BRAVOTEAM135/Quadcopter/Original Project/Documentation/Circuit Design/Gerber/Quadcopter Schematic Rev 001_drill.txt

; NON-PLATED HOLES START AT T1
; THROUGH (PLATED) HOLES START AT T100
M48
INCH
T1C0.165354
T100C0.038000
T101C0.040000
T102C0.036000
%
T1
X027750Y027739
X027750Y001739
X001750Y027739
X001750Y001739
T100
X004750Y007739
X023750Y007739
X004750Y011739
X023750Y011739
X022750Y007739
X022750Y011739
X006750Y005739
X005750Y005739
X024750Y005739
X004750Y009739
X023750Y009739
X004750Y013739
X022750Y009739
X006750Y007739
X006750Y011739
X005750Y007739
X024750Y007739
X005750Y011739
X024750Y011739
X006750Y009739
X004750Y005739
X023750Y005739
X006750Y013739
X005750Y009739
X024750Y009739
X022750Y005739
X005750Y013739
T101
X006750Y019739
X022750Y020739
X022750Y021739
X022750Y018739
X006750Y020739
X022750Y019739
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
