BRAVOTEAM135/Quadcopter/Original Project/Documentation/Circuit Design/Gerber/Quadcopter Schematic Rev 001_pnp.txt

*Pick And Place List
*Company=
*Author=
*eMail=
*
*Project=Quadcopter Schematic Rev 001
*Date=14:08:56
*CreatedBy=Fritzing 0.9.2b.11.19.8d2d5970658f0bed09c661c9ea9a515b5f40f44c
*
*
*Coordinates in mm, always center of component
*Origin 0/0=Lower left corner of PCB
*Rotation in degree (0-360, math. pos.)
*
*No;Value;Package;X;Y;Rotation;Side;Name
1;;THT;14.6053;-24.7382;-90;Bottom;ELEV
2;;;5.46016;-24.4603;0;Bottom;TXT2
3;;;70.4853;-4.4182;0;Bottom;Hole3
4;;THT;14.6053;-34.8982;-90;Bottom;THRO
5;;;38.7486;-70.4971;0;Bottom;TXT3
6;;THT;58.2933;-51.5352;0;Bottom;IMU
7;;THT;14.6053;-14.5782;-90;Bottom;AUX
8;;;5.40315;-29.6391;0;Bottom;TXT2
9;;THT;14.6053;-19.6582;-90;Bottom;ALIE
10;;;60.1238;-58.5074;0;Bottom;TXT4
11;;;8.35918;-58.1035;0;Bottom;TXT4
12;;THT;16.6373;-52.5512;180;Bottom;Digital IO
13;;;68.8646;-29.6391;0;Bottom;TXT2
14;;;64.3621;-55.0948;0;Bottom;TXT4
15;;;64.295;-47.449;0;Bottom;TXT4
16;;;64.3039;-52.6872;0;Bottom;TXT4
17;;;6.63331;-52.5137;0;Bottom;TXT4
18;;;69.775;-14.2737;0;Bottom;TXT2
19;;;6.23352;-55.3668;0;Bottom;TXT4
20;;;4.44528;-4.4182;0;Bottom;Hole4
21;;THT;60.3253;-19.6582;90;Bottom;M3
22;;;6.69178;-14.5088;0;Bottom;TXT2
23;;;36.9816;-11.2472;0;Bottom;TXT3
24;;THT;60.3253;-14.5782;90;Bottom;M4
25;;;37.4653;-34.8897;0;Bottom;Arduino Nano
26;;;69.3093;-24.7501;0;Bottom;TXT2
27;;;6.93445;-47.3326;0;Bottom;TXT4
28;;THT;60.3253;-29.8182;90;Bottom;M1
29;;;70.4853;-70.4582;0;Bottom;Hole1
30;;;5.55471;-34.7823;0;Bottom;TXT2
31;;THT;60.3253;-24.7382;90;Bottom;M2
32;;;65.0683;-50.3021;0;Bottom;TXT4
33;;;4.44528;-70.4582;0;Bottom;Hole2
34;;;5.40315;-19.7447;0;Bottom;TXT2
35;;THT;14.6053;-29.8182;-90;Bottom;RUDD
36;;;69.5421;-19.9775;0;Bottom;TXT2
37;;;6.92541;-50.1263;0;Bottom;TXT4
