BRAVOTEAM135/Quadcopter/Original Project/Documentation/PCB Design.docx

Track width

Thin: 1A

Normal: 1.5A

Thick: 2A

Extra thick: 2.5A
