BRAVOTEAM135/Quadcopter/Documentation/Quadcopter research_.docx

Quadcopter

Motor and propellor research

What I need is a motor and propellor combination that will provide 500g or more lift per motor.

Parameters

- Length of prop

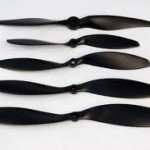
[picture p24: figure]

Propellers are available in different diameters and pitches (tilting). Check frame size and choose a motor.

Standard quadcopter propeller sizes:

EPP1045 diameter 10in and pitch 4.5

APC1047 diameter 10in and pitch 4.7

EPP0845 diameter 8in and pitch 4.5

EPP1245 diameter 12in and pitch 4.5 (larger quads/greater thrust)

EPP0938 diameter 9in and pitch 3.8 (smaller quads)

Guide Rules to follow:

larger diameter and pitch = more thrust the propeller can generate

requires more power to drive it, but it will lift more weight.

high RPM motors best with smaller or mid-sized propellers.

low RPM motors best with larger propellers otherwise will fail to lift the quad at low speed.

- Pitch of prop
- Motor kv (I believe this is the rpm per volt we have 11.1v battery)

Max current draw per motor 20amp as I want to use a 20 amp ESC (electronic speed controller) but I do have 30amp esc 8f we need to go higher we can although my wiring is rated for 30amp.

Possible options

NTM Prop Drive Series 2826 1000kv (£9.89)

Weight 54g

ESC 20-30a

9x4.7 - 11.1v - 113W - 10.2A - 0.632kg thrust

9x6 - 14.8v - 220w - 14.9A - 0.937kg thrust

Accessories pack

NTM Prop Drive 28 series accessories pack (£1.28)

ESC

Hobbywing X-Rotor ESC 40amp (OPTO) (£10)

Propellers

9x4.7 CW (£0.99)

9x4.7 CCW (£0.99)

BOM (Bill of Materials)

[x5] Hobbywing X-Rotor ESC - 40amp (OPTO)

http://www.hobbyking.com/hobbyking/store/__73080__Hobbywing_X_Rotor_ESC_40amp_OPTO_.html

[x5] NTM Prop Drive 28-26 1000KV / 235W

http://www.hobbyking.com/hobbyking/store/__21478__NTM_Prop_Drive_28_26_1000KV_235W.html

[x4] NTM Prop Drive 28 Series Accessory Pack

http://www.hobbyking.com/hobbyking/store/__16719__NTM_Prop_Drive_28_Series_Accessory_Pack.html

[x1] HobbyKing™ Slowfly Propeller 9x4.7 Black (CCW) (4pcs)

http://www.hobbyking.co.uk/hobbyking/store/__22442__HobbyKing_8482_Slowfly_Propeller_9x4_7_Black_CCW_4pcs_.html

[x1] Turnigy Slowfly Propeller 9x4.7 Black (CW) (4pcs)

http://www.hobbyking.co.uk/hobbyking/store/__34084__Turnigy_Slowfly_Propeller_9x4_7_Black_CW_4pcs_.html

Cost £3.44

54g. *Sunday 10/01/16 (Is this total weight for 4 propellers? Or is this the weight of a single propeller).

Test 08/01/16

With d2830-11 turnigy aerodrive 1000kv

Turnigy plush 30a

10x4.5 propellers

Static weight 1130g (this is the weight of the quad stationary).

Throttling up to about 95% throttle close to 10a draw total from all 4 motors. Scales read 500g

This implies that approx 630g of lift is being generated.

This suggests to me that the motors can be pushed harder I will look into the software to ensure I am allowing for max throttle value is being passed through and scaled correctly through the controller board.

Statement of next test

- Use 34084 Turnigy Slowfly Propeller 9in x pitch 4 7 Black CW
- Shall we try:
- http://www.hobbyking.co.uk/hobbyking/store__46967__HobbyKing_8482_Thin_E_Prop_Propeller_10x5_2pcs_.html
- £1.41per 2 blades. Available CCW and CW I assume!
- Throttle directly to 95%, 10a current draw on all 4 motors.
- Read scales:
- What was the rpm?
- Can you set a date for this test?

Radio RX for thrust test rig

OrangeRx R615X DSM2/DSMX Compatible 6Ch 2.4GHz Receiver w/CPPM

http://www.hobbyking.co.uk/hobbyking/store/__46632__OrangeRx_R615X_DSM2_DSMX_Compatible_6Ch_2_4GHz_Receiver_w_CPPM.html

5V 5A UBEC 2-5S Lipoly (7.2-21v)

http://www.hobbyking.co.uk/hobbyking/store/__18789__5V_5A_UBEC_2_5S_Lipoly_7_2_21v_.html

Note

Current draw is defined by

Larger proper and larger pitch will give larger current draw

Uni t ut203

Useful links

Watch dog http://www.megunolink.com/articles/how-to-detect-lockups-using-the-arduino-watchdog/
