BRAVOTEAM135/Quadcopter/Documentation/System Diagram.docx

GND

3.3

5.0

TXD

RXD

KEY

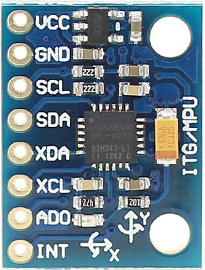
[picture p44: figure]

10K

20K
