BRAVOTEAM135/Quadcopter/Original Project/Documentation/Old/System Diagram.pdf

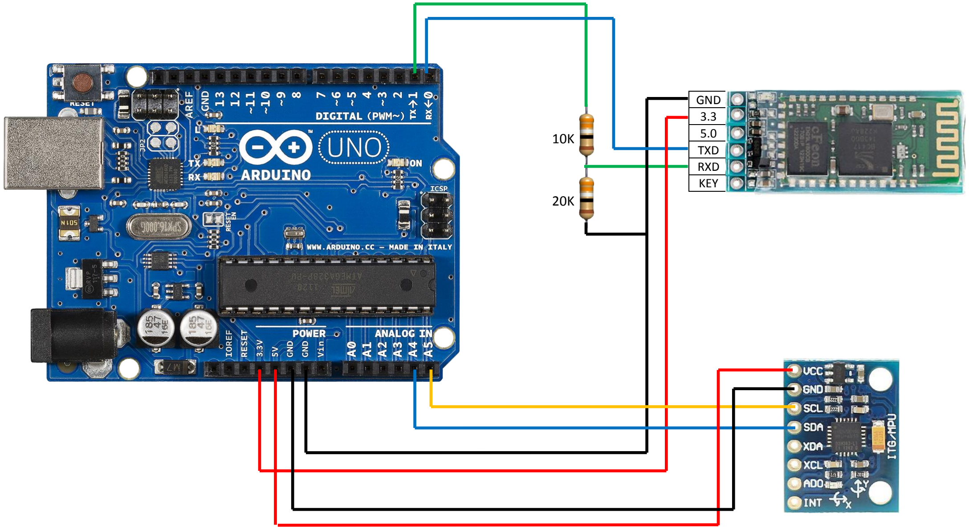
[picture p46: figure]
GND 3.3 5.0 TXD RXD KEY
