BRAVOTEAM135/Quadcopter/Documentation/image-1.png

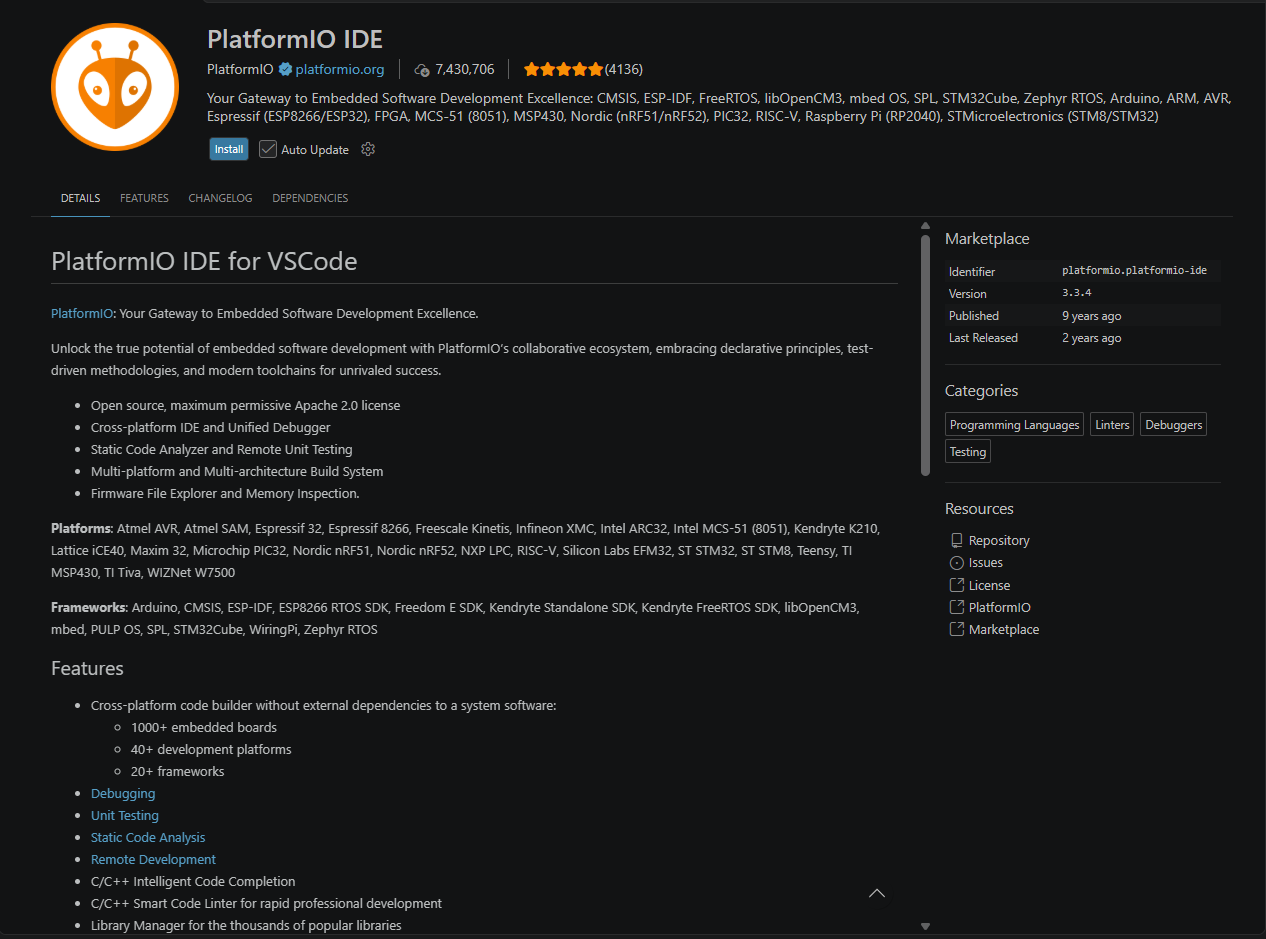
Documentation/image-1.png
