BRAVOTEAM135/Quadcopter/Documentation/Turnigy Plush Music.jpg

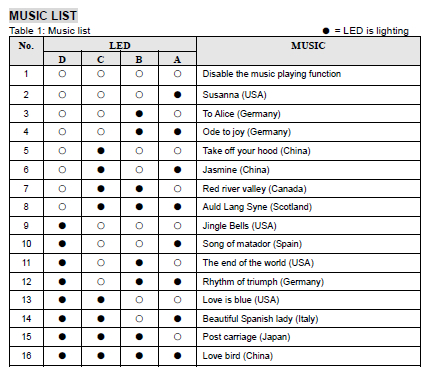
Documentation/Turnigy Plush Music.jpg
