BRAVOTEAM135/Quadcopter/Original Project/Photos/20130726_211317.jpg

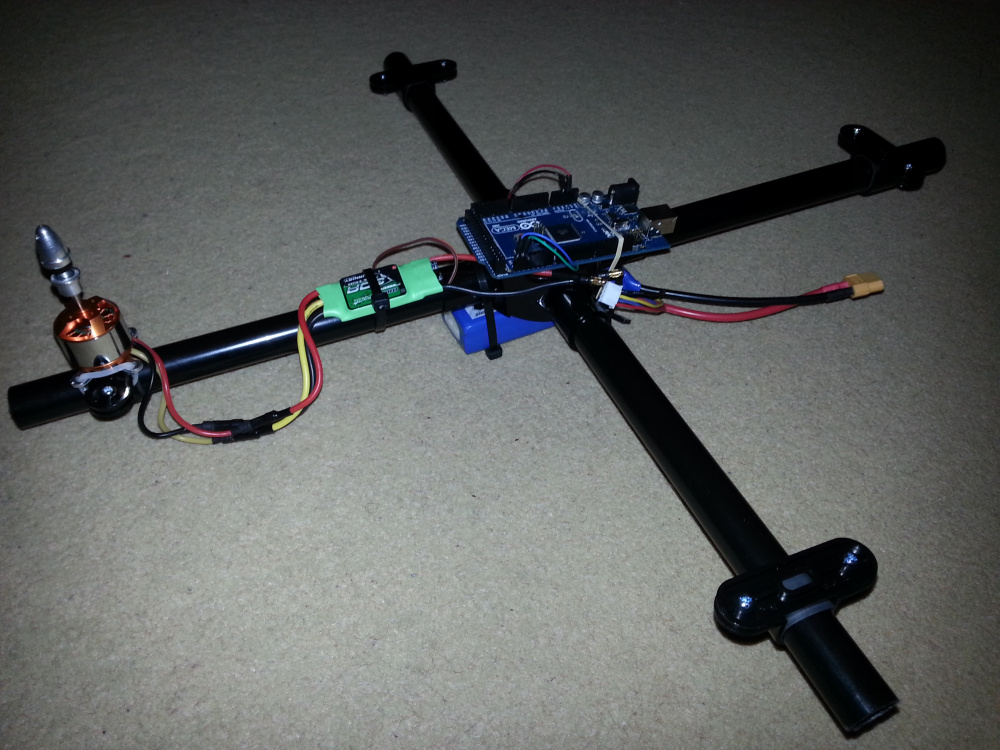
Original Project/Photos/20130726_211317.jpg
