BRAVOTEAM135/Quadcopter/Original Project/Photos/20130726_214608.jpg

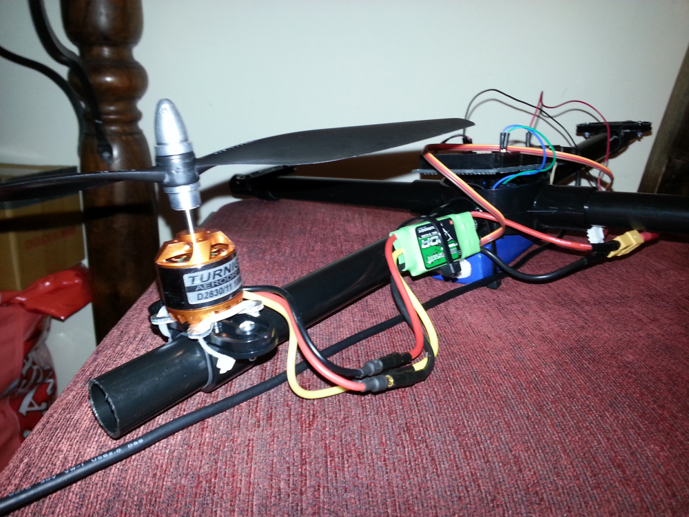
Original Project/Photos/20130726_214608.jpg
