BRAVOTEAM135/Quadcopter/Original Project/Photos/20130829_122756.jpg

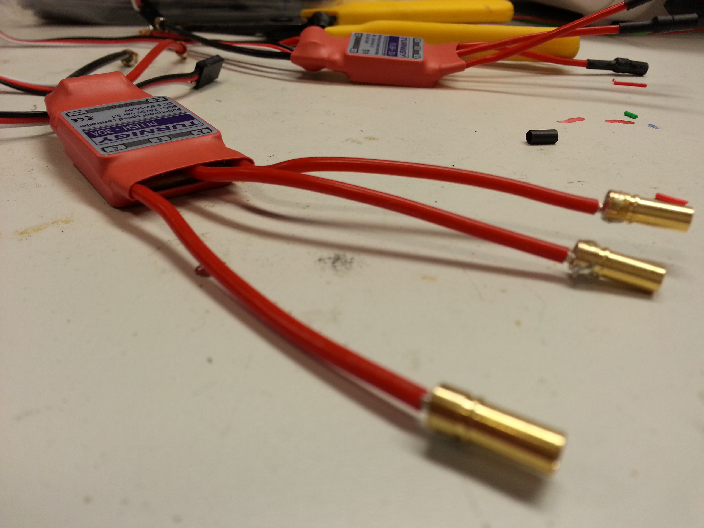
Original Project/Photos/20130829_122756.jpg
