BRAVOTEAM135/Quadcopter/Original Project/Photos/20130829_214918.jpg

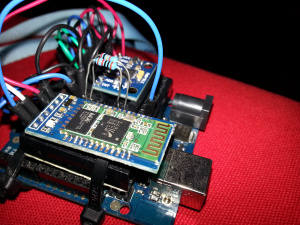
Original Project/Photos/20130829_214918.jpg
