BRAVOTEAM135/Quadcopter/Original Project/Photos/20130904_192124.jpg

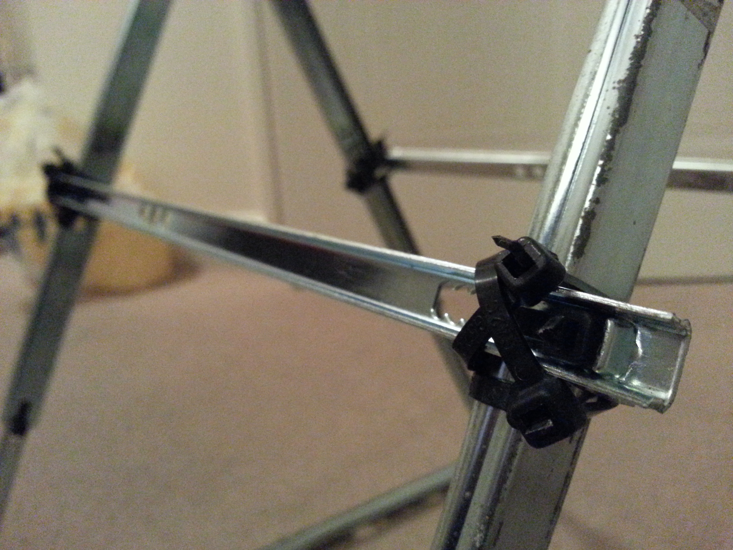
Original Project/Photos/20130904_192124.jpg
