BRAVOTEAM135/Quadcopter/Original Project/Photos/20130904_192246.jpg

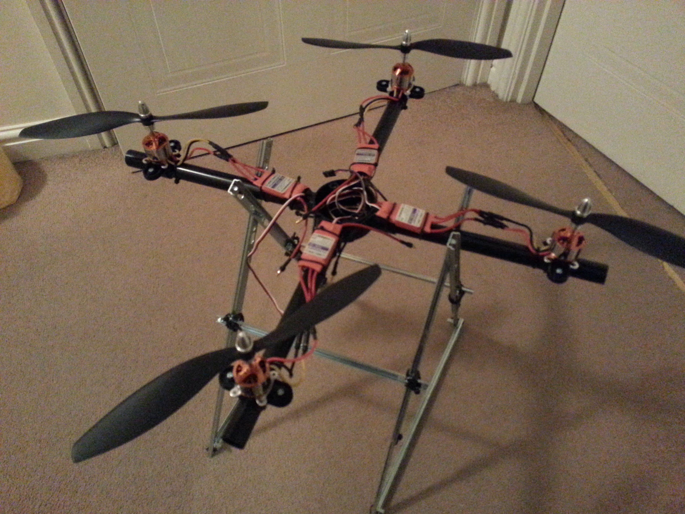
Original Project/Photos/20130904_192246.jpg
