BRAVOTEAM135/Quadcopter/Original Project/Photos/capture.png

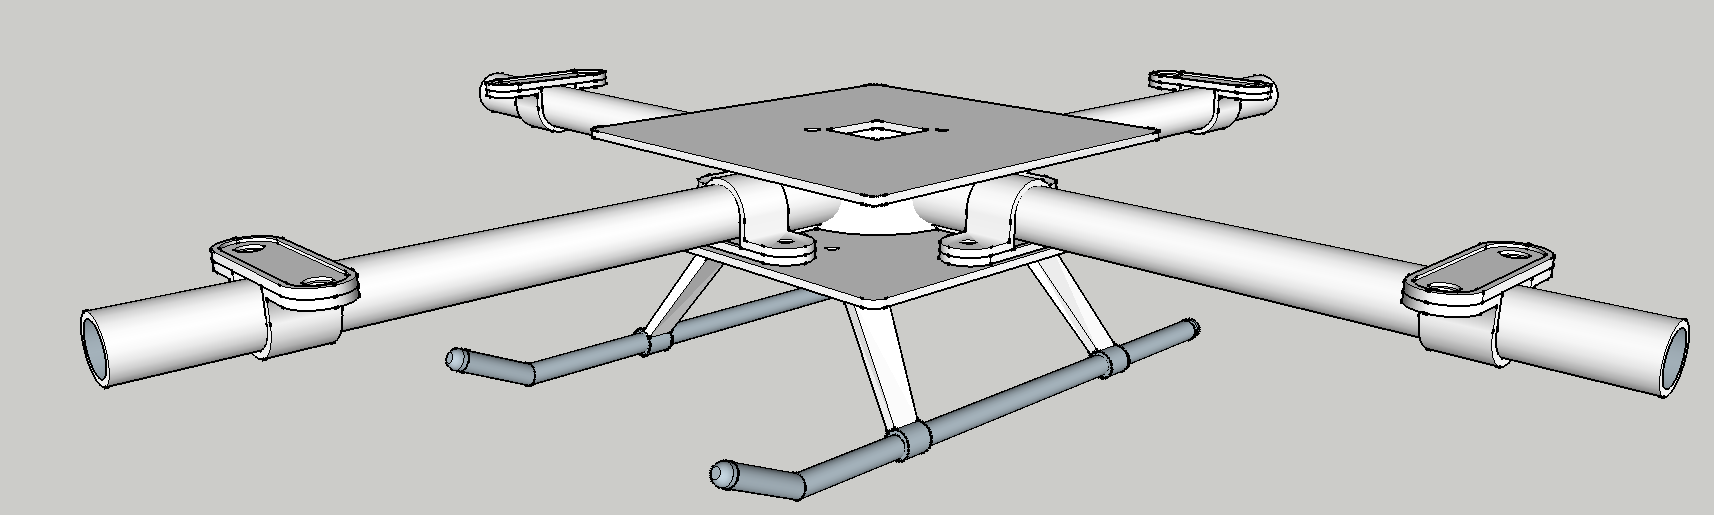
Original Project/Photos/capture.png
