BRAVOTEAM135/Quadcopter/Original Project/Photos/Diamond Quadcopter Model 0002.png

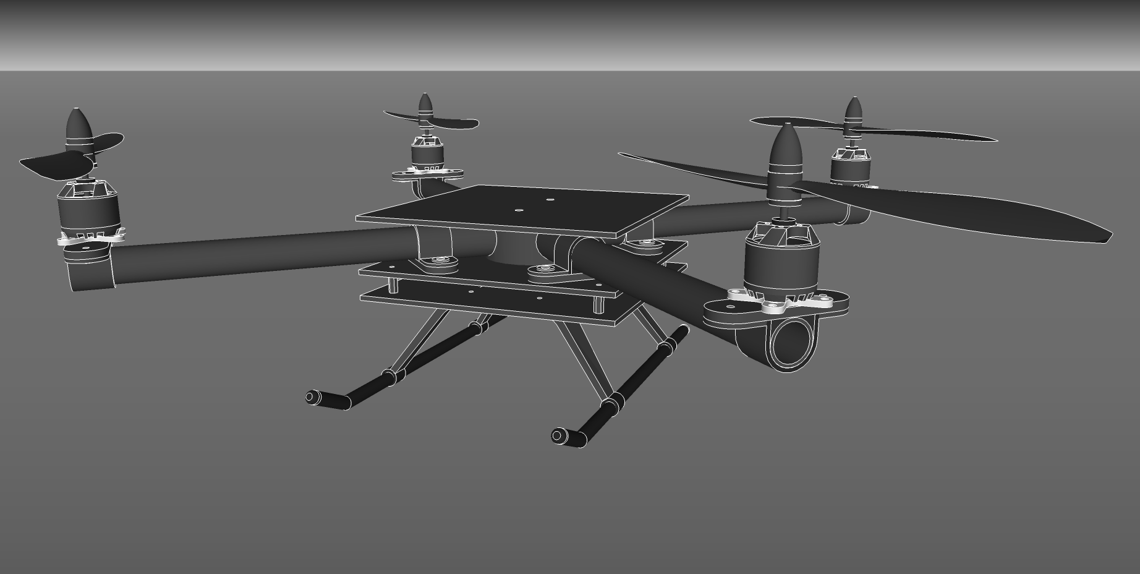
Original Project/Photos/Diamond Quadcopter Model 0002.png
