BRAVOTEAM135/Quadcopter/Original Project/Photos/Diamond Quadcopter Model hand.png

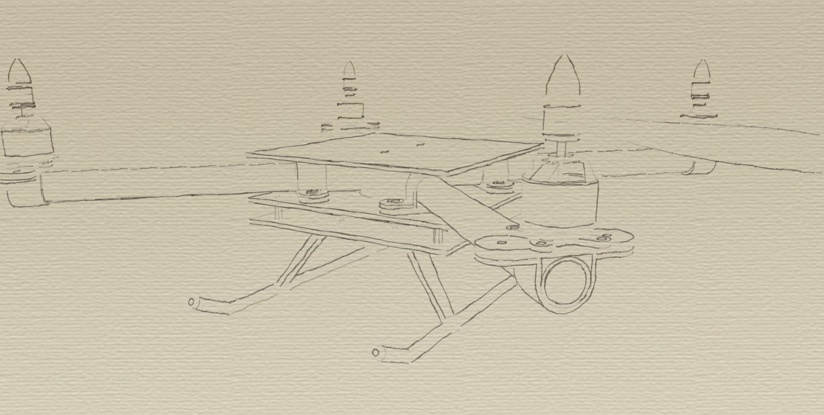
Original Project/Photos/Diamond Quadcopter Model hand.png
