BRAVOTEAM135/Quadcopter/Original Project/Photos/Diamond Quadcopter Model tech pen 2.png

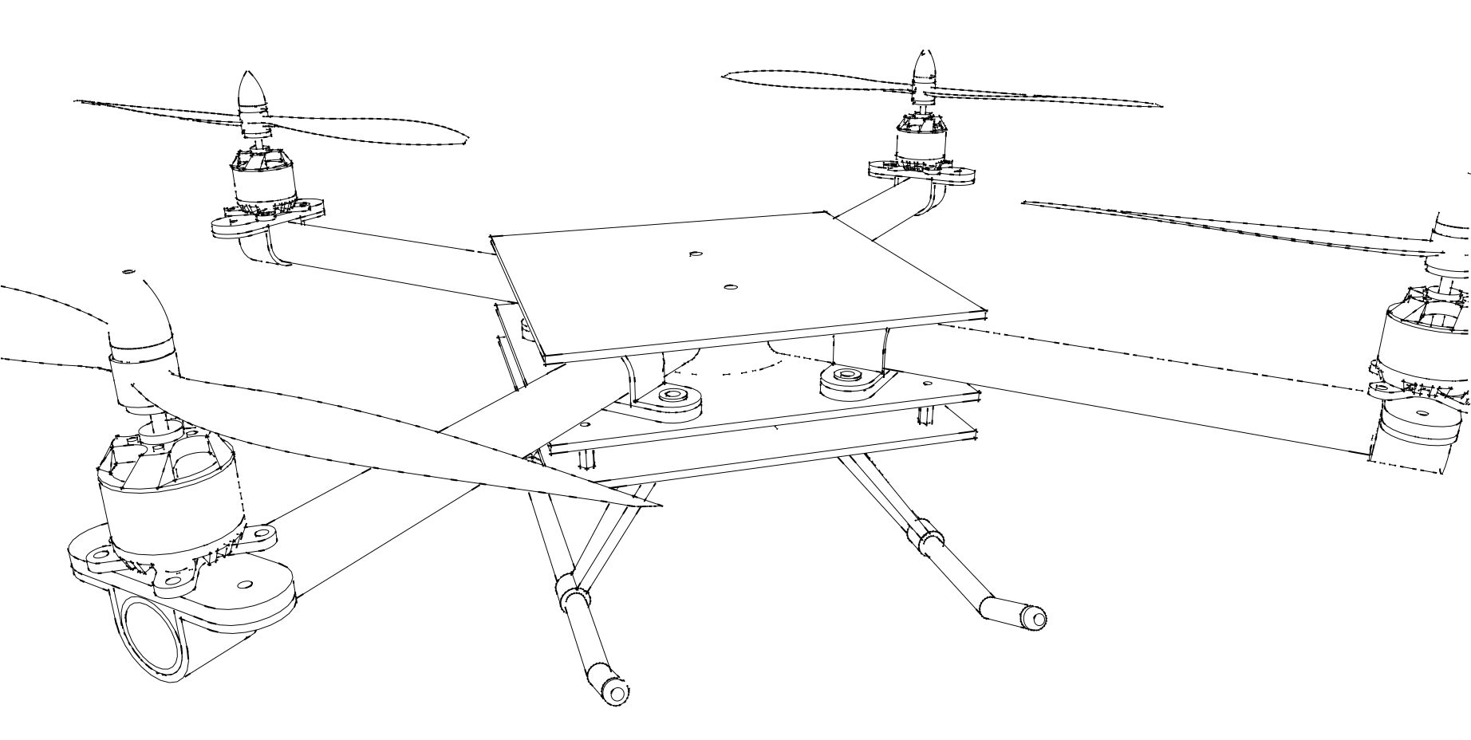
Original Project/Photos/Diamond Quadcopter Model tech pen 2.png
