BRAVOTEAM135/Quadcopter/Original Project/Photos/Diamond Quadcopter Model tech pen 3.png

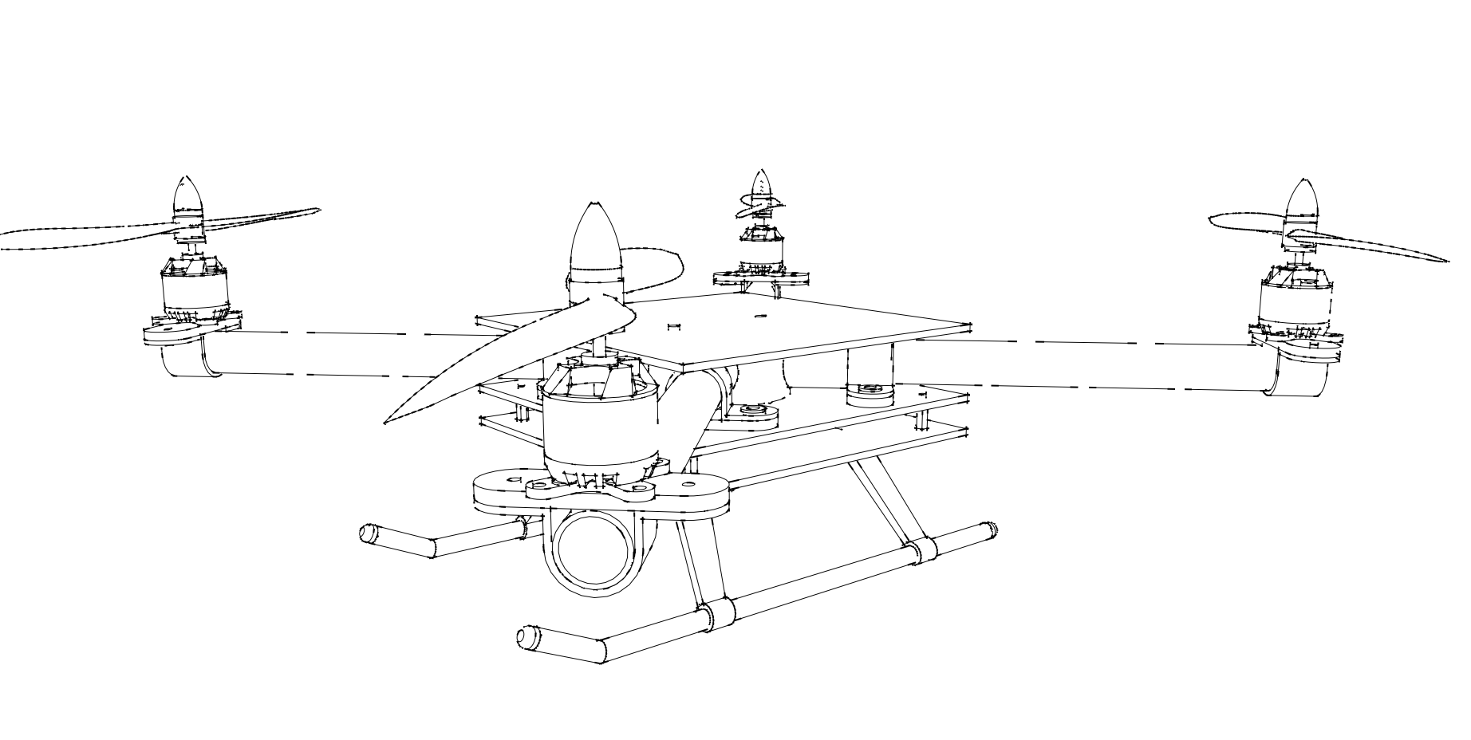
Original Project/Photos/Diamond Quadcopter Model tech pen 3.png
