BRAVOTEAM135/Quadcopter/Original Project/Photos/Diamond Quadcopter Model TOP.png

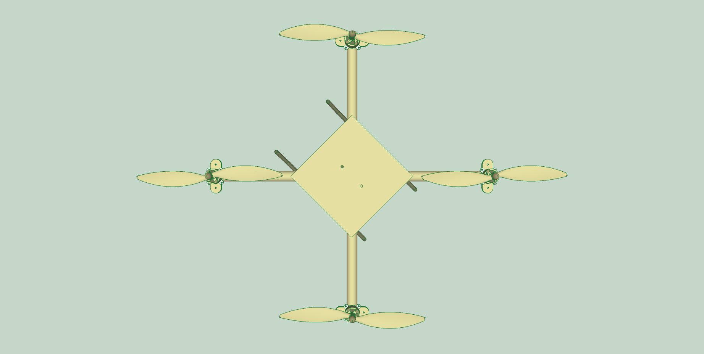
Original Project/Photos/Diamond Quadcopter Model TOP.png
