BRAVOTEAM135/Quadcopter/Original Project/Photos/Diamond Quadcopter Model v2 1.png

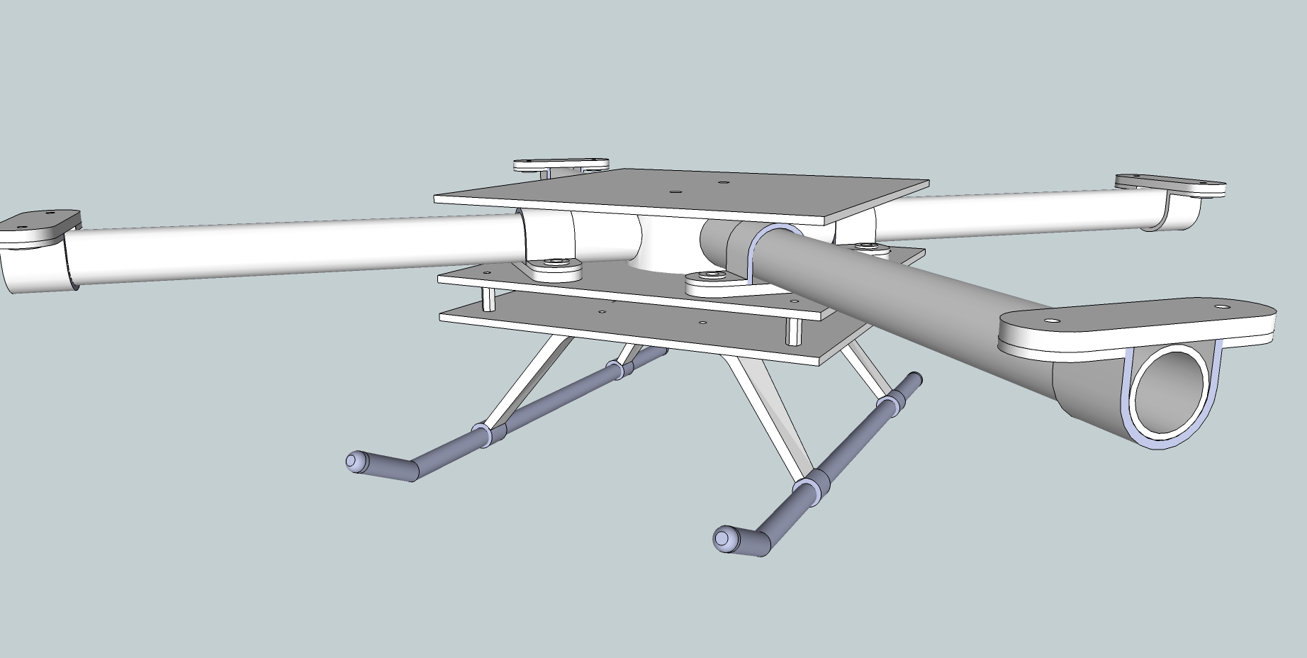
Original Project/Photos/Diamond Quadcopter Model v2 1.png
