BRAVOTEAM135/Quadcopter/Original Project/Photos/Diamond Quadcopter Model v2 front.png

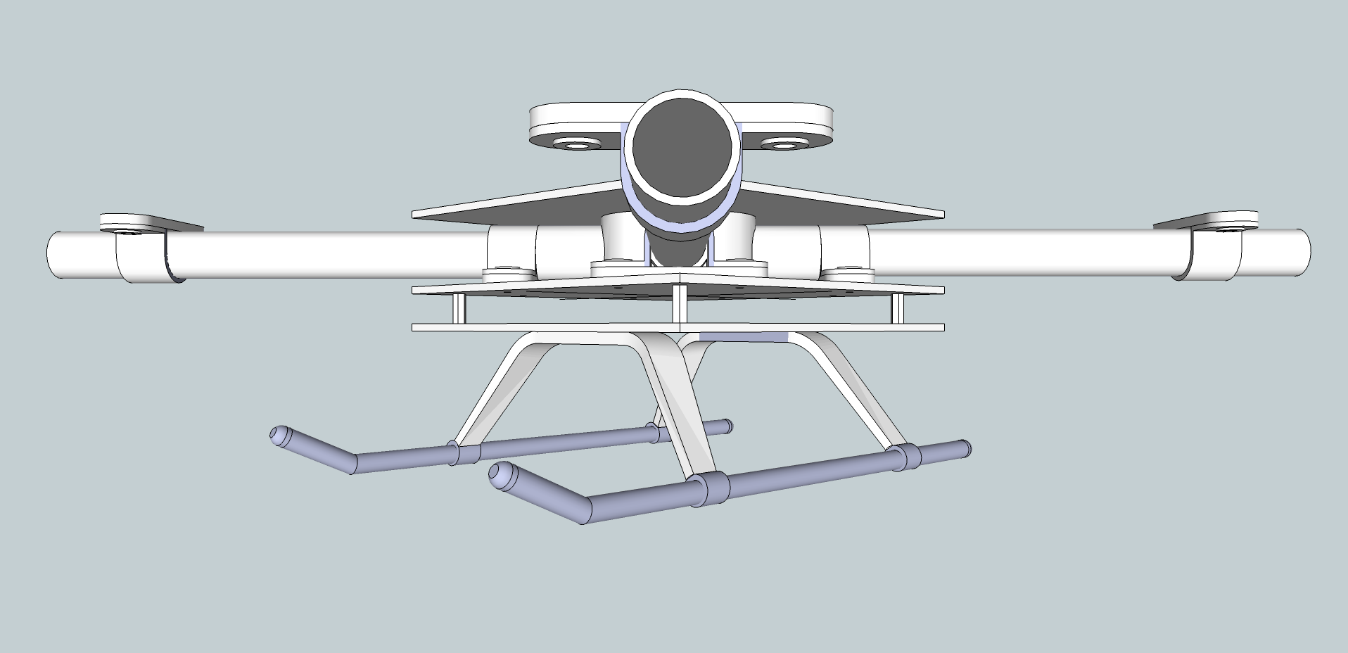
Original Project/Photos/Diamond Quadcopter Model v2 front.png
