BRAVOTEAM135/Quadcopter/Original Project/Photos/Diamond Quadcopter Model v2.png

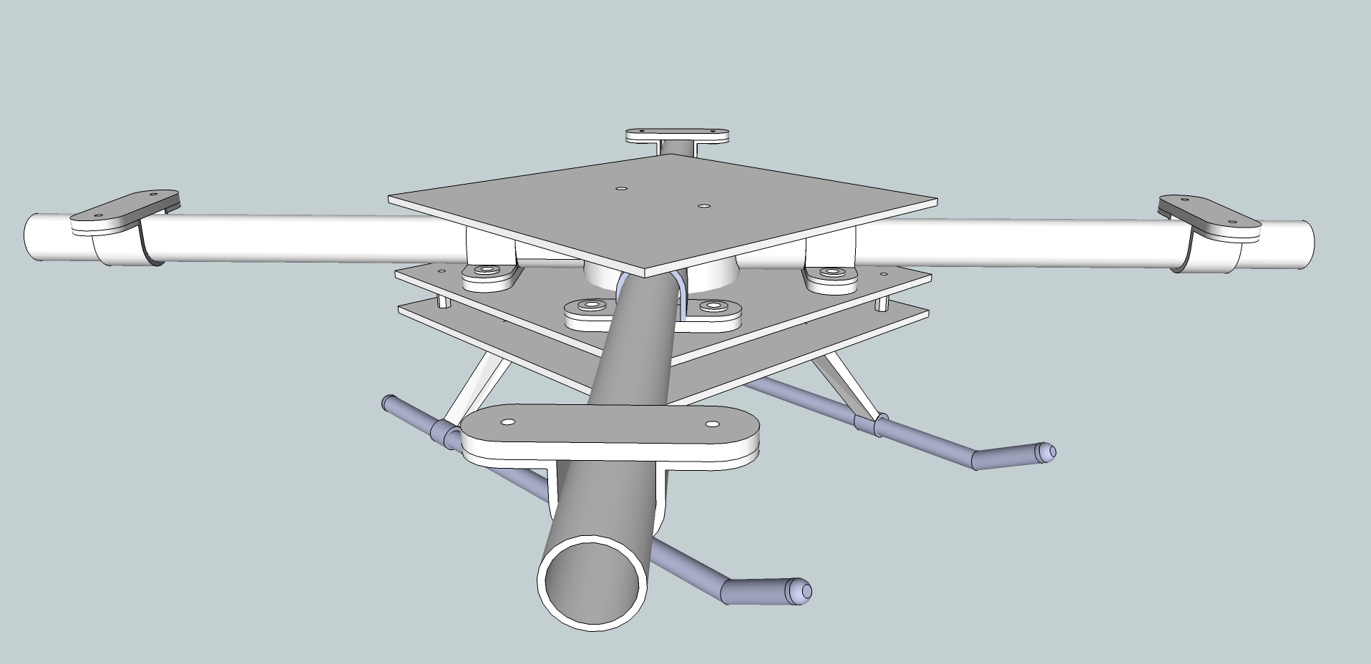
Original Project/Photos/Diamond Quadcopter Model v2.png
