BRAVOTEAM135/Quadcopter/Original Project/Photos/Diamond Quadcopter Model v3 002.png

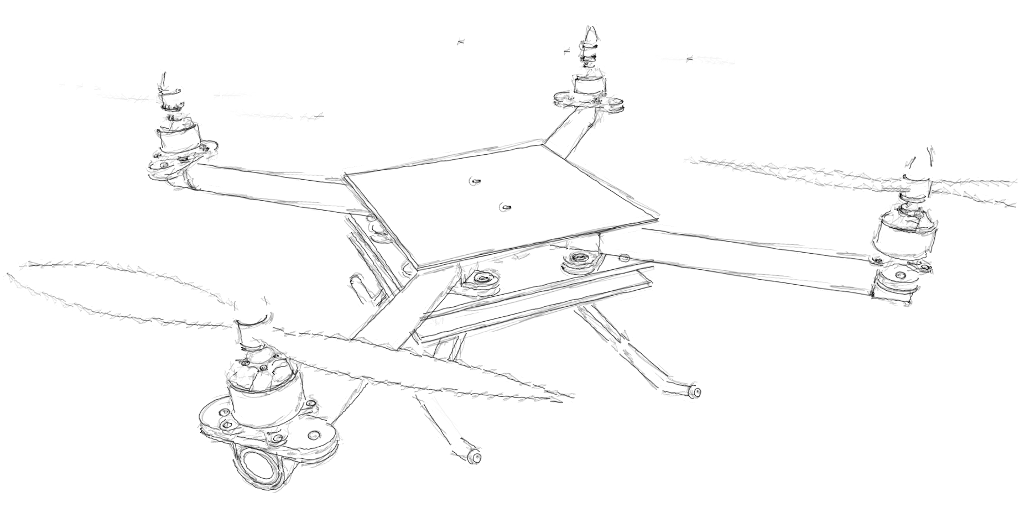
Original Project/Photos/Diamond Quadcopter Model v3 002.png
