BRAVOTEAM135/Quadcopter/Original Project/Photos/Diamond Quadcopter Model v3 003.png

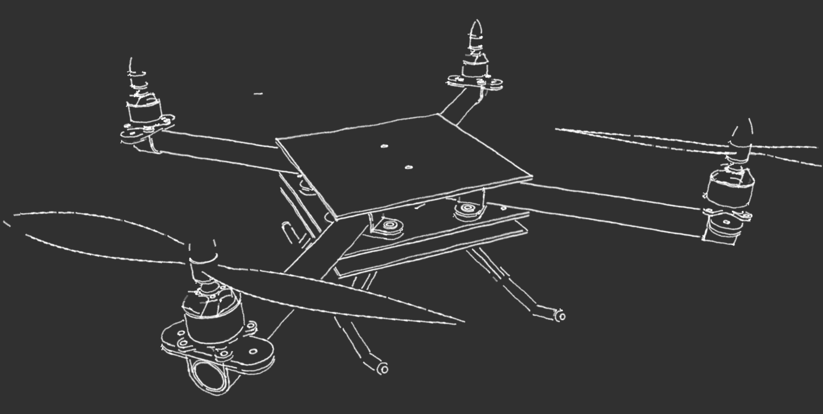
Original Project/Photos/Diamond Quadcopter Model v3 003.png
