BRAVOTEAM135/Quadcopter/Original Project/Photos/Diamond Quadcopter Model v3 007.png

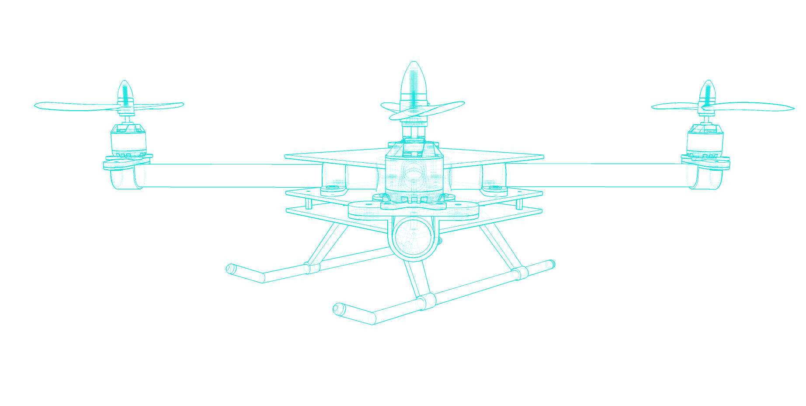
Original Project/Photos/Diamond Quadcopter Model v3 007.png
