BRAVOTEAM135/Quadcopter/Original Project/Photos/Diamond Quadcopter Model v3 014.png

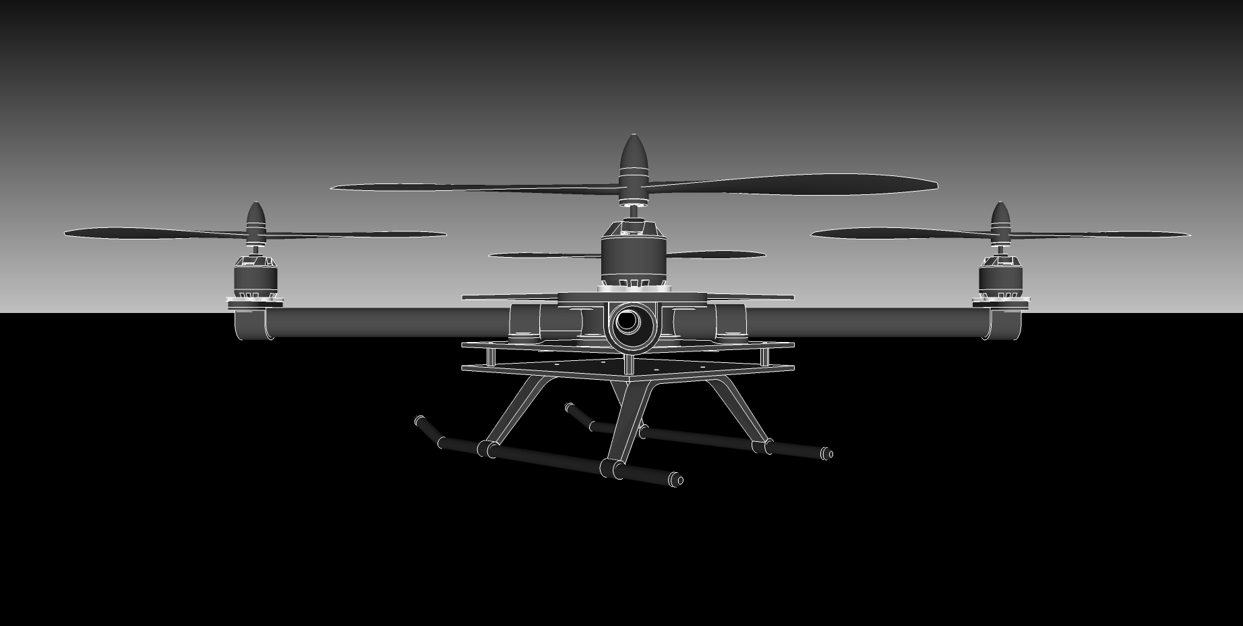
Original Project/Photos/Diamond Quadcopter Model v3 014.png
