BRAVOTEAM135/Quadcopter/Original Project/Photos/Diamond Quadcopter Model v3.jpg

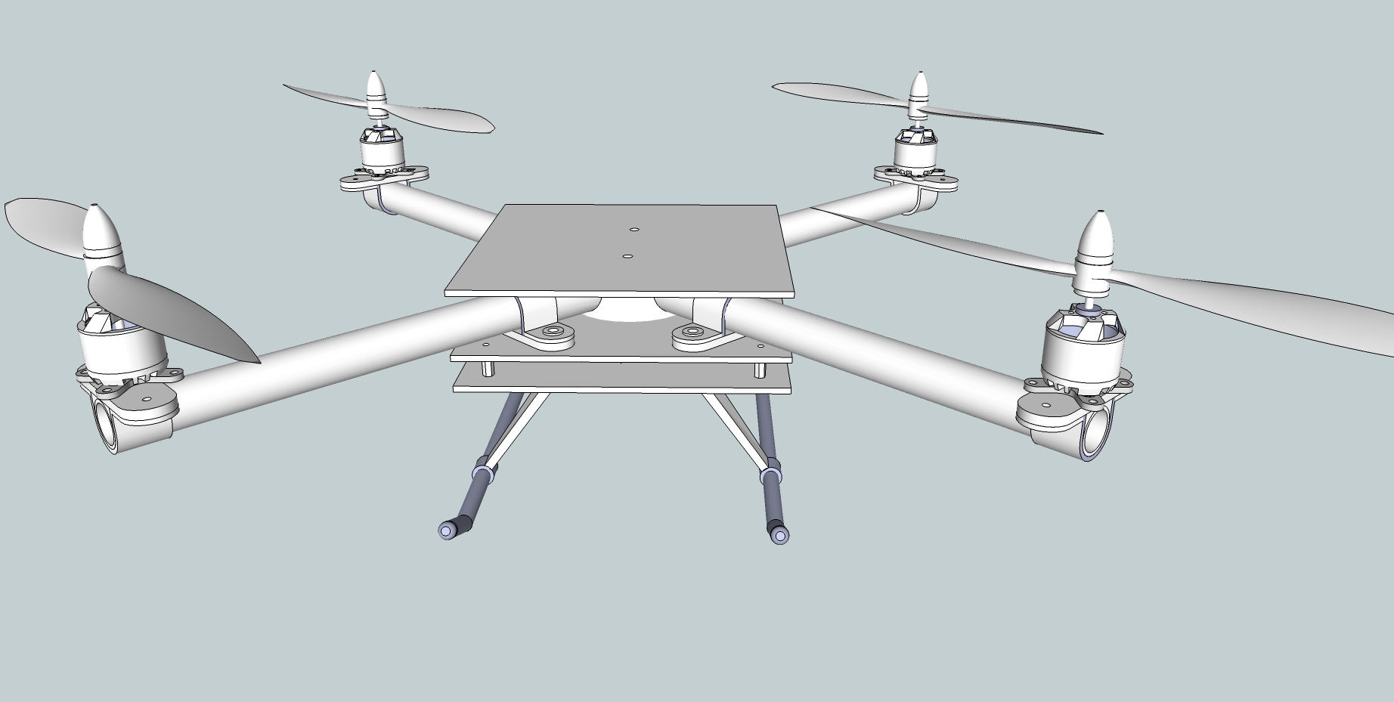
Original Project/Photos/Diamond Quadcopter Model v3.jpg
