BRAVOTEAM135/Quadcopter/Original Project/Photos/Diamond Quadcopter Model view 2.png

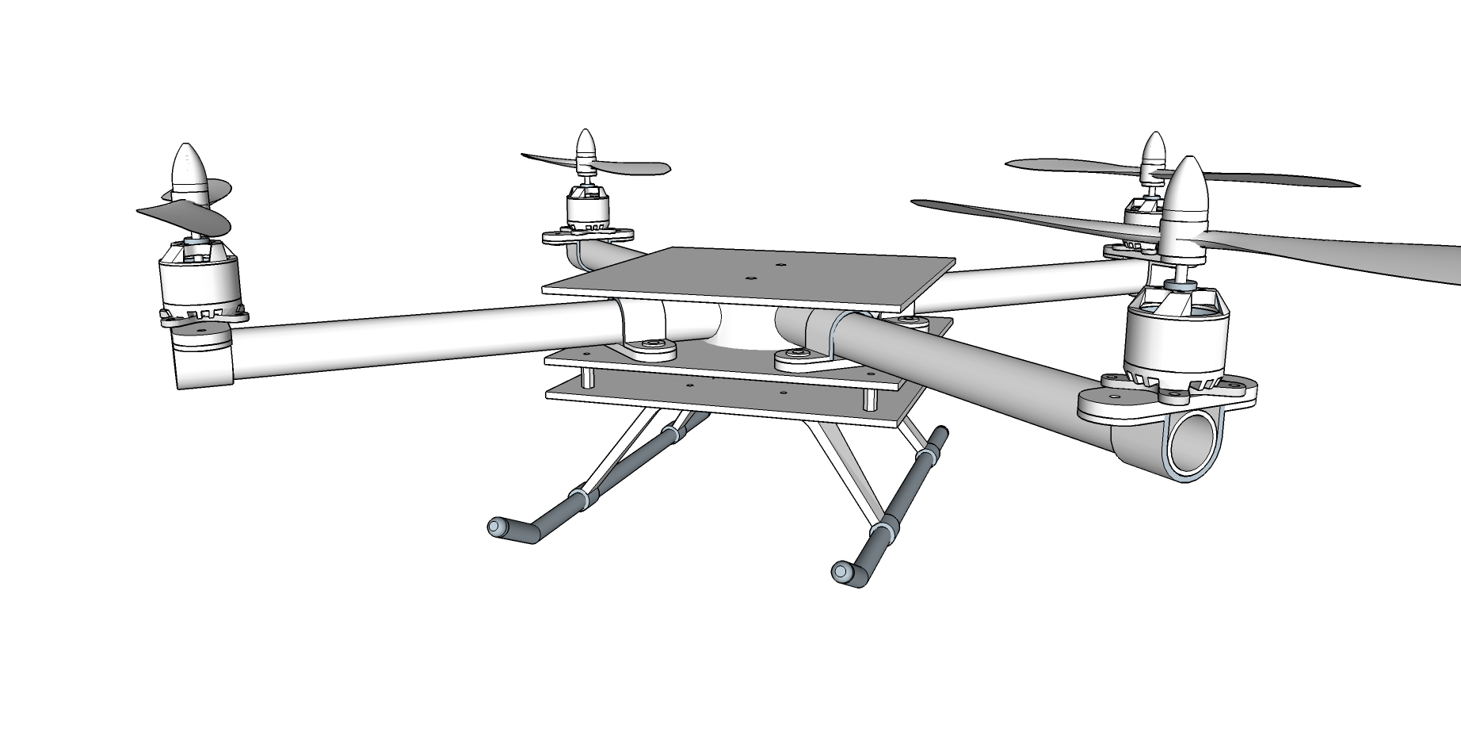
Original Project/Photos/Diamond Quadcopter Model view 2.png
