BRAVOTEAM135/Quadcopter/Original Project/Photos/Gyro Rate Graphs/Gryro Graph 2.PNG

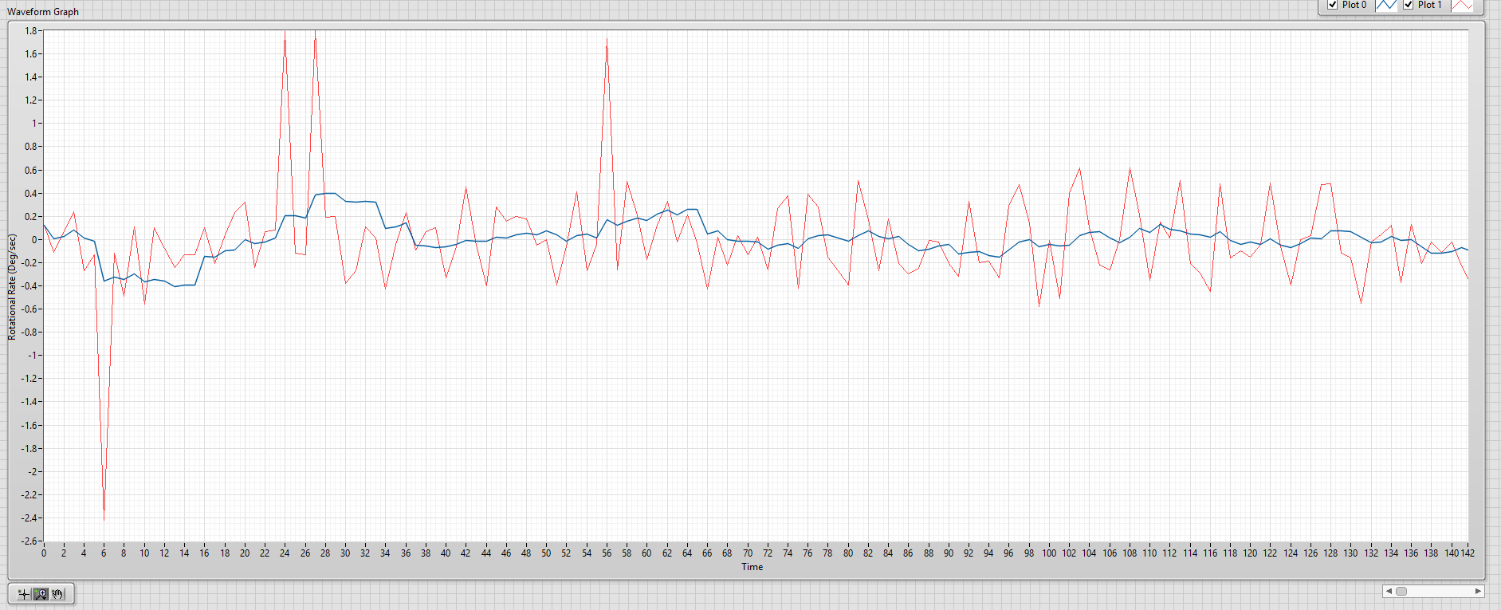
Original Project/Photos/Gyro Rate Graphs/Gryro Graph 2.PNG
