BRAVOTEAM135/Quadcopter/Original Project/Photos/Prop 10x4 in work.jpg

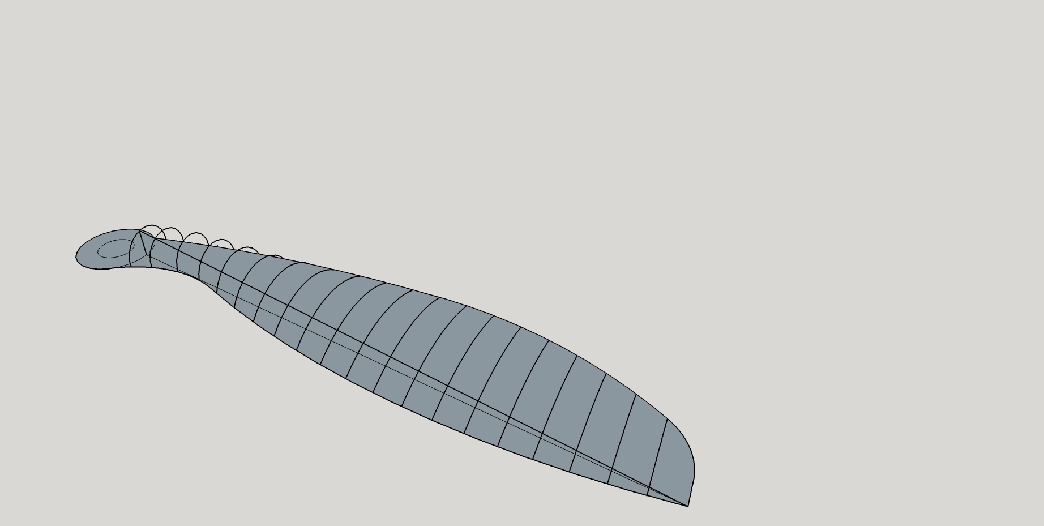
Original Project/Photos/Prop 10x4 in work.jpg
