BRAVOTEAM135/Quadcopter/Original Project/Photos/Rig Design2.png

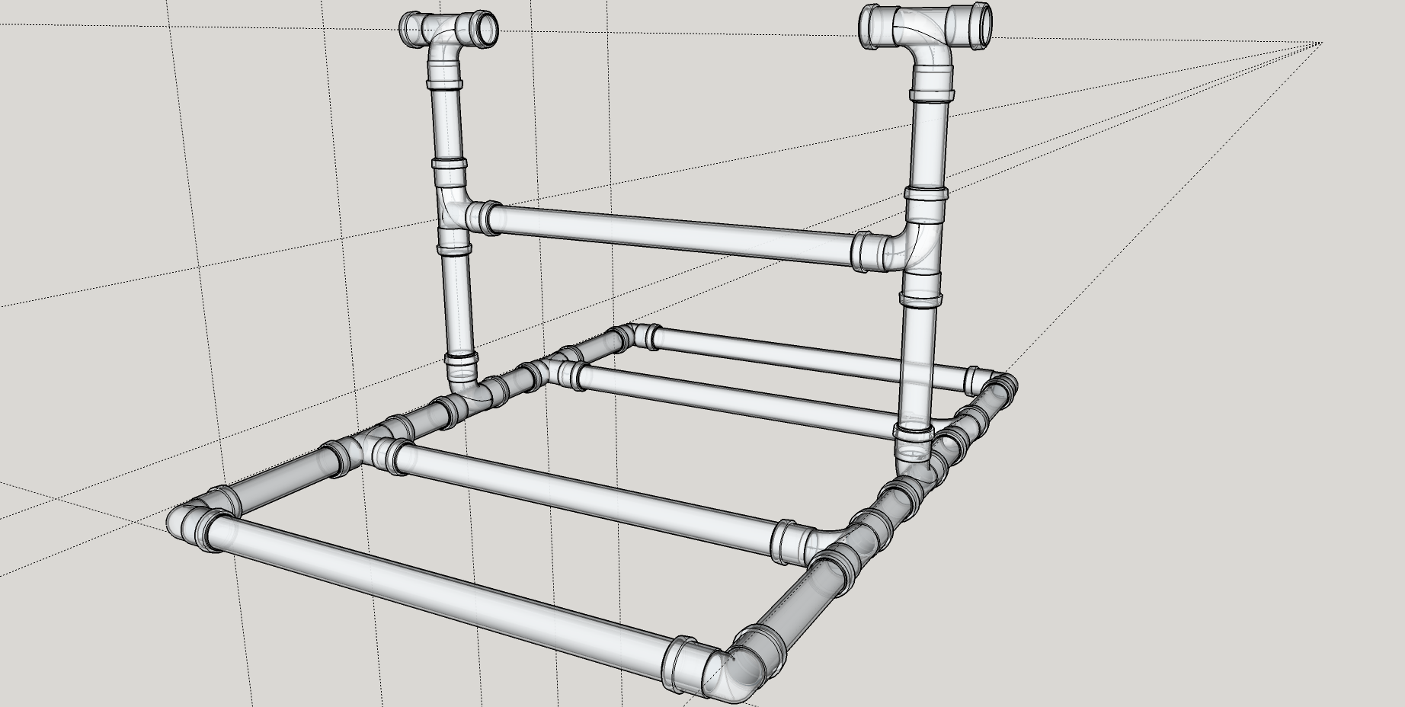
Original Project/Photos/Rig Design2.png
