BRAVOTEAM135/Quadcopter/Original Project/Photos/Rig Design4.png

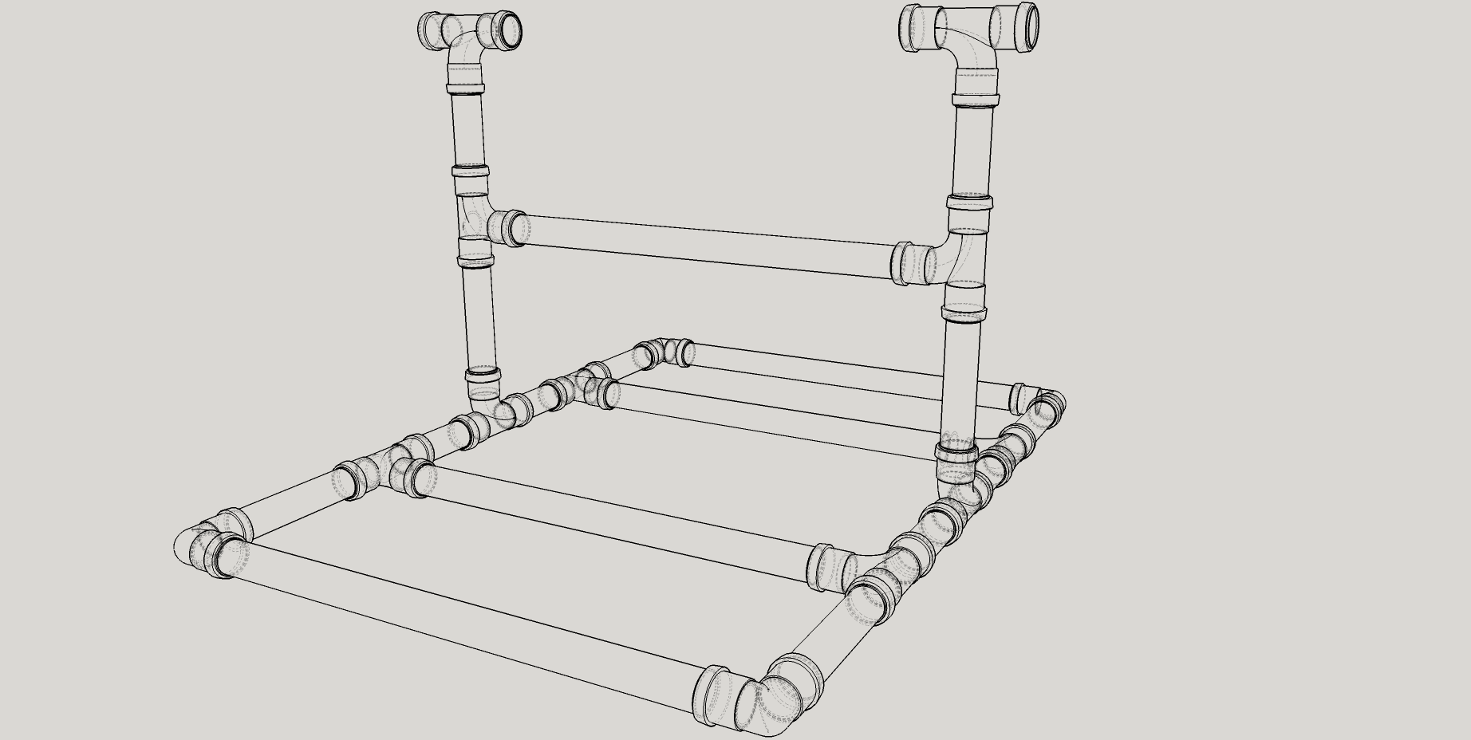
Original Project/Photos/Rig Design4.png
