BRAVOTEAM135/Quadcopter/Original Project/Photos/Rig Design5.png

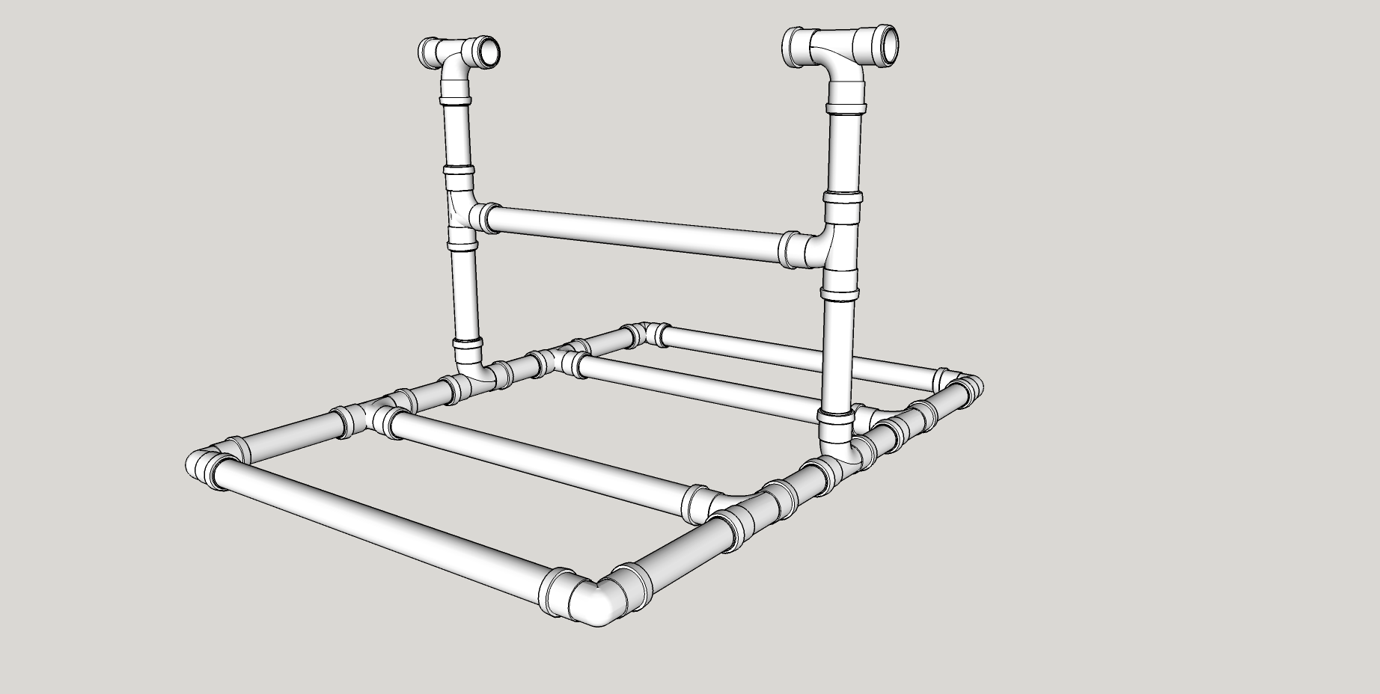
Original Project/Photos/Rig Design5.png
