BRAVOTEAM135/Quadcopter/Original Project/Photos/Rig With Quad 30 deg.png

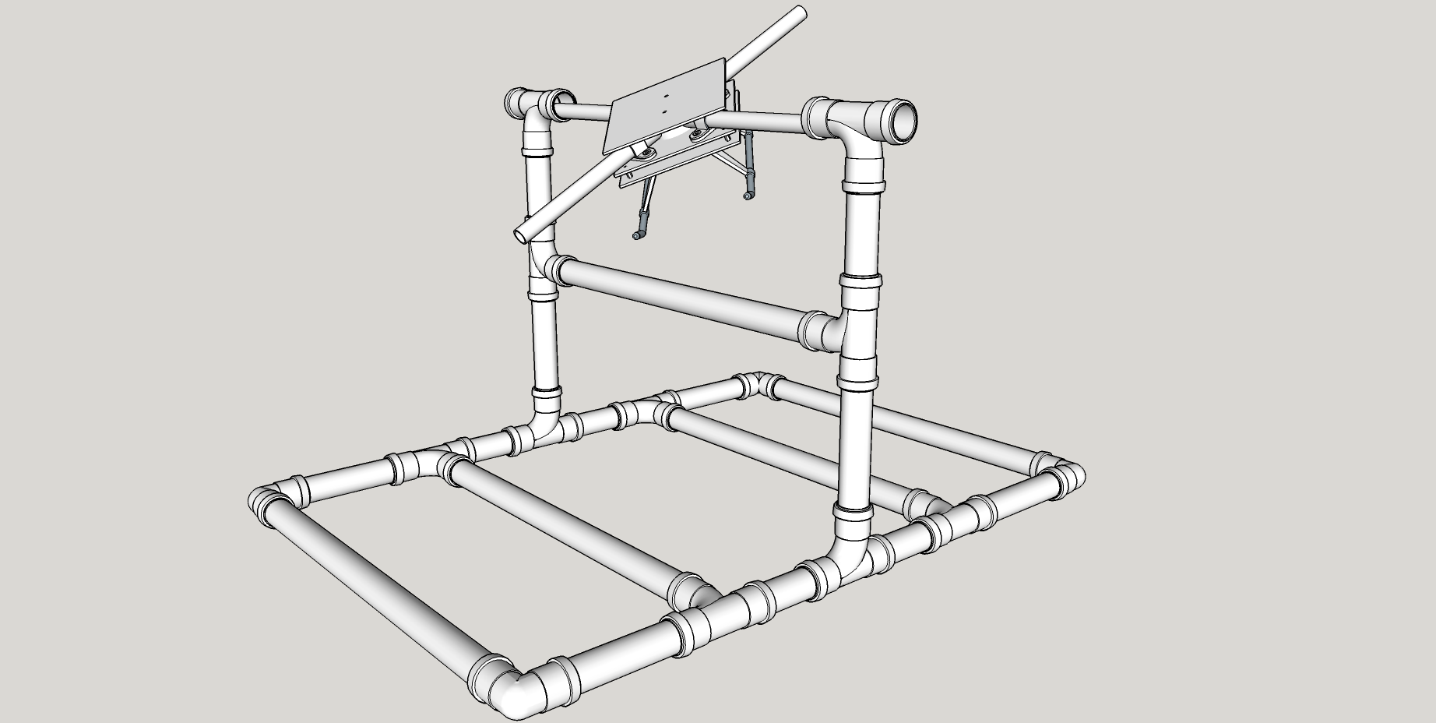
Original Project/Photos/Rig With Quad 30 deg.png
