BRAVOTEAM135/Quadcopter/Photos/20130726_194225.jpg

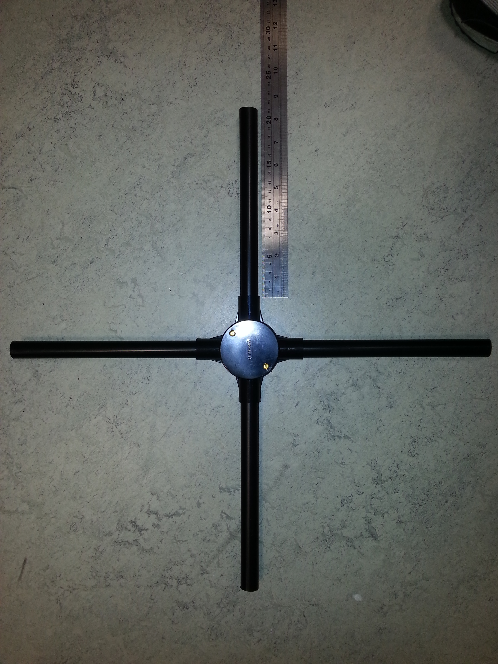
Photos/20130726_194225.jpg
