BRAVOTEAM135/Quadcopter/Photos/20130827_125758.jpg

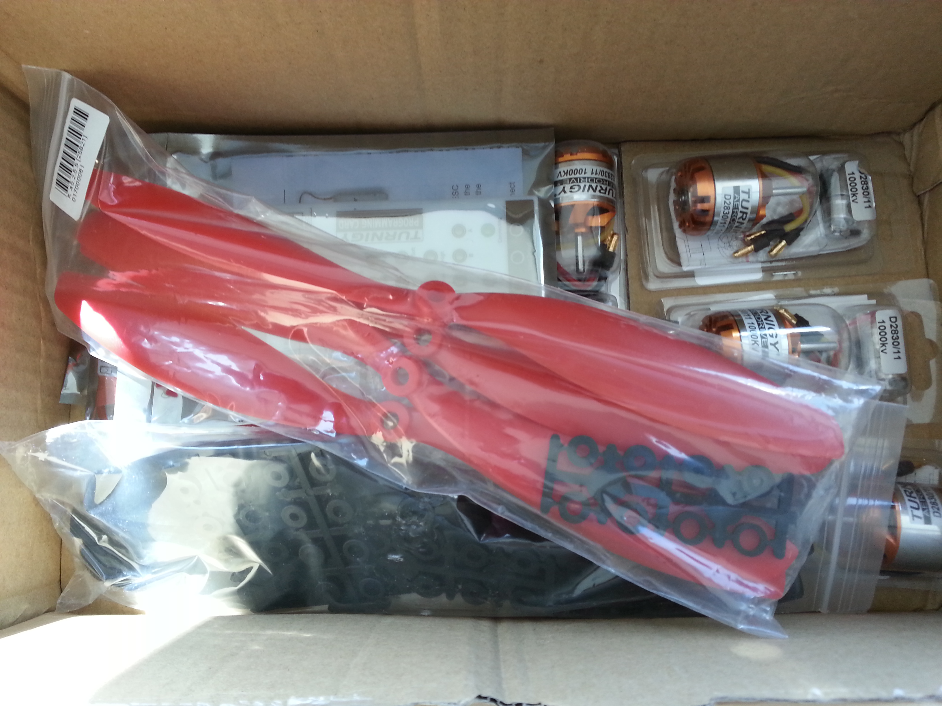
Photos/20130827_125758.jpg
