BRAVOTEAM135/Quadcopter/Photos/20130904_192106.jpg

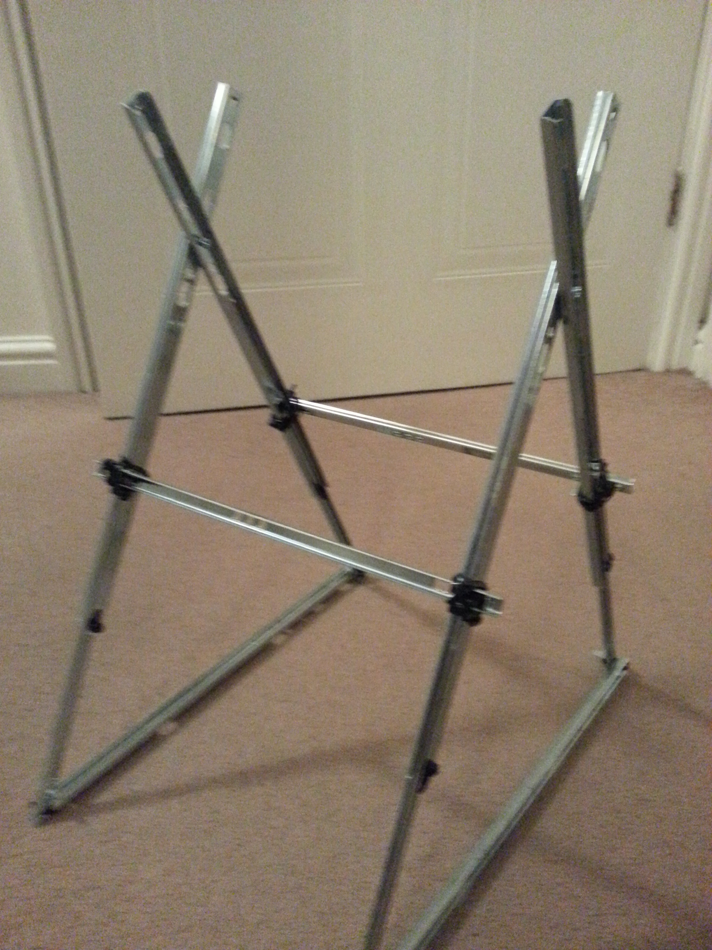
Photos/20130904_192106.jpg
