BRAVOTEAM135/Quadcopter/Photos/20131029_181602.jpg

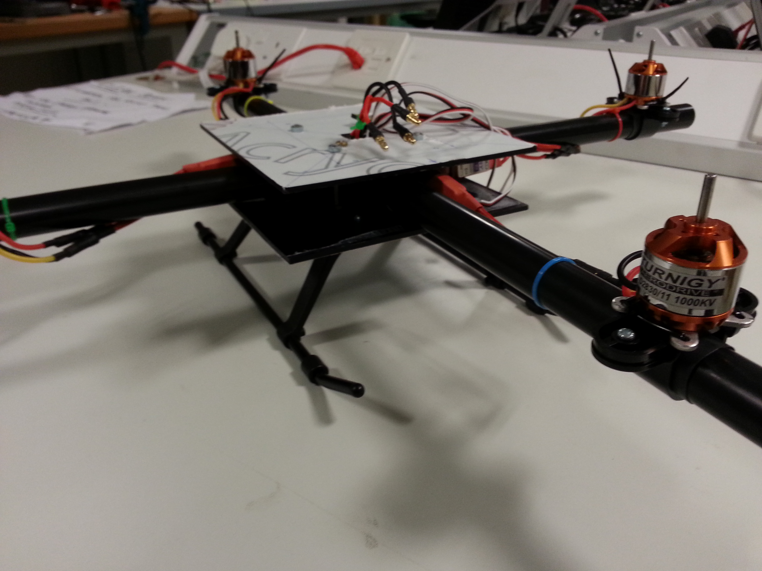
Photos/20131029_181602.jpg
