BRAVOTEAM135/Quadcopter/Photos/Diamond Quadcopter Model 0001.png

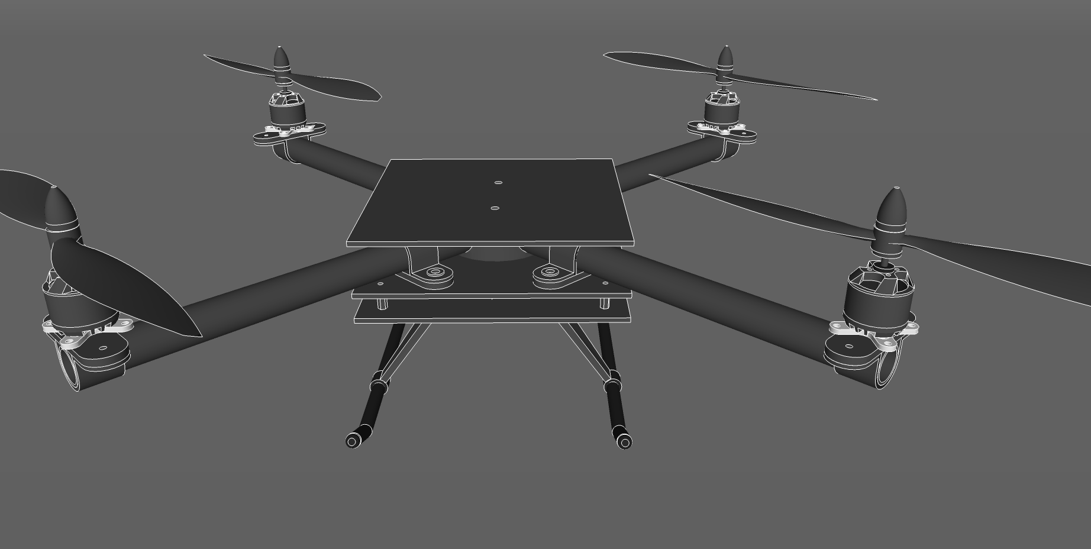
Photos/Diamond Quadcopter Model 0001.png
