BRAVOTEAM135/Quadcopter/Photos/Diamond Quadcopter Model 0003.png

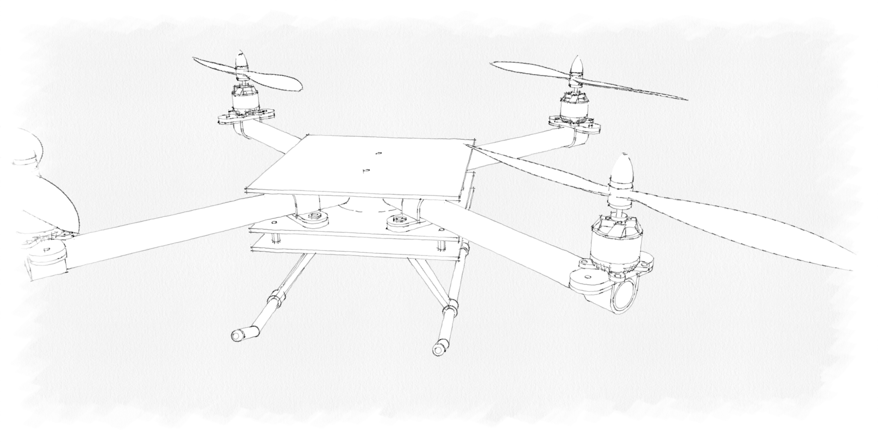
Photos/Diamond Quadcopter Model 0003.png
