BRAVOTEAM135/Quadcopter/Photos/Diamond Quadcopter Model FRONT.png

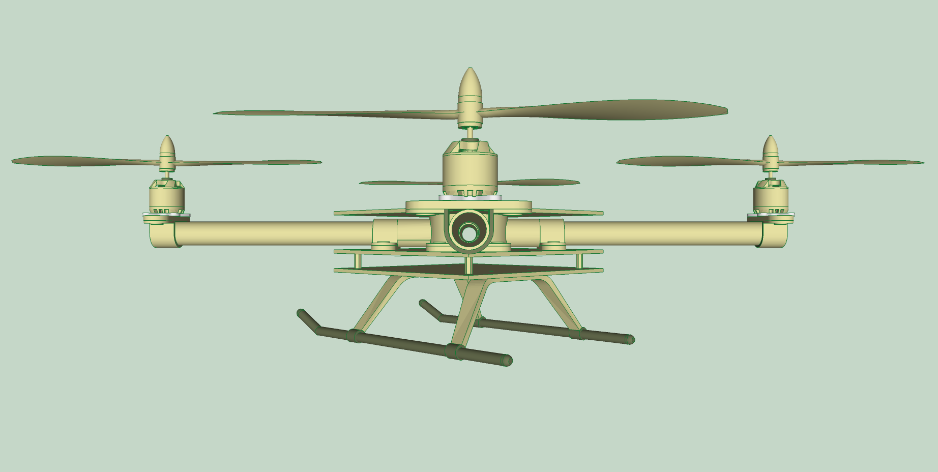
Photos/Diamond Quadcopter Model FRONT.png
