BRAVOTEAM135/Quadcopter/Photos/Diamond Quadcopter Model ISO.png

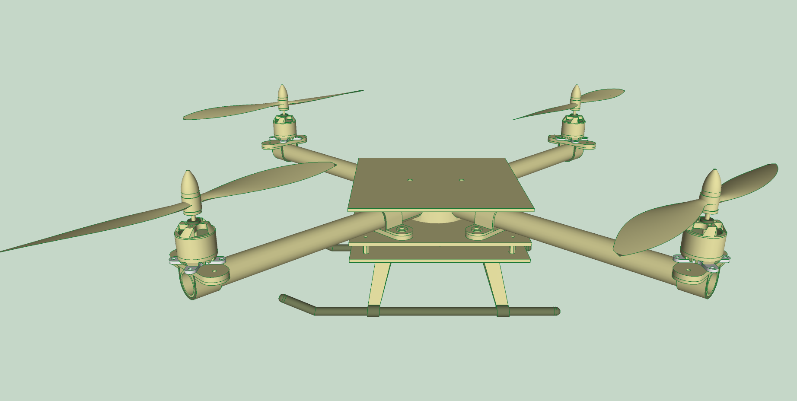
Photos/Diamond Quadcopter Model ISO.png
