BRAVOTEAM135/Quadcopter/Photos/Diamond Quadcopter Model Photo.png

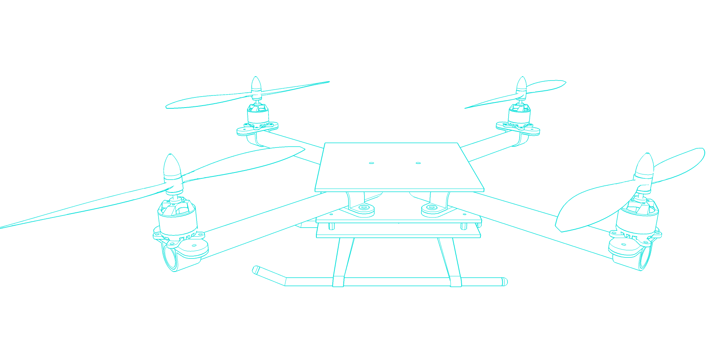
Photos/Diamond Quadcopter Model Photo.png
