BRAVOTEAM135/Quadcopter/Photos/Diamond Quadcopter Model Red.png

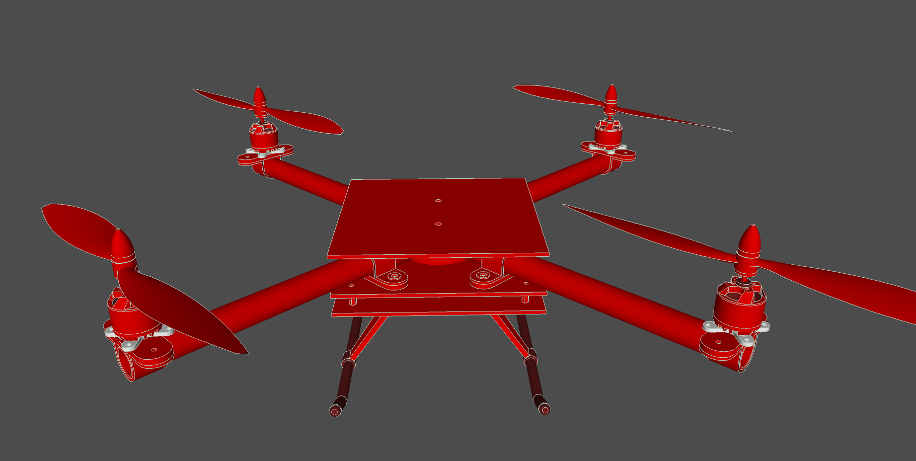
Photos/Diamond Quadcopter Model Red.png
