BRAVOTEAM135/Quadcopter/Photos/Diamond Quadcopter Model tech pen.png

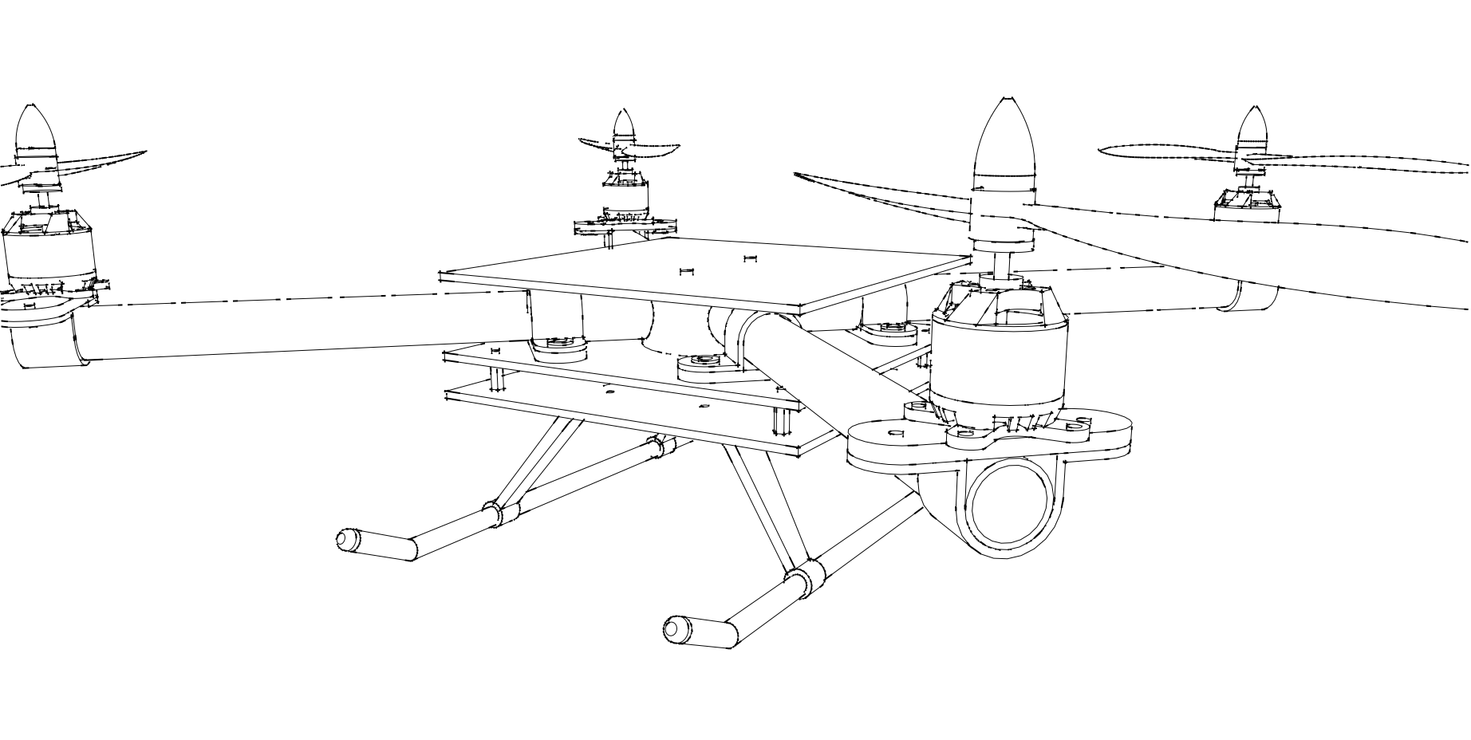
Photos/Diamond Quadcopter Model tech pen.png
