BRAVOTEAM135/Quadcopter/Photos/Diamond Quadcopter Model v2 2.png

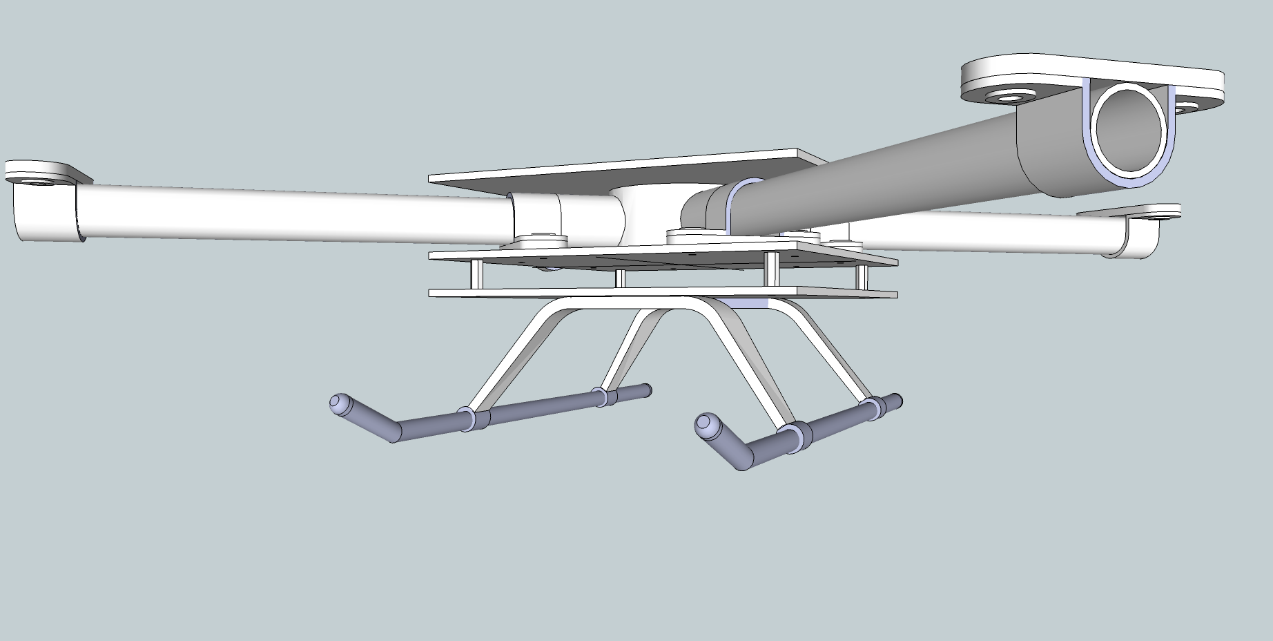
Photos/Diamond Quadcopter Model v2 2.png
