BRAVOTEAM135/Quadcopter/Photos/Diamond Quadcopter Model v2 3.png

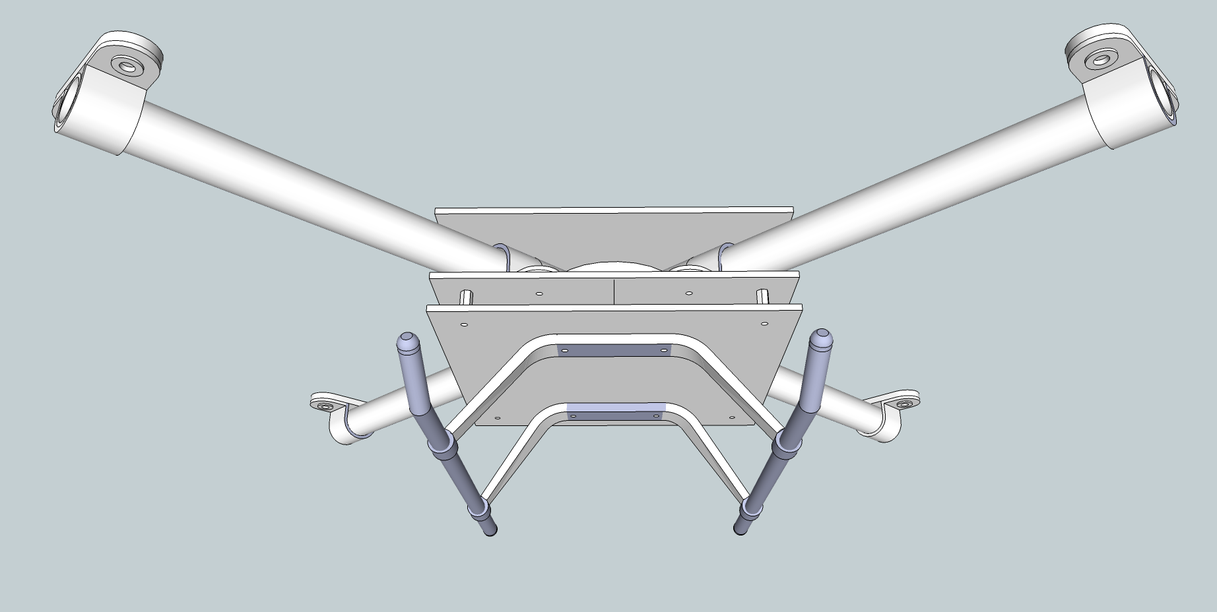
Photos/Diamond Quadcopter Model v2 3.png
