BRAVOTEAM135/Quadcopter/Photos/Diamond Quadcopter Model v2 4.png

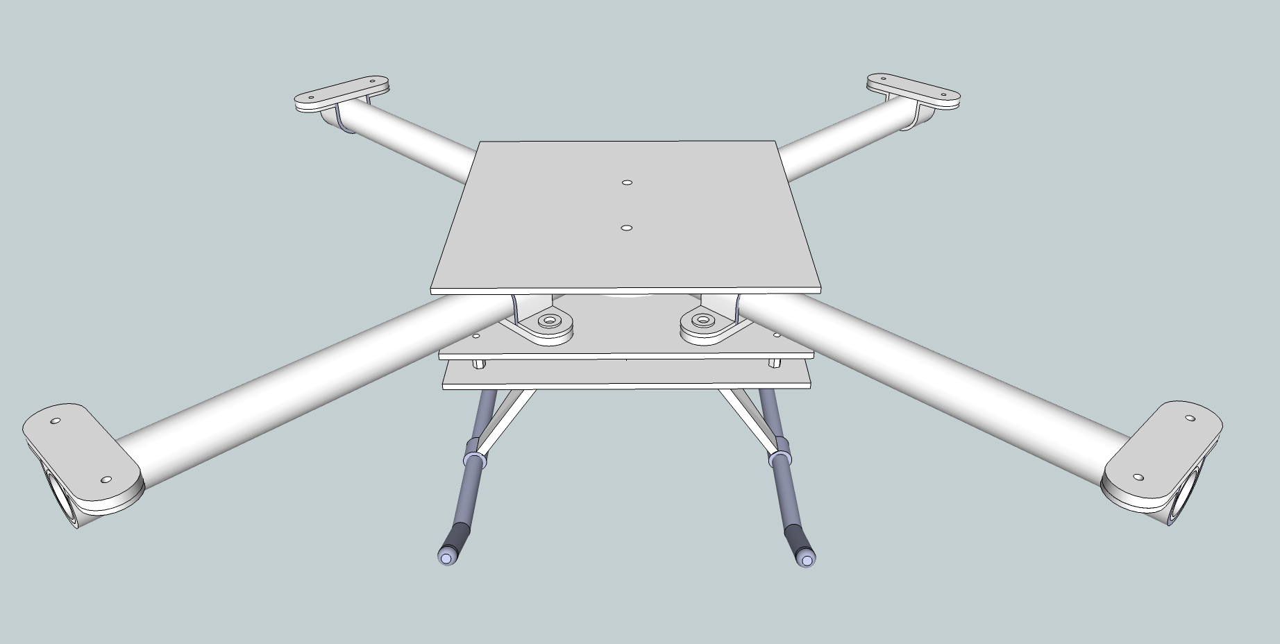
Photos/Diamond Quadcopter Model v2 4.png
