BRAVOTEAM135/Quadcopter/Photos/Diamond Quadcopter Model v2 iso.png

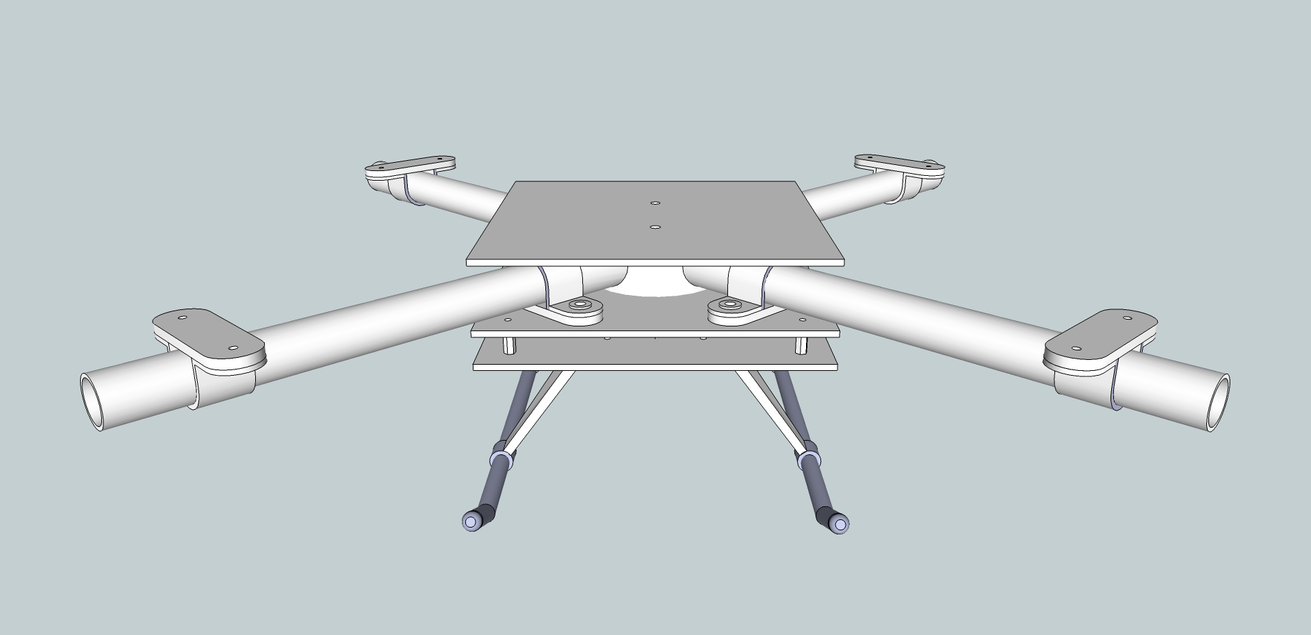
Photos/Diamond Quadcopter Model v2 iso.png
