BRAVOTEAM135/Quadcopter/Photos/Diamond Quadcopter Model v2 pen.jpg

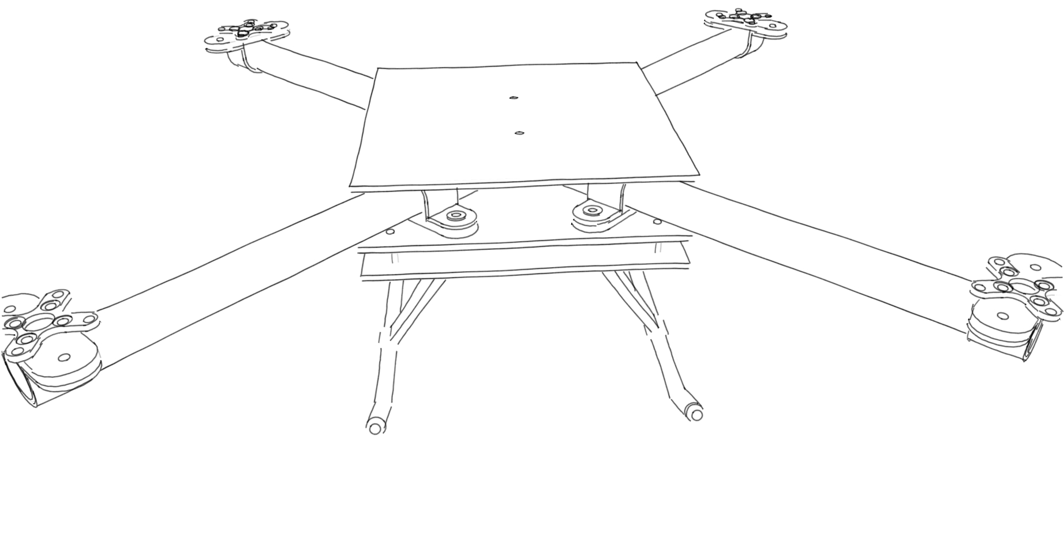
Photos/Diamond Quadcopter Model v2 pen.jpg
