BRAVOTEAM135/Quadcopter/Photos/Diamond Quadcopter Model v3 001.png

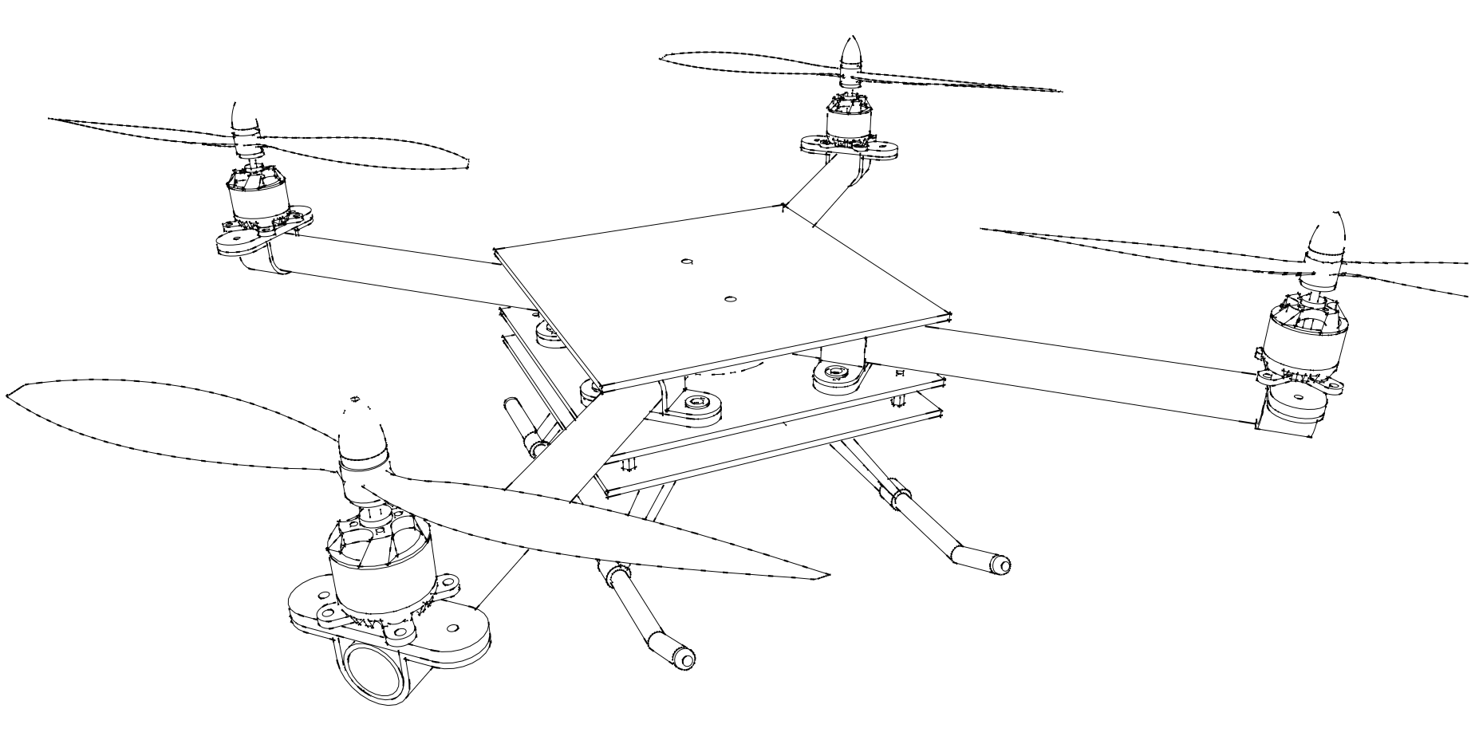
Photos/Diamond Quadcopter Model v3 001.png
