BRAVOTEAM135/Quadcopter/Photos/Diamond Quadcopter Model v3 011.png

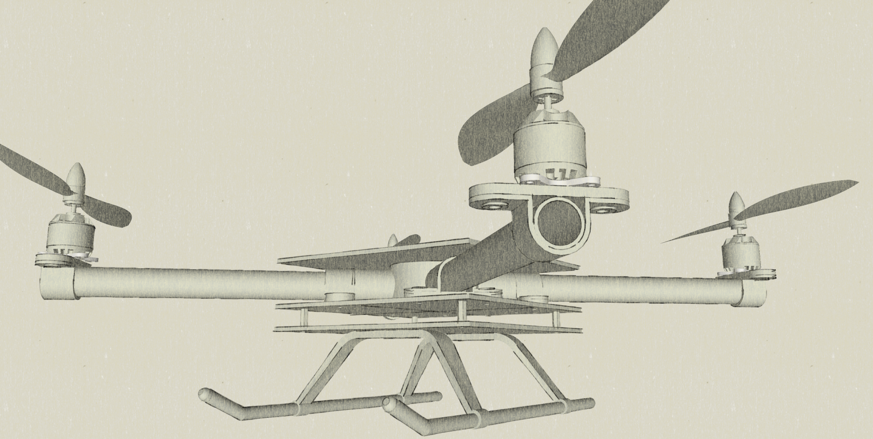
Photos/Diamond Quadcopter Model v3 011.png
