BRAVOTEAM135/Quadcopter/Photos/Diamond Quadcopter Model v3 012.png

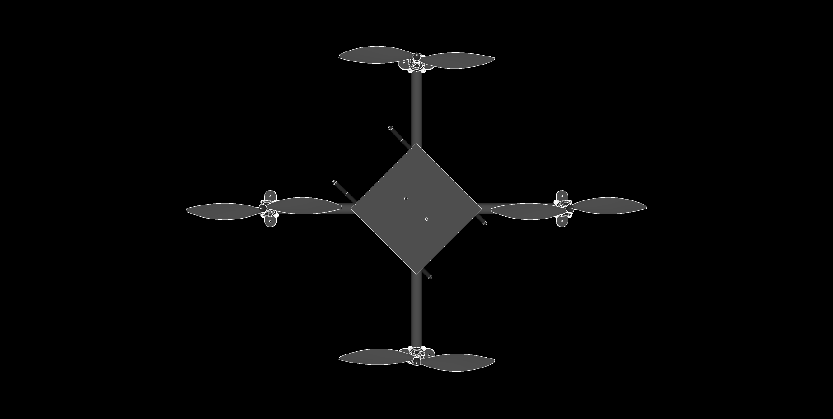
Photos/Diamond Quadcopter Model v3 012.png
