BRAVOTEAM135/Quadcopter/Photos/Diamond Quadcopter Model v3 015.png

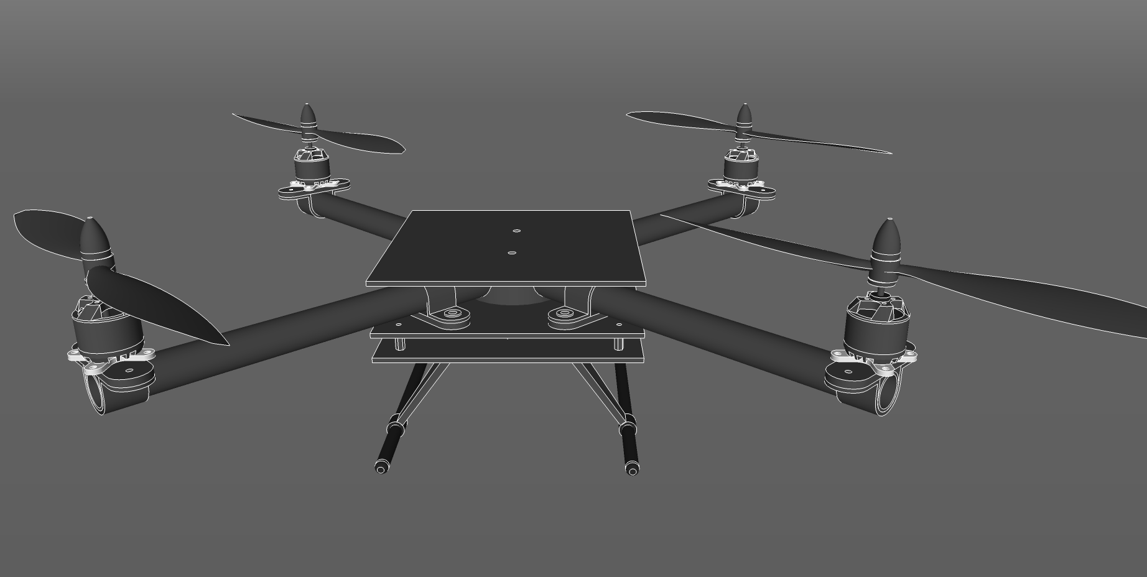
Photos/Diamond Quadcopter Model v3 015.png
