BRAVOTEAM135/Quadcopter/Photos/Diamond Quadcopter Model v3 016.png

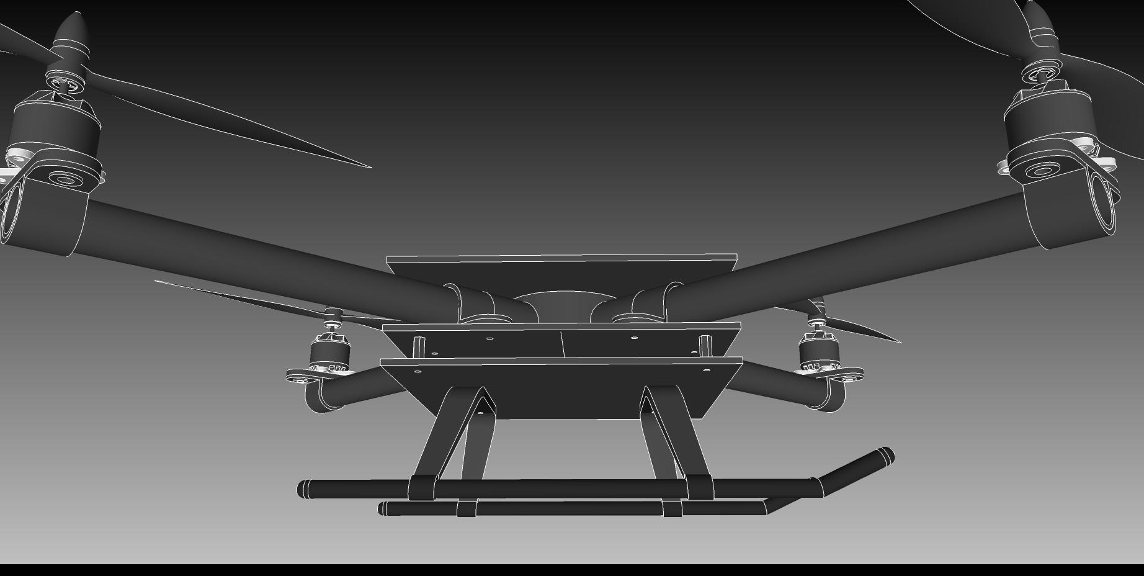
Photos/Diamond Quadcopter Model v3 016.png
