BRAVOTEAM135/Quadcopter/Photos/Diamond Quadcopter Model v3 017.png

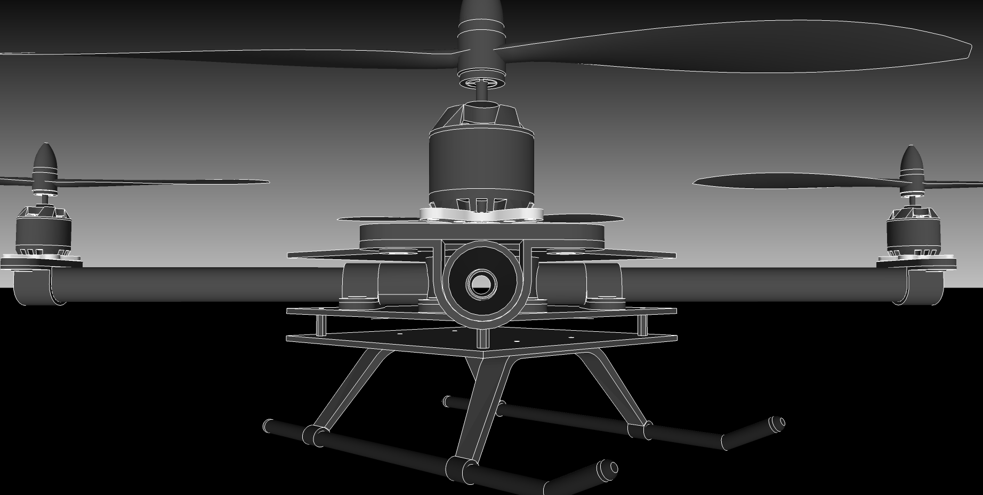
Photos/Diamond Quadcopter Model v3 017.png
