BRAVOTEAM135/Quadcopter/Photos/Diamond Quadcopter Model v3 018.png

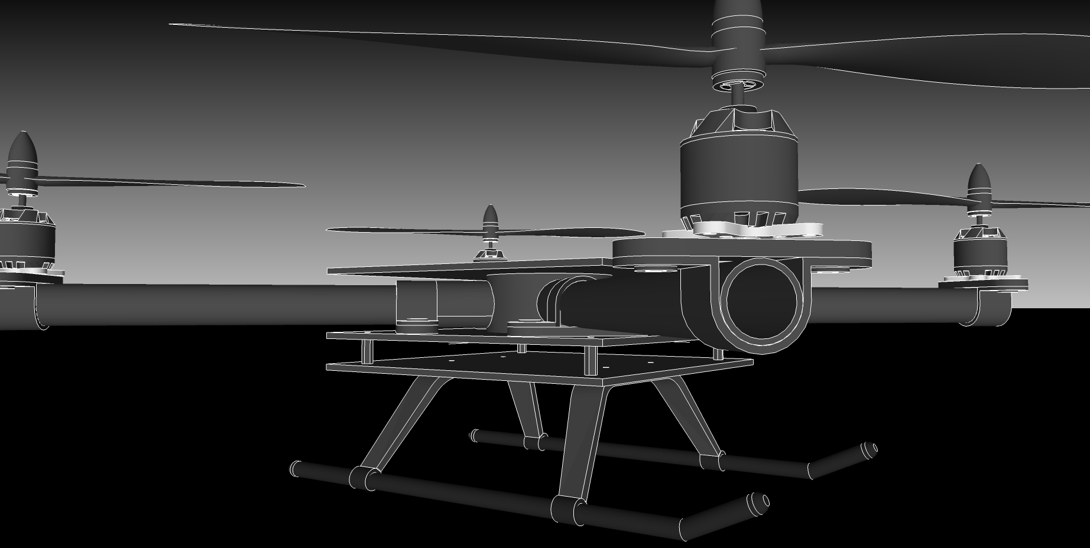
Photos/Diamond Quadcopter Model v3 018.png
