BRAVOTEAM135/Quadcopter/Photos/Diamond Quadcopter Model v3 019.png

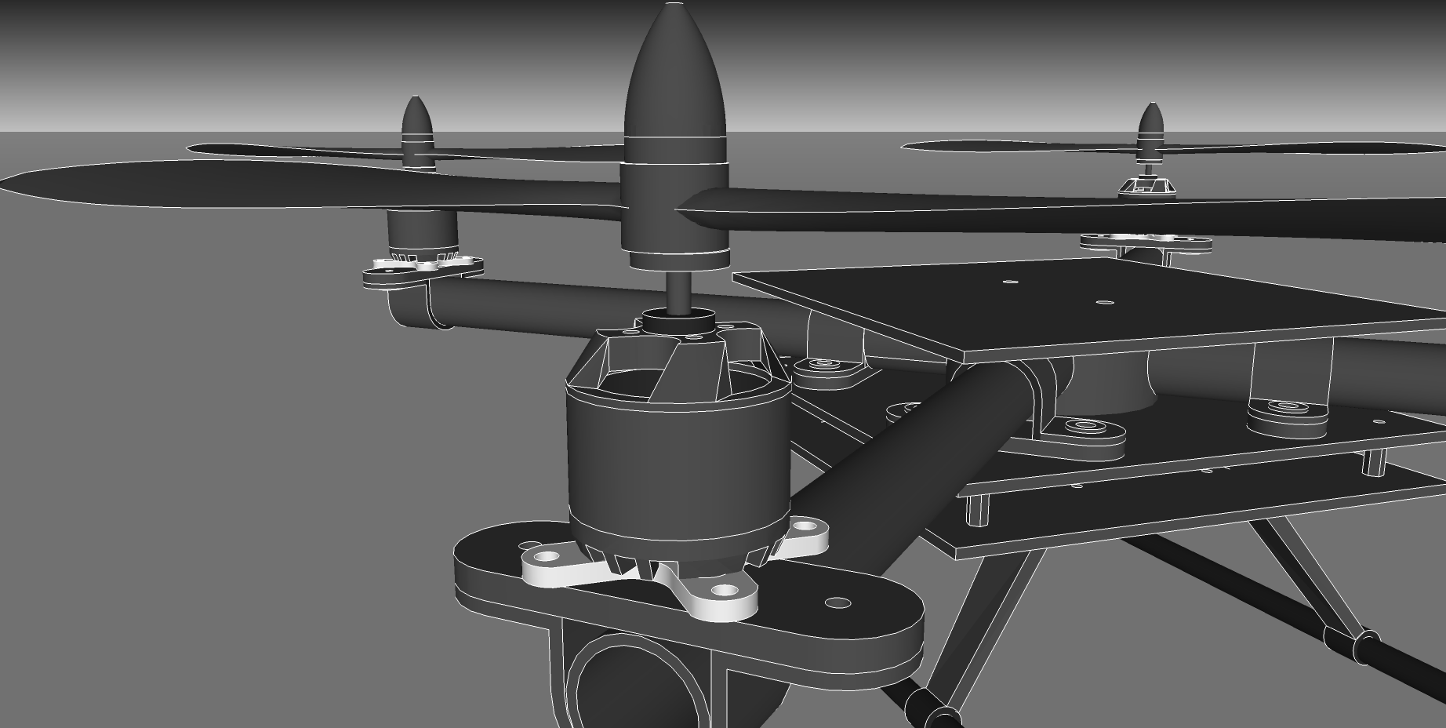
Photos/Diamond Quadcopter Model v3 019.png
