BRAVOTEAM135/Quadcopter/Photos/Diamond Quadcopter Model v3  013.png

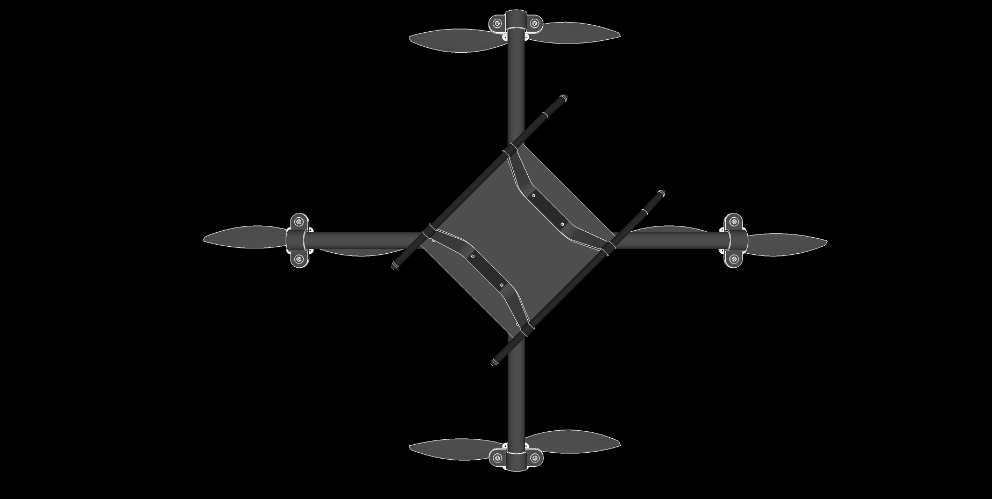
Photos/Diamond Quadcopter Model v3 013.png
