BRAVOTEAM135/Quadcopter/Photos/Diamond Quadcopter Model v3 hand draw.png

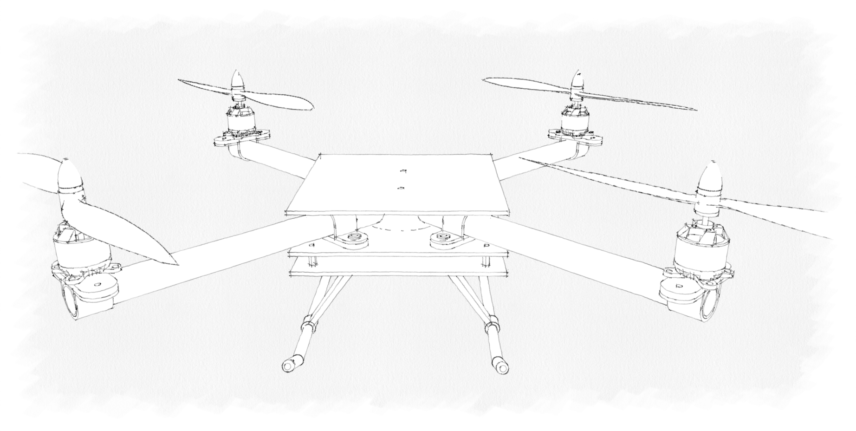
Photos/Diamond Quadcopter Model v3 hand draw.png
