BRAVOTEAM135/Quadcopter/Photos/Diamond Quadcopter Model view 3.png

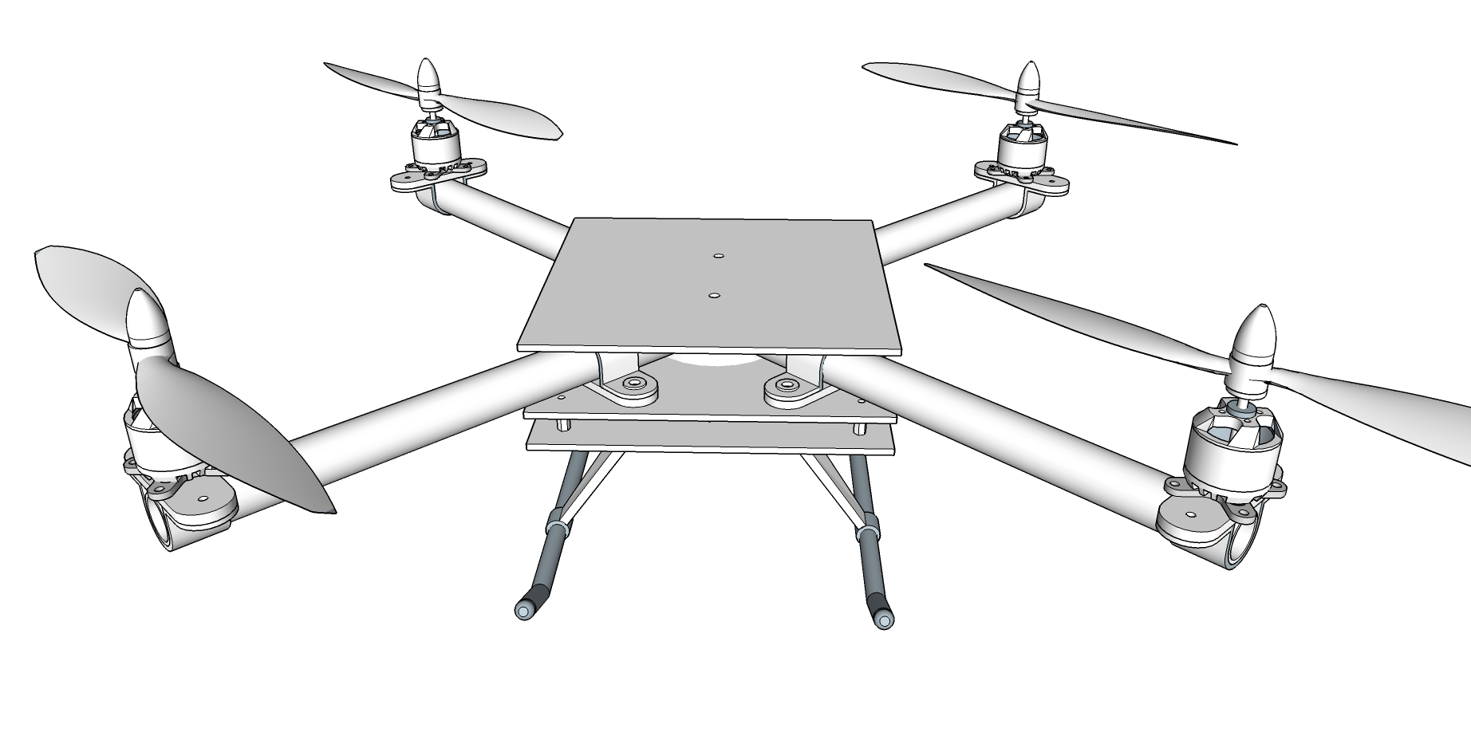
Photos/Diamond Quadcopter Model view 3.png
