BRAVOTEAM135/Quadcopter/Photos/Diamond Quadcopter Model view 4.png

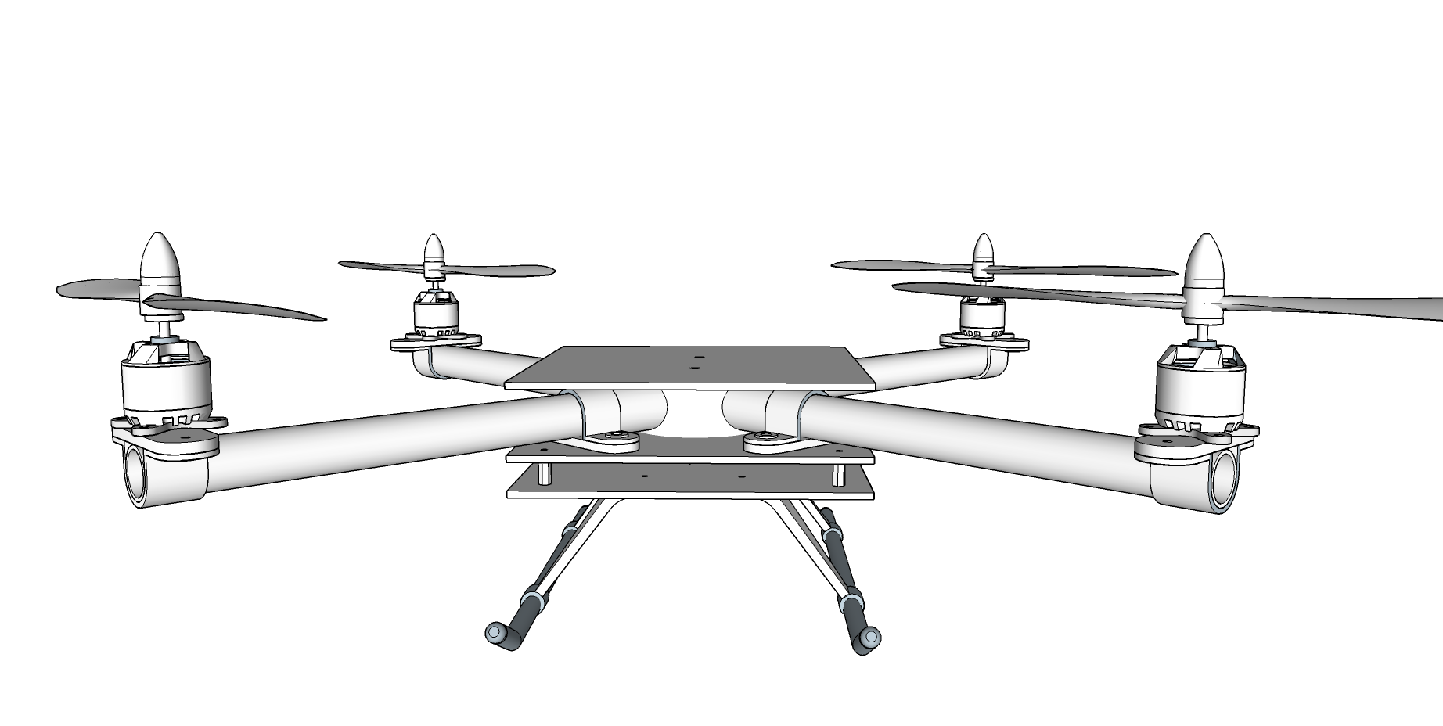
Photos/Diamond Quadcopter Model view 4.png
