BRAVOTEAM135/Quadcopter/Photos/Diamond Quadcopter Model view 5.png

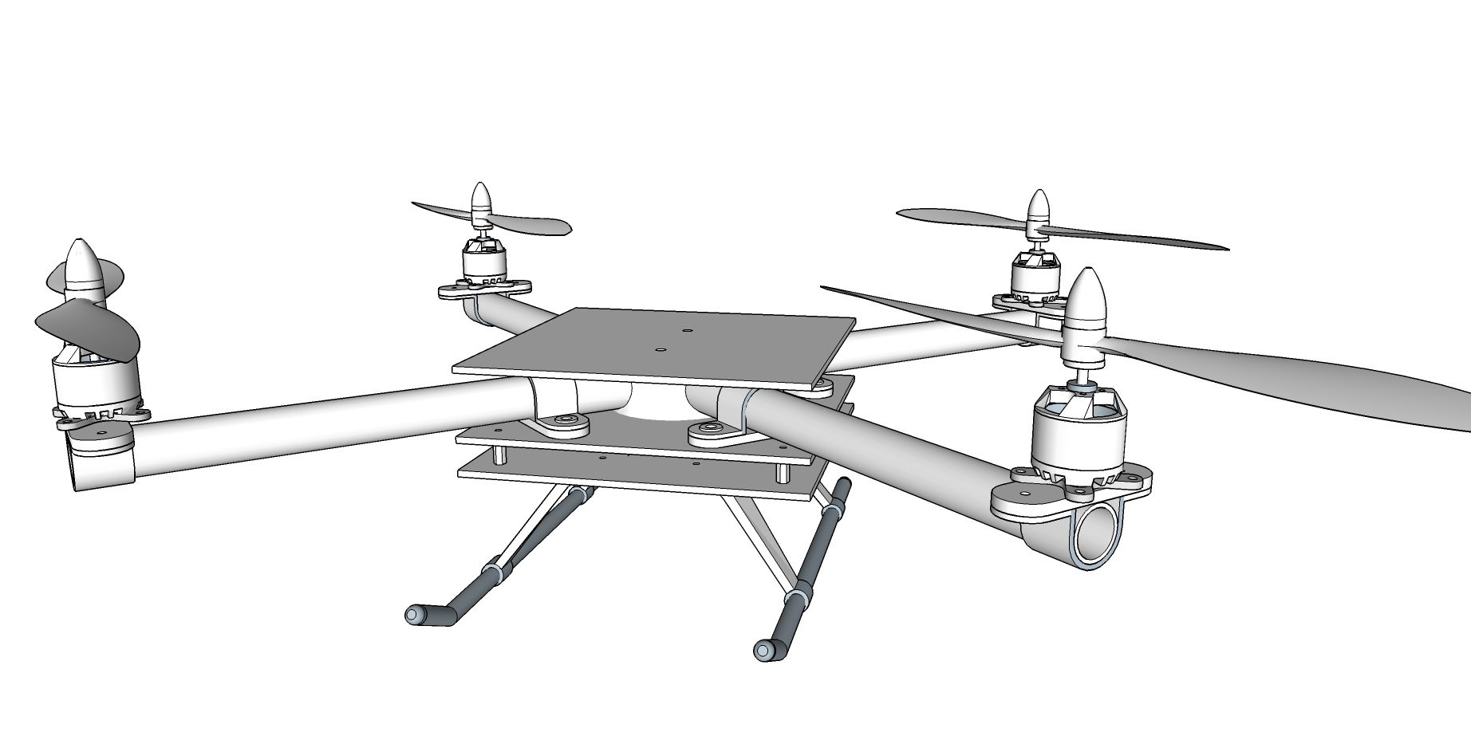
Photos/Diamond Quadcopter Model view 5.png
