BRAVOTEAM135/Quadcopter/Photos/Diamond.PNG

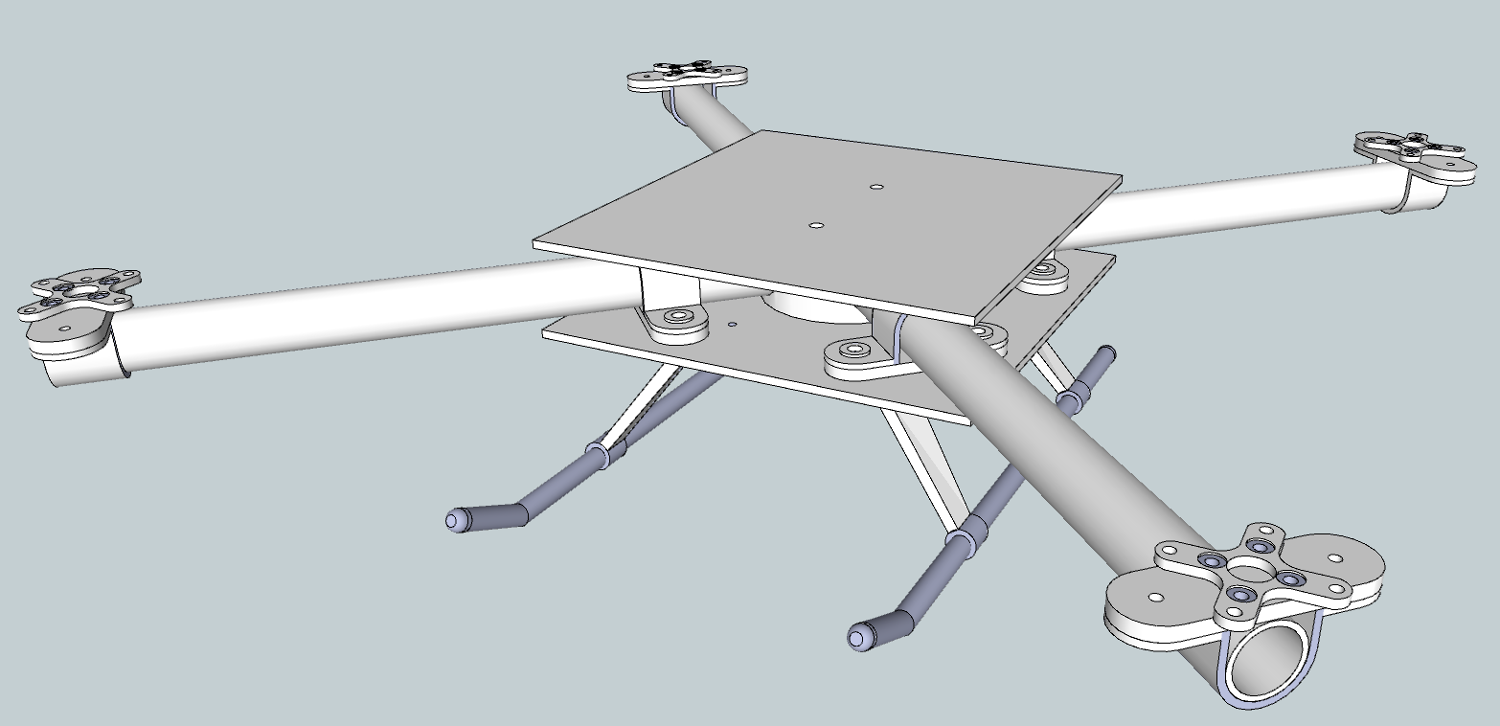
Photos/Diamond.PNG
