BRAVOTEAM135/Quadcopter/Photos/Gyro Rate Graphs/Gryro Graph 1.PNG

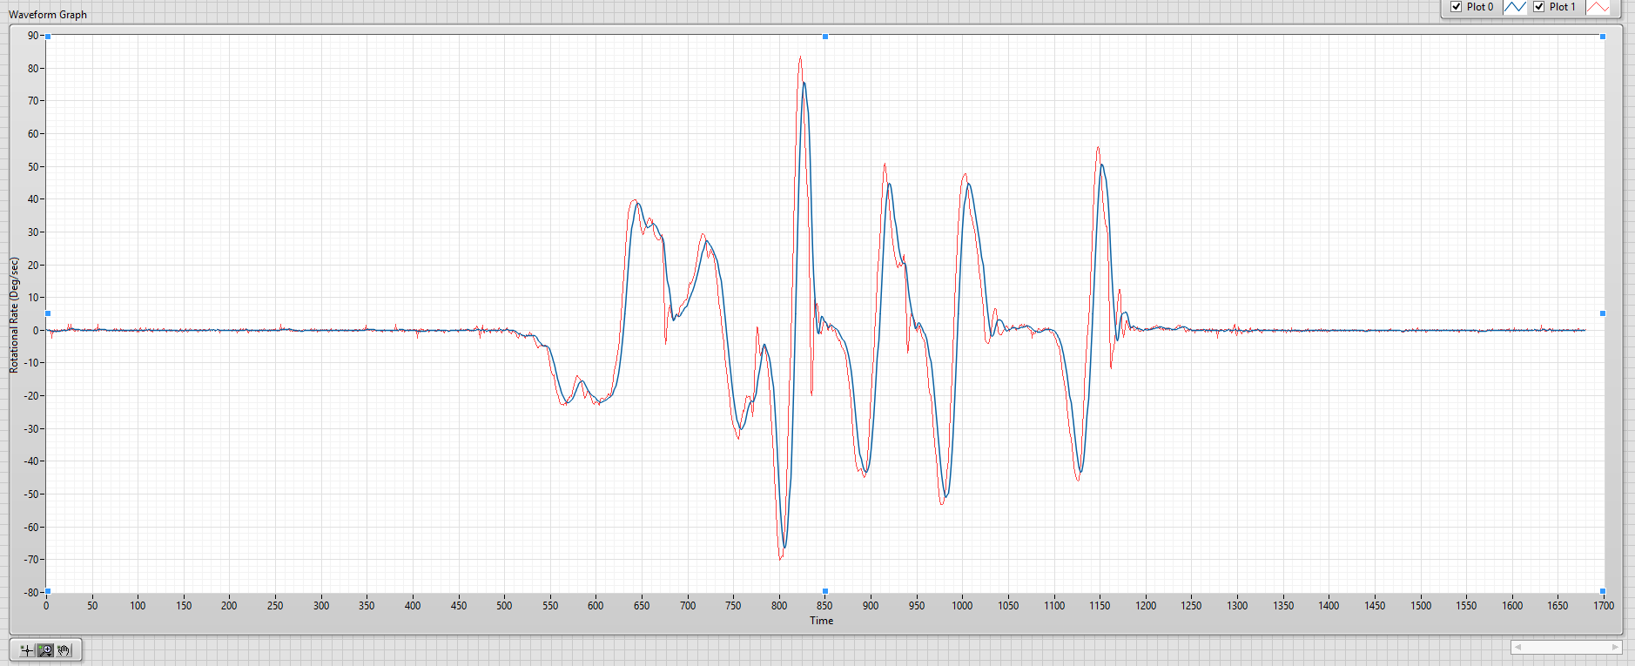
Photos/Gyro Rate Graphs/Gryro Graph 1.PNG
