BRAVOTEAM135/Quadcopter/Photos/Gyro Rate Graphs/Gryro Graph 3.PNG

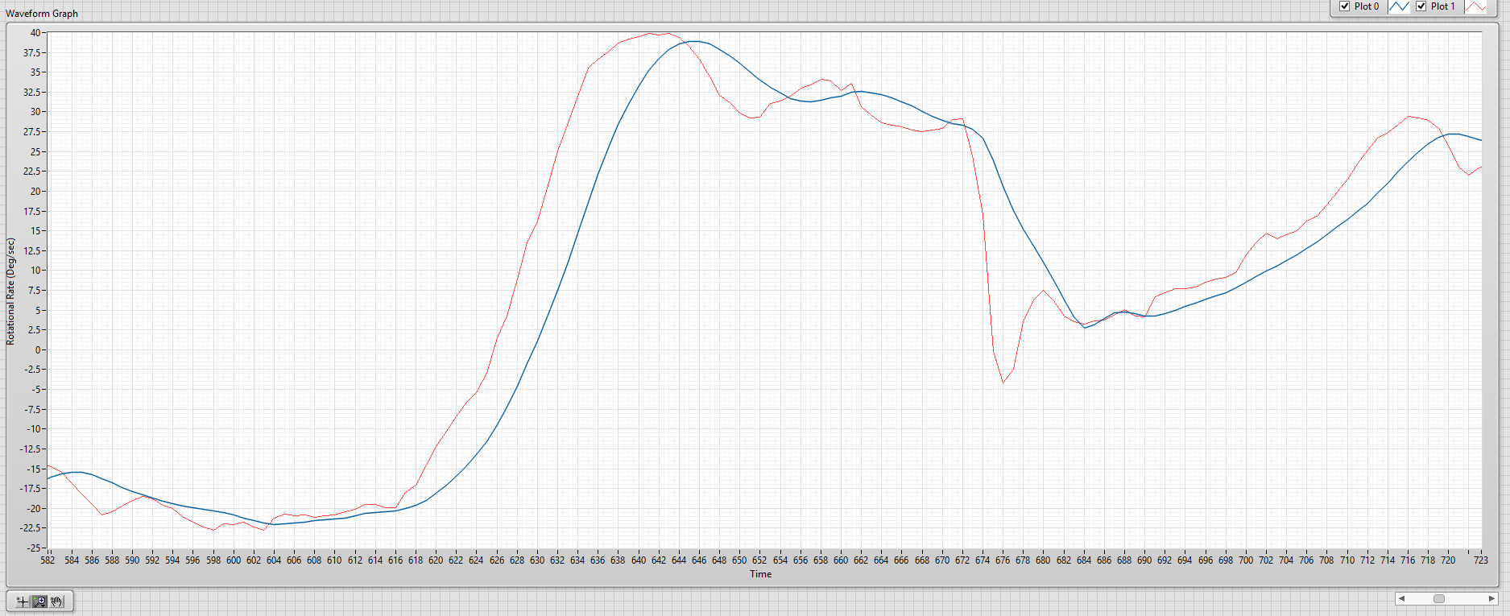
Photos/Gyro Rate Graphs/Gryro Graph 3.PNG
