BRAVOTEAM135/Quadcopter/Photos/Rig Design3.png

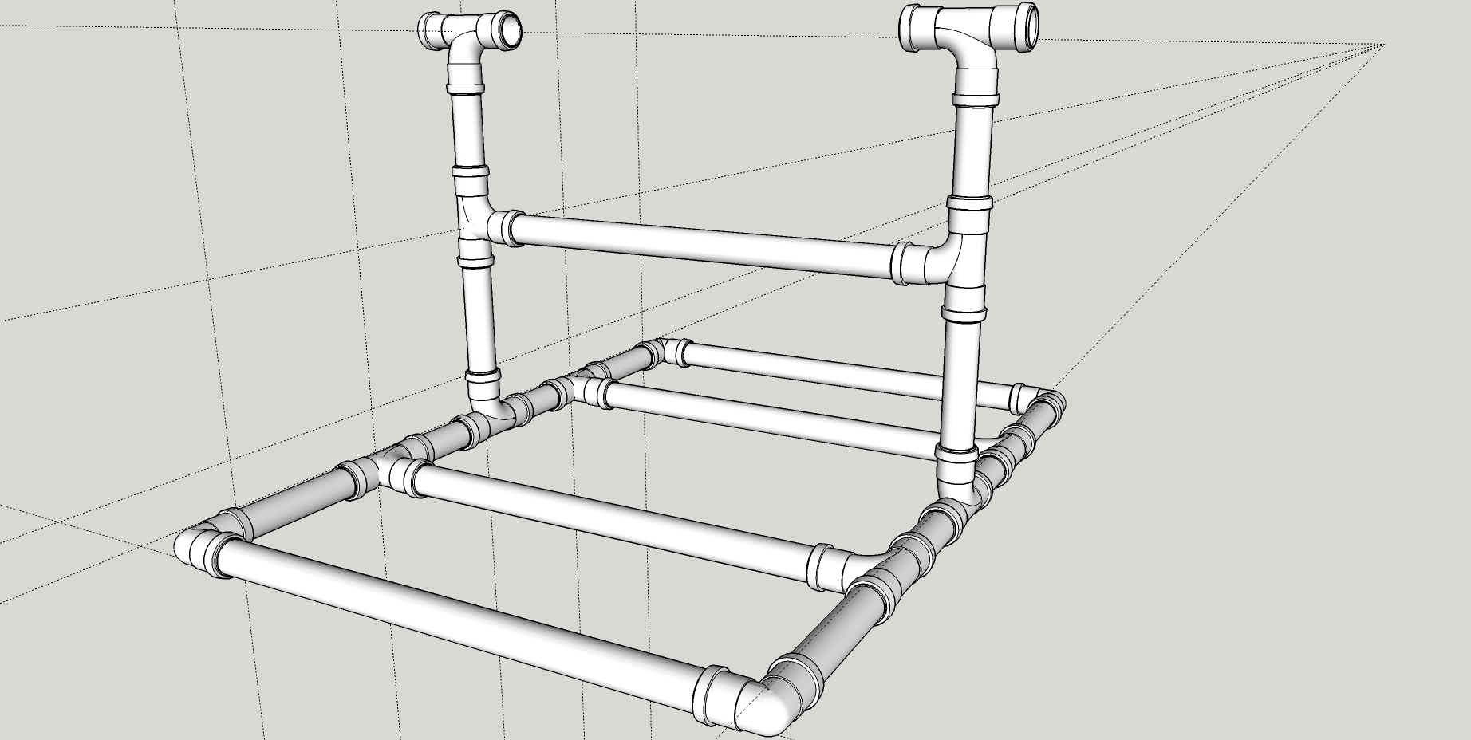
Photos/Rig Design3.png
