BRAVOTEAM135/Quadcopter/Photos/Rig Design with dimenstion.png

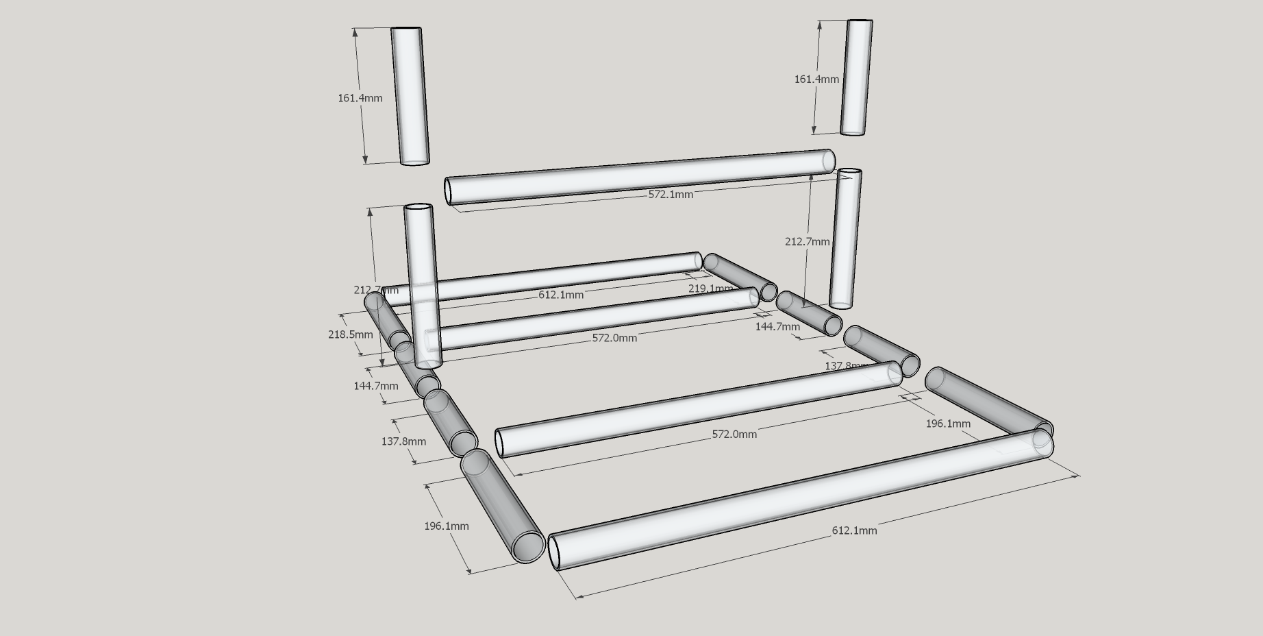
Photos/Rig Design with dimenstion.png
