BRAVOTEAM135/Quadcopter/Photos/Rig With Quad.png

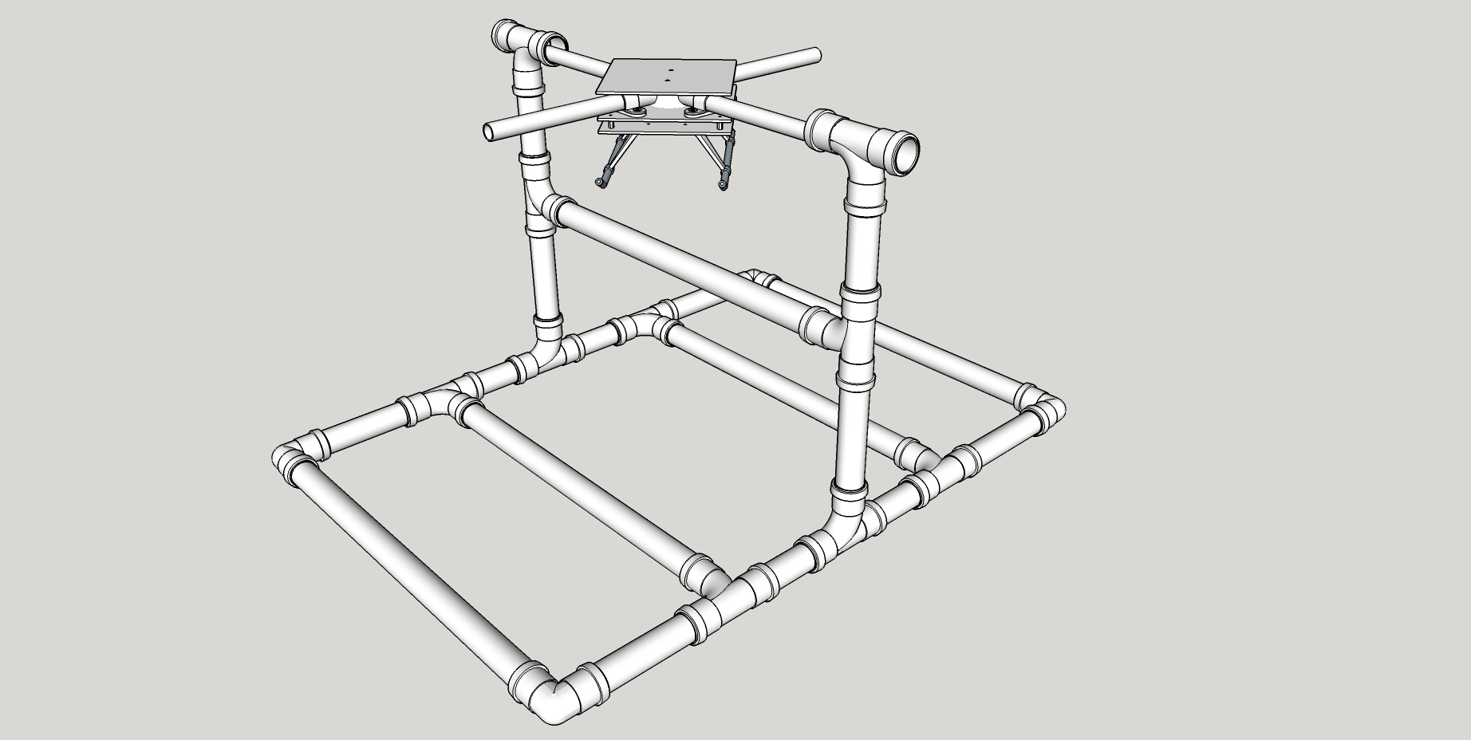
Photos/Rig With Quad.png
