BRAVOTEAM135/Quadcopter/Documentation/Quadcopter Motor Calculator.xlsx

Notes:;
Prop adapter - best are bolton
Name | Cost | Weight (g) | Rpm/V | Power (W) | Current (A) | Prop
Turnigy Aero Drive D2830-11 1000kv | 7.2 | 52 | 1000 | 210 | 21 | 8x4, 10x7
NTM Prop Drive Series 2826 1000kv | 10 | 54 | 1000 | 176 | 15 | 9x4.7 - 11.1v - 113w - 10.2A - 0.632kg
NTM Prop Drive Series 2826 1100kv | 10.7 | 57 | 1100 | 189 | 20 | 8x4 - 11.1V / 100W / 9.1A/ 0.54kg thrust --- 9x6 - 11.1V / 149W / 13.6A / 0.73kg thrust
NTM Prop Drive Series 2826 1350kv | 11.19 | 56 | 1350 | 227 | 18 | 8x3.8 - 11.1V / 158W / 14.2A / 0.736kg thrust
NTM Prop Drive Series 28-30A 1000kv | 11.45 | 68 | 1000 | 278 | 25
Turnigy Park450 Brushless Outrunner 1200kv | 12.29 | 66 | 1200 | 175 | 18 | 11.1v - 8x4.3 Prop - 13.2A -800g Thrust
Turnigy Park450 Brushless Outrunner 1050k | 13.28 | 66 | 1050 | 175 | 18 | 11.1v - 9x5 Prop - 12.3A - 800g Thrust 11.1v - 8x4.3 Prop - 9.8A - 640g Thrus
Turnigy Park450 Brushless Outrunner 890kv | 12.78 | 67 | 890 | 150 | 14 | 11.1v - 10x4.7 14A - 822g thrust.
Turnigy Park480 Brushless Outrunner 1320kv | 15.04 | 80 | 1320 | 275 | 28 | 8x4.3 - 18.2A - 1000g Thrust 9x5 - 25.2A - 1310g Thrust
Turnigy Park480 Brushless Outrunner 850kv | 14.45 | 80 | 850 | 275 | 28 | 9x5 - 8.6A - 650g Thrust 10x4.7 - 11.5A - 860g Thrust 11x4.7 - 19.5A - 1140g Thrust
