BRAVOTEAM135/Quadcopter/Original Project/Documentation/Quadcopter Battery Calculator.xlsx

Notes | Wire Guage | 10/12AWG |  |  | Key
Battery Charge | Cost |  |  |  |  | Want to get
IMAX B6AC V2 Professional Balance Charger/Discharger | £29.30 |  |  |  |  | Warning
IMAX B6 50W 5A Charger/Discharger 1-6 Cells (GENUINE) (UK Warehouse) | £20.57 |  |  |  |  | Do not get
Battery Name | Cost (£) | Connector | Wieght (g) | Charge Rate (C) | Voltage (V) | C Rating | mAh | Max Current Draw (mA) | Amps | Typical current Draw Load (mA) | Battery Life (mins)
Turnigy 2.2 (http://www.hobbyking.co.uk/hobbyking/store/__8932__Turnigy_2200mAh_3S_20C_Lipo_Pack.html) | £7.00 | XT60 | 248 | 2 | 11.1 | 20 | 2200 | 44000 | 44 | 30000 | 4.4
Turnigy Nano-Tech (http://www.hobbyking.com/hobbyking/store/uh_viewItem.asp?idProduct=11956) | £35.00 | 4mm Bullet | 425 | 10 | 11.1 | 45 | 5000 | 225000 | 225 | 30000 | 10
Turnigy Nano-Tech (http://www.hobbyking.com/hobbyking/store/uh_viewItem.asp?idProduct=11939) | £35.00 | 4mm Bullet | 481 | 5 | 11.1 | 25 | 6000 | 150000 | 150 | 30000 | 12
Turnigy Heavy Duty (http://www.hobbyking.com/hobbyking/store/uh_viewItem.asp?idProduct=53689) | £20.00 | HXT 4mm | 371 | 2 | 11.1 | 60 | 4000 | 240000 | 240 | 30000 | 8
Turnigy (http://www.hobbyking.com/hobbyking/store/uh_viewItem.asp?idProduct=10286) | £20.00 | 5.5mm Bullet | 482 | 2 | 11.1 | 25 | 5800 | 145000 | 145 | 30000 | 11.6
Turnigy Nano-Tech (http://www.hobbyking.com/hobbyking/store/uh_viewItem.asp?idProduct=11927) | £18.00 | 4mm Bullet | 333 | 5 | 11.1 | 25 | 4000 | 100000 | 100 | 30000 | 8 | (mAh/Load) x 60 = Battery life
Turnigy Nano-Tech (http://www.hobbyking.com/hobbyking/store/uh_viewItem.asp?idProduct=17247) | £25.00 | 4mm Bullet | 372 | 8 | 11.1 | 35 | 4500 | 157500 | 157.5 | 30000 | 9
Turnigy Nano-Tech (http://www.hobbyking.com/hobbyking/store/uh_viewItem.asp?idProduct=11935) | £25.00 | 4mm Bullet | 403 | 5 | 11.1 | 25 | 5000 | 125000 | 125 | 30000 | 10
Turnigy Nano-Tech (http://www.hobbyking.com/hobbyking/store/uh_viewItem.asp?idProduct=11931) | £25.00 | 4mm Bullet | 347 | 5 | 11.1 | 25 | 4500 | 112500 | 112.5 | 30000 | 9
Multistar (http://www.hobbyking.com/hobbyking/store/uh_viewItem.asp?idProduct=62885) | £20.00 | Walkera | 325 | 5 | 11.1 | 10 | 5200 | 52000 | 52 | 30000 | 10.4
Multistar (http://www.hobbyking.com/hobbyking/store/uh_viewItem.asp?idProduct=56839) | £11.00 | XT60 | 331 | 2 | 11.1 | 10 | 5200 | 52000 | 52 | 30000 | 10.4
Zippy Compact (http://www.hobbyking.com/hobbyking/store/uh_viewItem.asp?idProduct=21370) | £20.00 | 5.5mm Bullet | 354 | 5 | 11.1 | 25 | 5000 | 125000 | 125 | 30000 | 10 | Red because never herd of this brand
Turnigy (http://www.hobbyking.com/hobbyking/store/uh_viewitem.asp?idproduct=10283) | £21.00 | 4mm Bullet | 386 | 2 | 11.1 | 30 | 4500 | 135000 | 135 | 30000 | 9
B-Grade (http://www.hobbyking.com/hobbyking/store/uh_viewItem.asp?idProduct=15512) | £7.00 | 4mm | 408 | 2 | 11.1 | 20 | 5000 | 100000 | 100 | 1 | 300000
Turnigy (http://www.hobbyking.com/hobbyking/store/uh_viewItem.asp?idProduct=9184) | £17.00 | 4mm | 497 | 2 | 11.1 | 20 | 5000 | 100000 | 100 | 1 | 300000
Multistar (http://www.hobbyking.co.uk/hobbyking/store/uh_viewitem.asp?idproduct=77791) | 10.61 | XT90 | 364 | 1 | 14.8 | 2 | 6000 | 12000 | 12
Turnigy Nano Tech | 42.61 | 4mm Bullet | 623 | 5 | 14.8 | 25 | 6000 | 150000 | 150 |  | #DIV/0!
 |  |  |  |  |  |  |  | 0 | 0 |  | #DIV/0!
 |  |  |  |  |  |  |  | 0 | 0 |  | #DIV/0!
 |  |  |  |  |  |  |  | 0 | 0 |  | #DIV/0!
 |  |  |  |  |  |  |  | 0 | 0 |  | #DIV/0!
 |  |  |  |  |  |  |  | 0 | 0 |  | #DIV/0!
 |  |  |  |  |  |  |  | 0 | 0 |  | #DIV/0!
 |  |  |  |  |  |  |  | 0 | 0 |  | #DIV/0!
 |  |  |  |  |  |  |  | 0 | 0 |  | #DIV/0!
 |  |  |  |  |  |  |  | 0 | 0 |  | #DIV/0!
 |  |  |  |  |  |  |  | 0 | 0 |  | #DIV/0!
 |  |  |  |  |  |  |  | 0 | 0 |  | #DIV/0!
 |  |  |  |  |  |  |  | 0 | 0 |  | #DIV/0!
 |  |  |  |  |  |  |  | 0 | 0 |  | #DIV/0!
 |  |  |  |  |  |  |  | 0 | 0 |  | #DIV/0!
 |  |  |  |  |  |  |  | 0 | 0 |  | #DIV/0!
 |  |  |  |  |  |  |  | 0 | 0 |  | #DIV/0!
 |  |  |  |  |  |  |  | 0 | 0 |  | #DIV/0!
 |  |  |  |  |  |  |  | 0 | 0 |  | #DIV/0!
 |  |  |  |  |  |  |  | 0 | 0 |  | #DIV/0!
 |  |  |  |  |  |  |  | 0 | 0 |  | #DIV/0!
