BRAVOTEAM135/Quadcopter/Documentation/Suppliers.txt

http://www.hobbytronics.co.uk/index.php?route=common/home

http://www.hobbyking.co.uk/hobbyking/store/index.asp
