BRAVOTEAM135/Quadcopter/Documentation/Circuit Design/Old/Quadcopter Schematic Rev 001_bom.html

Label | Part Type | Properties
ALIE | Generic male header - 3 pins | pin spacing 0.1in (2.54mm); hole size 1.0mm,0.508mm; pins 3; form ♂ (male); row single; package THT
Arduino Nano | Arduino Nano (Rev3.0) | type Arduino Nano (3.0)
AUX | Generic male header - 3 pins | pin spacing 0.1in (2.54mm); hole size 1.0mm,0.508mm; pins 3; form ♂ (male); row single; package THT
Digital IO | Screw terminal - 5 pins | pin spacing 0.1in (2.54mm); hole size 1.0mm,0.508mm; pins 5; package THT
ELEV | Generic male header - 3 pins | pin spacing 0.1in (2.54mm); hole size 1.0mm,0.508mm; pins 3; form ♂ (male); row single; package THT
IMU | Screw terminal - 4 pins | pin spacing 0.1in (2.54mm); hole size 1.0mm,0.508mm; pins 4; package THT
M1 | Generic male header - 3 pins | pin spacing 0.1in (2.54mm); hole size 1.0mm,0.508mm; pins 3; form ♂ (male); row single; package THT
M2 | Generic male header - 3 pins | pin spacing 0.1in (2.54mm); hole size 1.0mm,0.508mm; pins 3; form ♂ (male); row single; package THT
M3 | Generic male header - 3 pins | pin spacing 0.1in (2.54mm); hole size 1.0mm,0.508mm; pins 3; form ♂ (male); row single; package THT
M4 | Generic male header - 3 pins | pin spacing 0.1in (2.54mm); hole size 1.0mm,0.508mm; pins 3; form ♂ (male); row single; package THT
Part1 | Schematic Frame | sheet 1/1; filename Quadcopter Schematic; project Quadcopter; date 1448453128; rev 001
RUDD | Generic male header - 3 pins | pin spacing 0.1in (2.54mm); hole size 1.0mm,0.508mm; pins 3; form ♂ (male); row single; package THT
THRO | Generic male header - 3 pins | pin spacing 0.1in (2.54mm); hole size 1.0mm,0.508mm; pins 3; form ♂ (male); row single; package THT
Amount | Part Type | Properties
9 | Generic male header - 3 pins | pin spacing 0.1in (2.54mm); hole size 1.0mm,0.508mm; pins 3; form ♂ (male); row single; package THT
1 | Arduino Nano (Rev3.0) | type Arduino Nano (3.0)
1 | Screw terminal - 5 pins | pin spacing 0.1in (2.54mm); hole size 1.0mm,0.508mm; pins 5; package THT
1 | Screw terminal - 4 pins | pin spacing 0.1in (2.54mm); hole size 1.0mm,0.508mm; pins 4; package THT
1 | Schematic Frame | sheet 1/1; filename Quadcopter Schematic; project Quadcopter; date 1448453128; rev 001
