BRAVOTEAM135/Quadcopter/(list of files, cad)

Other CAD files:
Documentation/Quadcopter 3D Model/Components/32mm Pipe 10mm .skp
Documentation/Quadcopter 3D Model/Components/32mm Pipe 580mm .skp
Documentation/Quadcopter 3D Model/Components/90deg 32mm bend.skp
Documentation/Quadcopter 3D Model/Components/Arm Mount Pt 1.skp
Documentation/Quadcopter 3D Model/Components/Arm Mount Pt 2.skp
Documentation/Quadcopter 3D Model/Components/Arm.skp
Documentation/Quadcopter 3D Model/Components/Bottom Plate.skp
Documentation/Quadcopter 3D Model/Components/Centre Piece.skp
Documentation/Quadcopter 3D Model/Components/Diamond Bottom Plate V2.skp
Documentation/Quadcopter 3D Model/Components/Diamond Bottom Plate.skp
Documentation/Quadcopter 3D Model/Components/Diamond MiddlePlate V2.skp
Documentation/Quadcopter 3D Model/Components/Diamond Top plate.skp
Documentation/Quadcopter 3D Model/Components/Motor Base.skp
Documentation/Quadcopter 3D Model/Components/Motor Screw Top.skp
Documentation/Quadcopter 3D Model/Components/Prop 10x4.5.skp
Documentation/Quadcopter 3D Model/Components/Prop Screw.skp
Documentation/Quadcopter 3D Model/Components/Skid Pole.skp
Documentation/Quadcopter 3D Model/Diamond Quadcopter Model v3.skp
Documentation/Quadcopter 3D Model/Motor Drafts/Motor2.skp
Documentation/Quadcopter 3D Model/Prop Drafts/Prop 10x4.5 ver21 3d before twist.skp
Documentation/Quadcopter 3D Model/Prop Drafts/Prop 10x4.5 ver21 topdown2.skp
Documentation/Quadcopter 3D Model/Prop Drafts/Prop 10x4.5 ver21 with skin.skp
Documentation/Quadcopter 3D Model/Prop Drafts/Prop 10x4.5.skp
Original Project/Documentation/Quadcopter 3D Model/Components/10x4.5 Prop CCW.skp
Original Project/Documentation/Quadcopter 3D Model/Components/10x4.5 Prop CW.skp
Original Project/Documentation/Quadcopter 3D Model/Components/32mm Pipe 140mm .skp
Original Project/Documentation/Quadcopter 3D Model/Components/32mm Pipe 160mm.skp
Original Project/Documentation/Quadcopter 3D Model/Components/32mm Pipe 200mm .skp
Original Project/Documentation/Quadcopter 3D Model/Components/32mm Pipe 540mm .skp
Original Project/Documentation/Quadcopter 3D Model/Components/Arduino Nano.skp
Original Project/Documentation/Quadcopter 3D Model/Components/Centre Piece Lid.skp
Original Project/Documentation/Quadcopter 3D Model/Components/Motor Screw Middle.skp
Original Project/Documentation/Quadcopter 3D Model/Components/Motor.skp
Original Project/Documentation/Quadcopter 3D Model/Components/Skid Arm2.skp
Original Project/Documentation/Quadcopter 3D Model/Components/Tee 32mm.skp
Original Project/Documentation/Quadcopter 3D Model/Components/Top Plate.skp
Original Project/Documentation/Quadcopter 3D Model/Diamond Quadcopter Model v2.skp
Original Project/Documentation/Quadcopter 3D Model/Diamond Quadcopter Model.skp
Original Project/Documentation/Quadcopter 3D Model/Prop Drafts/Prop 10x4.5 ver2.skp
Original Project/Documentation/Quadcopter 3D Model/Prop Drafts/Prop 10x4.5 ver21 before twist 2.skp
Original Project/Documentation/Quadcopter 3D Model/Prop Drafts/Prop 10x4.5 ver21 righ before rotation.skp
Original Project/Documentation/Quadcopter 3D Model/Prop Drafts/Prop 10x4.5 ver21 topdown.skp
Original Project/Documentation/Quadcopter 3D Model/Prop Drafts/Prop 10x4.5 ver3.skp
Original Project/Documentation/Quadcopter 3D Model/Quadcopter Model.skp
Original Project/Documentation/Quadcopter 3D Model/Rig Design.skp
Original Project/Documentation/Quadcopter 3D Model/Test Rig.skp
