BRAVOTEAM135/Quadcopter/Original Project/Software/Quadcopter Ver3.0/Timer_Test/Readme

This project is just to proove out the timer. This is not really used for anything else and has since been built into a libary
