BRAVOTEAM135/Quadcopter/Documentation/Quadcopter 3D Model/Test Rig.jpg

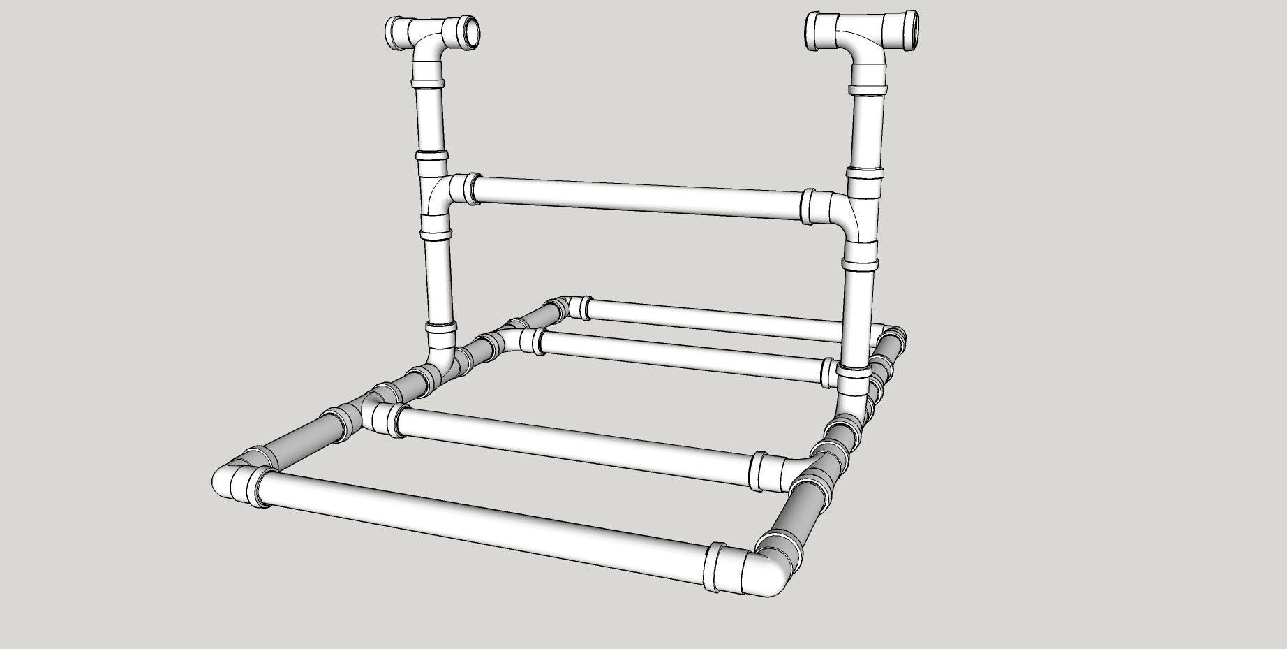
Documentation/Quadcopter 3D Model/Test Rig.jpg
