BRAVOTEAM135/Quadcopter/Original Project/Photos/Test Rig pencil.jpg

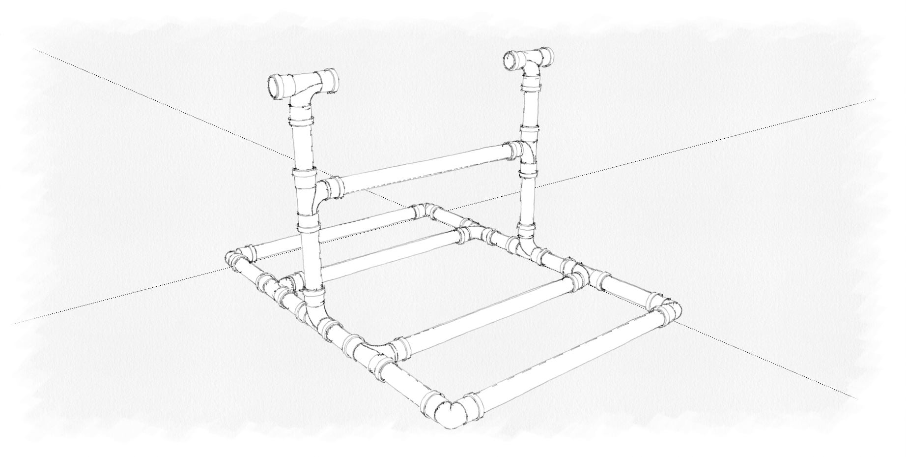
Original Project/Photos/Test Rig pencil.jpg
