BRAVOTEAM135/Quadcopter/Original Project/Photos/Test Rig sketch.jpg

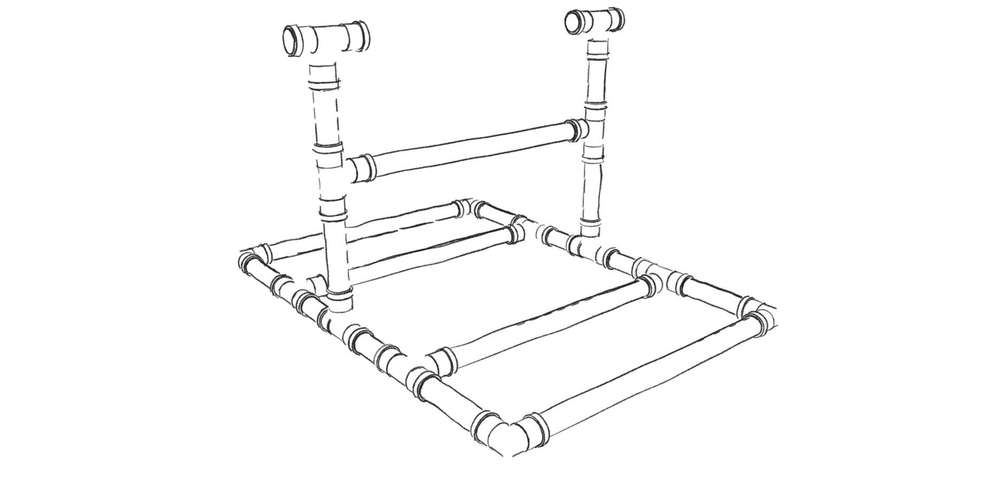
Original Project/Photos/Test Rig sketch.jpg
