BRAVOTEAM135/Quadcopter/Photos/Test Rig Dimensions.jpg

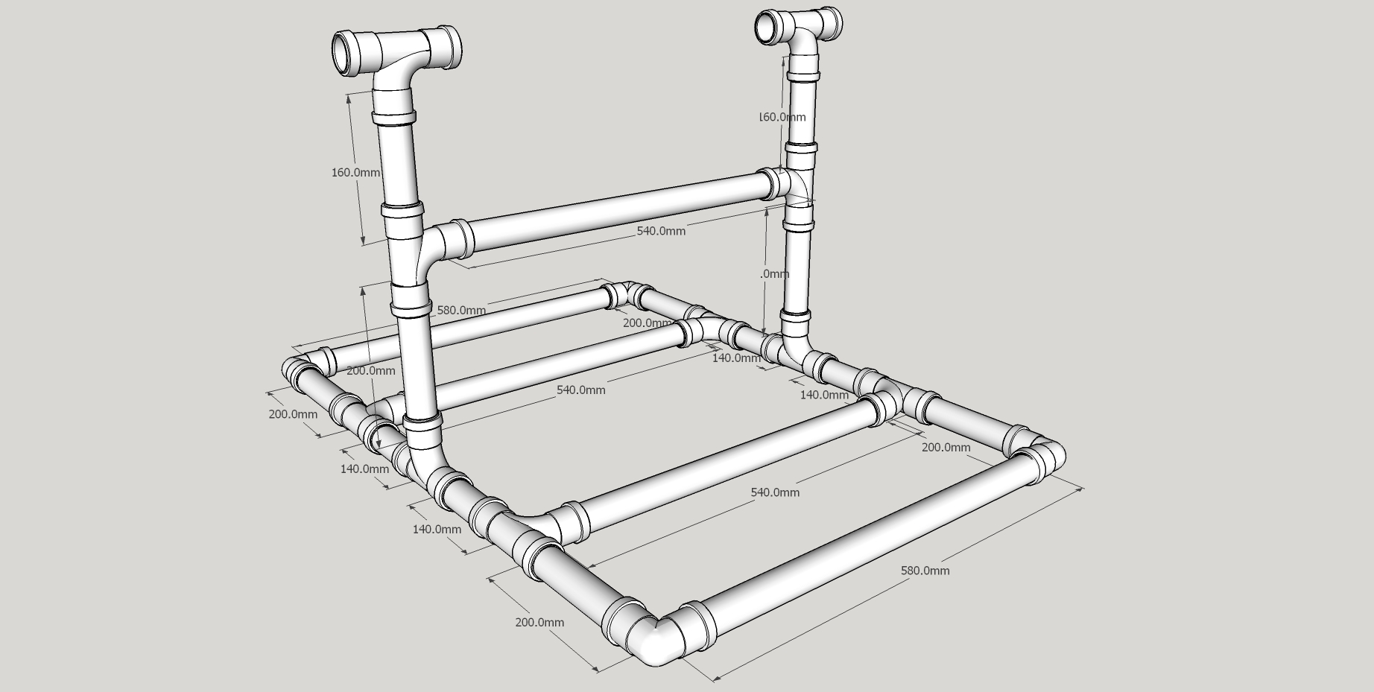
Photos/Test Rig Dimensions.jpg
