BRAVOTEAM135/Quadcopter/Documentation/Circuit Design/Quadcopter Schematic Rev 001_schem.pdf

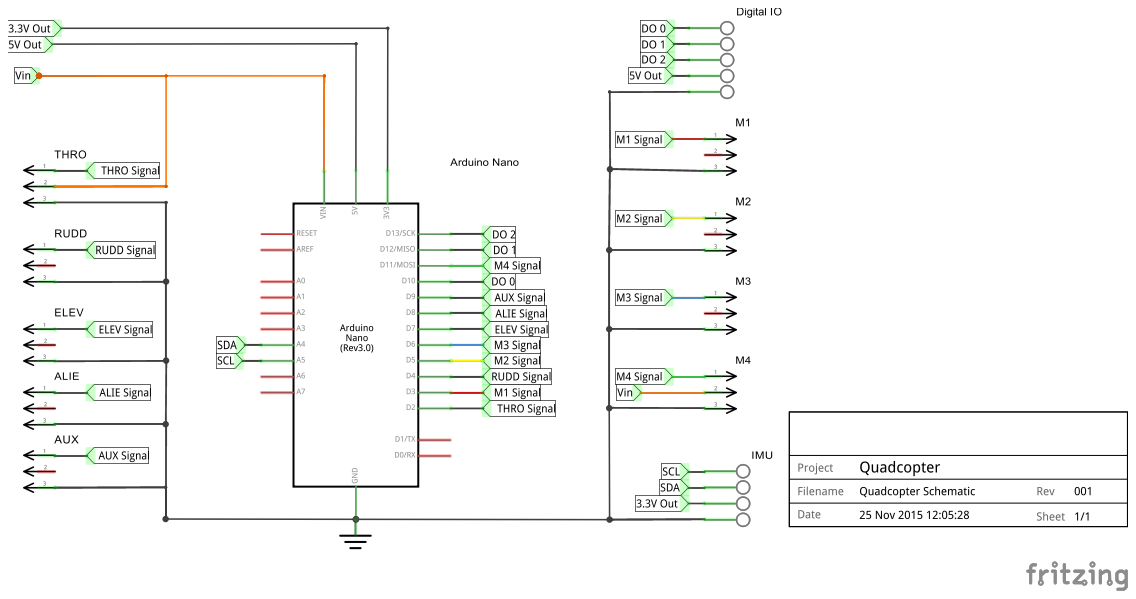
[picture p115: page 1]
