BRAVOTEAM135/Quadcopter/Documentation/Circuit Design/Quadcopter Design Ver3/Quadcopter Design Ver3_schem.pdf

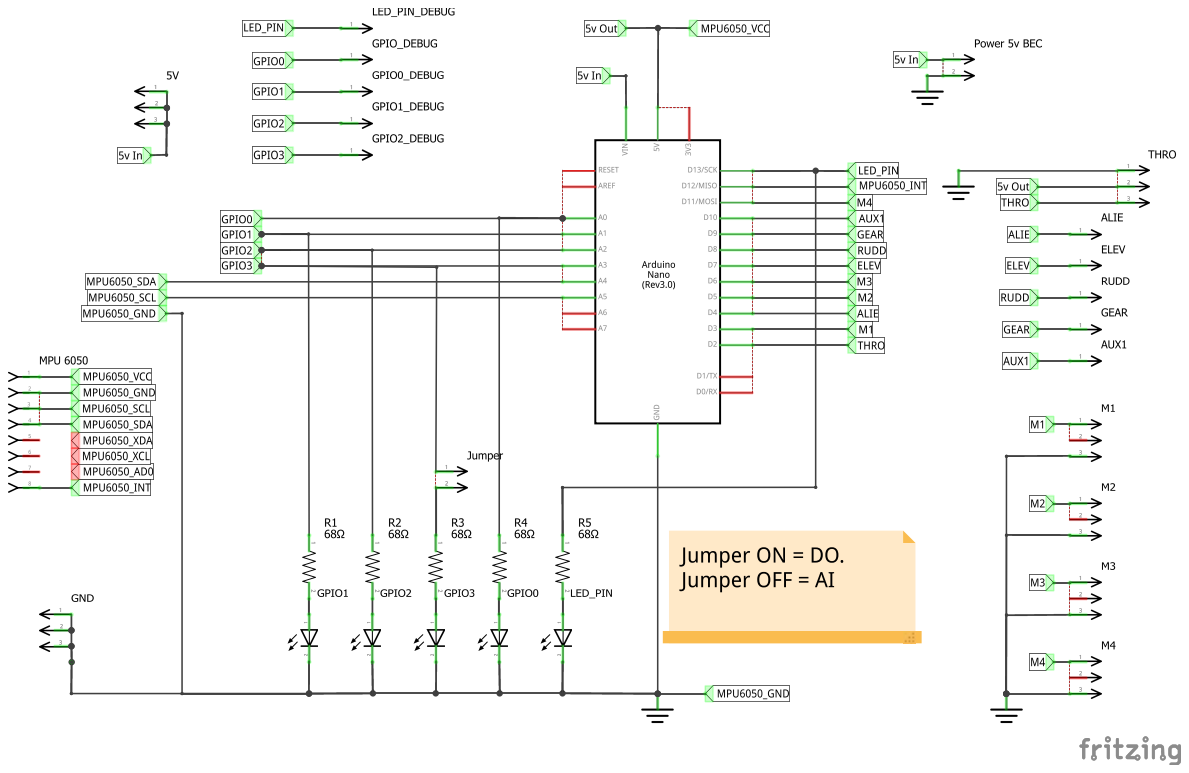
[picture p116: page 1]
