BRAVOTEAM135/Quadcopter/Original Project/Documentation/Circuit Design/Quadcopter Design Ver3/Quadcopter Design Ver3_bb.pdf

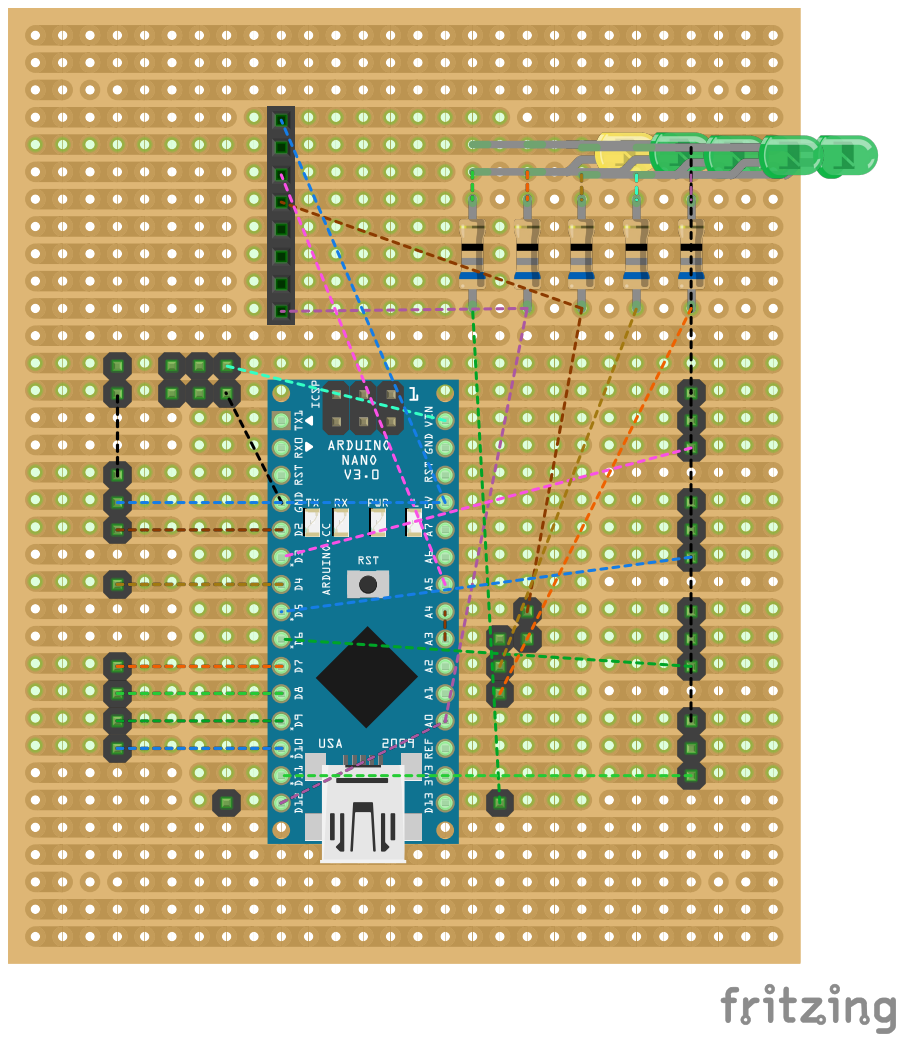
[picture p117: page 1]
