BRAVOTEAM135/Quadcopter/Original Project/Documentation/Circuit Design/Old/Quadcopter Schematic Rev 001_bb.pdf

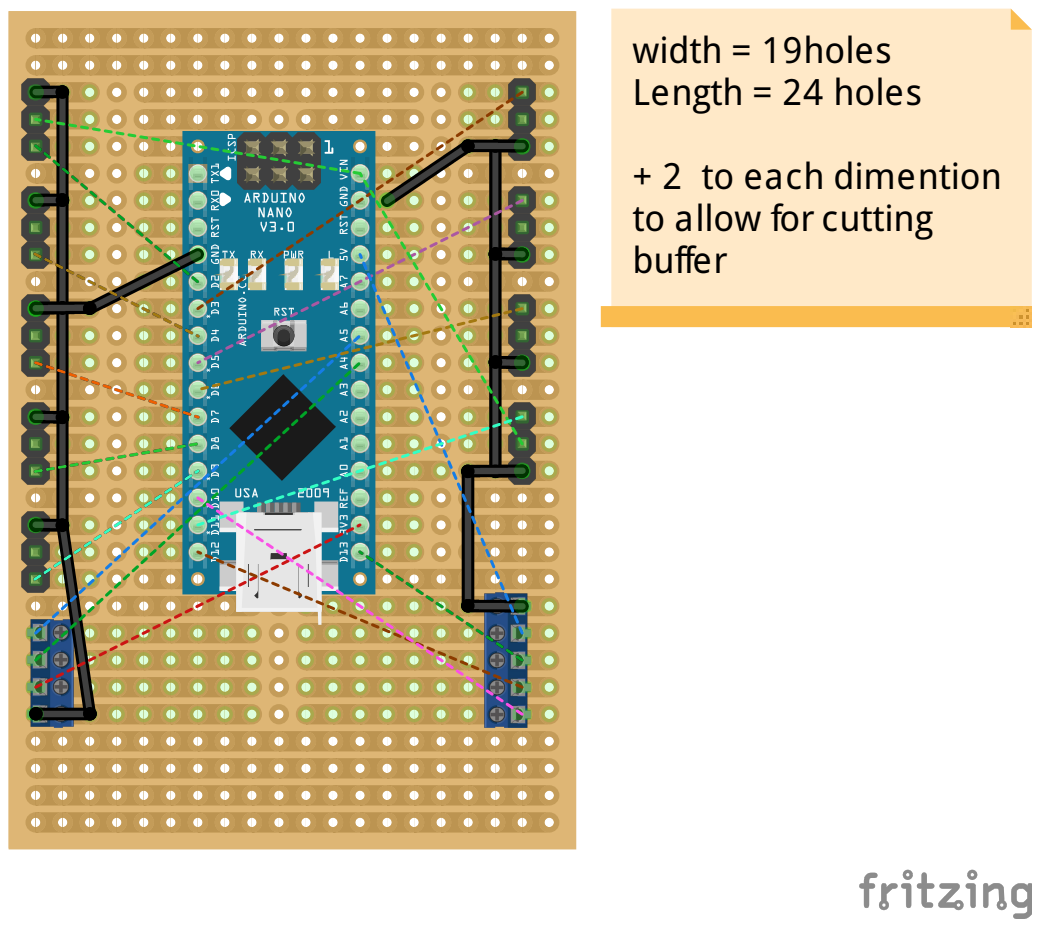
[picture p118: page 1]
width = 19holes Length = 24 holes

+ 2 to each dimention
to allow forcutting
buffer
