BRAVOTEAM135/Quadcopter/Documentation/Circuit Design/Old/Quadcopter Schematic Rev 001_pcb.pdf

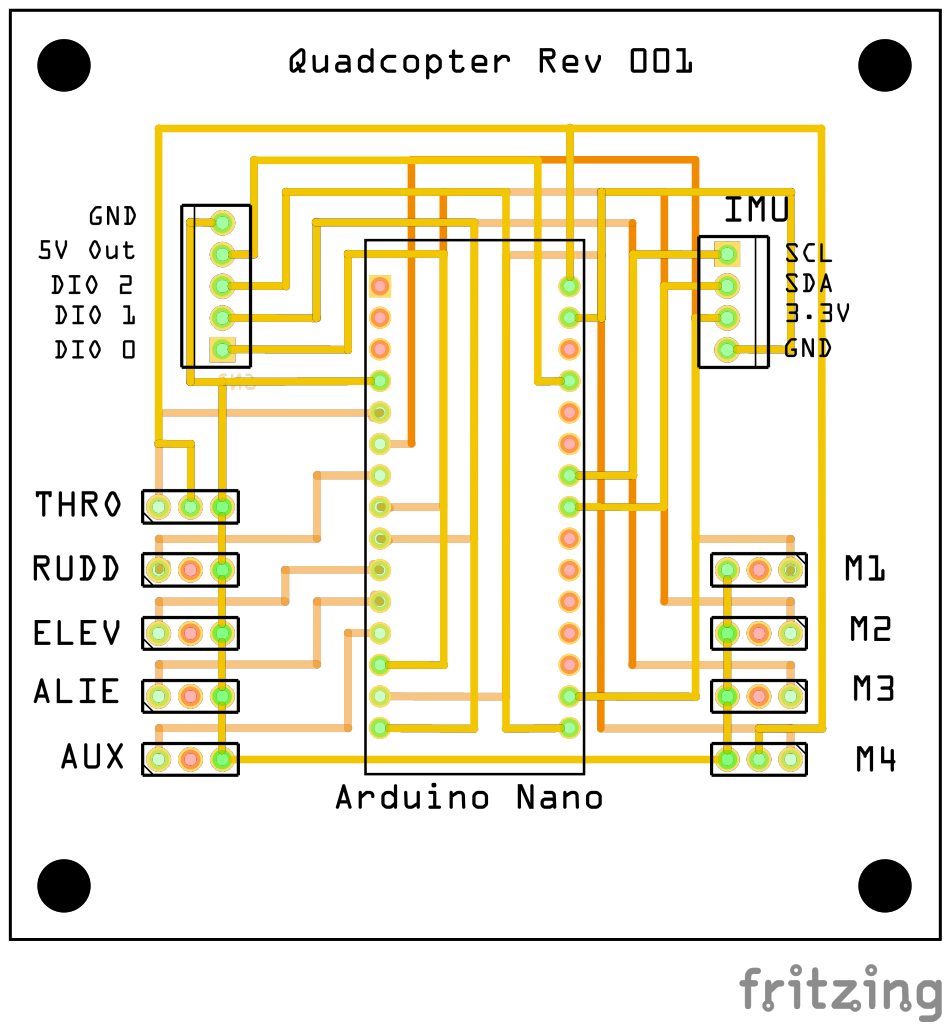
[picture p119: page 1]
