BRAVOTEAM135/Quadcopter/(list of files, drawings)

Other design files:
Documentation/Circuit Design/Quadcopter Design Ver3/Quadcopter Design Ver3.fzz
Documentation/Circuit Design/Quadcopter Schematic Rev 001.fzz
Original Project/Documentation/Circuit Design/Old/Quadcopter Schematic Rev 002.fzz
