BRAVOTEAM135/Quadcopter/Software/Quadcopter Ver3.0/Quadcopter_Ver_3/ISRs.cpp

/*
 * ISRs.cpp
 *
 *  Created on: 20 Dec 2016
 *      Author: Kevin
 */

#include "Sensor.h"

/*
//----- FUNCTIONS -----
// Init ISR for sensor
void init_sensor_isr() {
	pinMode(MPU_INT_PIN, INPUT_PULLUP);
	PCintPort::attachInterrupt(MPU_INT_PIN, mpuISR, RISING);
}
*/


//----- INTERRUPT SERVICE ROUTINES (ISR) -----
//Sensor ISR
/*
void mpuISR() {
	mpuInterrupt = true;
};
*/

// Radio ISRs
