BRAVOTEAM135/Quadcopter/Software/Quadcopter Ver3.0/Quadcopter_Ver_3/ISRs.h

/*
 * ISRs.h
 *
 *  Created on: 20 Dec 2016
 *      Author: Kevin
 */

#ifndef ISRS_H_
#define ISRS_H_

//Init ISRs for Sensor MPU
void init_sensor_isr();

// Init ISRs for Radio
void init_radio_isr();


#endif /* ISRS_H_ */
