BRAVOTEAM135/Quadcopter/Source/Quadcopter/test/sensor_drivers/test_filter.cpp

#include "imuFilter.h"
#include <math.h>
#include <stdint.h>

volatile uint16_t tests_run=0;
volatile uint16_t failed_line=0;
/// Provide the debugger breakpoint used to report completion or the first failed check.
__attribute__((noinline)) void test_done() { asm volatile("nop"); }
/// Count an assertion and stop at test_done() with its source line when it fails.
void check(bool ok, uint16_t line) {
    ++tests_run;
    if (!ok) { failed_line=line; test_done(); for (;;) {} }
}
#define CHECK(value) check((value), __LINE__)

constexpr float G=9.80665f;
constexpr float DEG=0.01745329252f;
/// Return true when two floating-point values differ by less than the chosen tolerance.
bool near(float a, float b, float tolerance=0.003f) { return fabsf(a-b)<tolerance; }

// Independent Euler rotation matrix fixture. Sensor vectors are R-transpose
// times the stationary world references, not generated by filter code.
/// Generate independent acceleration and magnetic fixtures for a chosen Euler pose, timestamp
/// and angular rate.
ImuSample pose(float roll, float pitch, float yaw, uint32_t timestamp,
               MagneticSample& mag, Vector3 rate={0,0,0}) {
    const float cr=cosf(roll), sr=sinf(roll), cp=cosf(pitch), sp=sinf(pitch);
    const float cy=cosf(yaw), sy=sinf(yaw);
    const float r00=cy*cp, r01=cy*sp*sr-sy*cr, r02=cy*sp*cr+sy*sr;
    const float r20=-sp, r21=cp*sr, r22=cp*cr;
    mag={{25*r00+40*r20,25*r01+40*r21,25*r02+40*r22},timestamp};
    return {{G*r20,G*r21,G*r22},rate,timestamp,0};
}

/// Feed stationary fixtures through startup zeroing and check bias and relative-angle results.
void zero(ImuFilter& filter, bool compass, float roll=0, float pitch=0, float yaw=0,
          Vector3 bias={0.02f,-0.01f,0.008f}, uint32_t start=0) {
    filter.init(compass);
    MagneticSample magnetic;
    for (uint16_t i=0; i<=400; ++i) {
        ImuSample sample=pose(roll,pitch,yaw,start+static_cast<uint32_t>(i)*5000,magnetic,bias);
        if (compass && i%8==0) CHECK(filter.updateMagneticField(magnetic));
        bool ready=filter.update(sample);
        if (i<400) CHECK(!ready && !filter.calibrated());
        else CHECK(ready && filter.calibrated());
    }
    CHECK(near(filter.orientation().rollRad,0));
    CHECK(near(filter.orientation().pitchRad,0));
    CHECK(near(filter.orientation().yawRad,0));
    CHECK(filter.orientation().yawReferenced==compass);
    Vector3 estimated=filter.gyroBiasRadS();
    CHECK(near(estimated.x,bias.x,0.00001f));
    CHECK(near(estimated.y,bias.y,0.00001f));
    CHECK(near(estimated.z,bias.z,0.00001f));
}

/// Check stationary zeroing, required compass input and restart of averaging after movement.
void testZeroAndMotionRejection() {
    ImuFilter filter;
    zero(filter,true,3.1415927f,0.2f,0.4f);
    CHECK(!filter.magneticCalibrated()); // Zeroing is not compass calibration.
    ImuOrientation saved=filter.orientation();
    MagneticSample magnetic;
    ImuSample sample=pose(3.1415927f,0.2f,0.4f,saved.timestampUs,magnetic,{0.02f,-0.01f,0.008f});
    CHECK(!filter.update(sample));
    --sample.timestampUs;
    CHECK(!filter.update(sample));
    CHECK(filter.orientation().timestampUs==saved.timestampUs);

    filter.init(false);
    for (uint16_t i=0; i<450; ++i) {
        sample={{0,0,G},{0.3f,0,0},static_cast<uint32_t>(i)*5000,0};
        CHECK(!filter.update(sample));
    }
    CHECK(!filter.calibrated());
    zero(filter,false);

    filter.init(true);
    for (uint16_t i=0; i<450; ++i) {
        sample={{0,0,G},{0,0,0},static_cast<uint32_t>(i)*5000,0};
        filter.update(sample);
    }
    CHECK(!filter.calibrated()); // A required compass cannot silently disappear.

    filter.init(false);
    for (uint16_t i=0; i<500; ++i) {
        sample=pose(i<250 ? 0 : 10*DEG,0,0,static_cast<uint32_t>(i)*5000,magnetic);
        filter.update(sample);
    }
    CHECK(!filter.calibrated()); // Movement must restart the averaging window.
    for (uint16_t i=500; i<=650; ++i) {
        sample=pose(10*DEG,0,0,static_cast<uint32_t>(i)*5000,magnetic);
        filter.update(sample);
    }
    CHECK(filter.calibrated() && near(filter.orientation().rollDeg(),0,0.01f));
}

/// Check relative rotation tracking, timestamp wrap and duplicate/backward sample rejection.
void testRelativeRotationAndWrap() {
    ImuFilter filter;
    zero(filter,false,0,0,0,{0,0,0},0xFFF00000UL);
    uint32_t timestamp=filter.orientation().timestampUs;
    ImuSample sample={{0,0,0},{0,0,0.5f},timestamp,0};
    MagneticSample magnetic;
    for (uint16_t i=0; i<200; ++i) {
        sample.timestampUs+=5000;
        CHECK(filter.update(sample));
    }
    CHECK(near(filter.orientation().yawRad,0.5f));
    CHECK(near(filter.orientation().rollRad,0));
    CHECK(near(filter.orientation().pitchRad,0));
    CHECK(!filter.orientation().yawReferenced);

    zero(filter,true,0,0,179*DEG,{0,0,0});
    timestamp=filter.orientation().timestampUs;
    for (uint16_t i=1; i<=400; ++i) {
        float angle=(179+2.0f*i/400)*DEG;
        sample=pose(0,0,angle,timestamp+static_cast<uint32_t>(i)*5000,magnetic,{0,0,DEG});
        if (i%8==0) CHECK(filter.updateMagneticField(magnetic));
        CHECK(filter.update(sample));
    }
    CHECK(near(filter.orientation().yawDeg(),2,0.1f)); // Wrap, not a -358-degree jump.
    CHECK(filter.orientation().yawReferenced);

    // Start inverted and rotate around the STARTING body's Z axis. The zero
    // must be a relative 3D rotation, not three subtracted absolute Euler angles.
    zero(filter,true,3.1415927f,0,0,{0,0,0});
    timestamp=filter.orientation().timestampUs;
    for (uint16_t i=1; i<=200; ++i) {
        float angle=0.5f*i/200;
        // R = Rx(pi) * Rz(angle).
        magnetic={{25*cosf(angle),-25*sinf(angle),-40},timestamp+static_cast<uint32_t>(i)*5000};
        sample={{0,0,-G},{0,0,0.5f},magnetic.timestampUs,0};
        if (i%8==0) CHECK(filter.updateMagneticField(magnetic));
        CHECK(filter.update(sample));
    }
    CHECK(near(filter.orientation().yawRad,0.5f,0.01f));
    CHECK(near(filter.orientation().rollRad,0));
    CHECK(near(filter.orientation().pitchRad,0));
}

/// Check compass heading correction, gyro drift and behaviour when compass readings stop.
void testCompassDriftAndDropout() {
    ImuFilter filter;
    zero(filter,true,0,0,0,{0,0,0});
    uint32_t timestamp=filter.orientation().timestampUs;
    MagneticSample magnetic;
    ImuSample sample;
    // Add an unlearned 0.02 rad/s bias AFTER startup. The compass should bound
    // heading error near gain*time-constant, rather than let it grow indefinitely.
    for (uint16_t i=1; i<=2000; ++i) {
        sample=pose(0,0,0,timestamp+static_cast<uint32_t>(i)*5000,magnetic,{0,0,0.02f});
        if (i%8==0) CHECK(filter.updateMagneticField(magnetic));
        CHECK(filter.update(sample));
    }
    CHECK(fabsf(filter.orientation().yawRad)<0.03f);
    CHECK(filter.orientation().yawReferenced);

    timestamp=sample.timestampUs;
    for (uint16_t i=1; i<=400; ++i) {
        sample.timestampUs=timestamp+static_cast<uint32_t>(i)*5000;
        CHECK(filter.update(sample)); // Gyro propagation continues without mag.
    }
    CHECK(!filter.orientation().yawReferenced);
    CHECK(filter.orientation().yawRad>0.04f);

    // Reject magnetic overflow/disturbance and duplicate data.
    magnetic={{0,0,0},sample.timestampUs};
    CHECK(!filter.updateMagneticField(magnetic));
    magnetic={{100,100,100},sample.timestampUs};
    CHECK(!filter.updateMagneticField(magnetic));
    magnetic={{25,0,40},sample.timestampUs};
    CHECK(filter.updateMagneticField(magnetic));
    CHECK(!filter.updateMagneticField(magnetic));
}

/// Check tilted compass fusion, external calibration and recovery rules after missing data.
void testTiltCompensationCalibrationAndGaps() {
    ImuFilter filter;
    zero(filter,true,0,0,0,{0,0,0});
    uint32_t timestamp=filter.orientation().timestampUs;
    MagneticSample magnetic;
    ImuSample sample;
    // Static tilted compass data should converge to the right three angles.
    for (uint16_t i=1; i<=2000; ++i) {
        sample=pose(20*DEG,-15*DEG,40*DEG,timestamp+static_cast<uint32_t>(i)*5000,magnetic);
        if (i%8==0) CHECK(filter.updateMagneticField(magnetic));
        CHECK(filter.update(sample));
    }
    CHECK(near(filter.orientation().rollDeg(),20,0.1f));
    CHECK(near(filter.orientation().pitchDeg(),-15,0.1f));
    CHECK(near(filter.orientation().yawDeg(),40,0.1f));

    // A missing-data gap must retain the ORIGINAL zero when compass recovery
    // can reconstruct orientation. It must not silently zero at the new pose.
    sample.timestampUs+=100000;
    magnetic.timestampUs=sample.timestampUs;
    CHECK(filter.updateMagneticField(magnetic));
    CHECK(filter.update(sample));
    CHECK(near(filter.orientation().yawDeg(),40,0.1f));
    sample.angularVelocityRadS.x=NAN;
    sample.timestampUs+=5000;
    CHECK(!filter.update(sample) && !filter.orientation().valid);

    MagneticCalibration calibration;
    calibration.offsetMicrotesla={5,-3,2};
    calibration.matrix[0][1]=0.2f;
    CHECK(filter.setMagneticCalibration(calibration));
    CHECK(filter.magneticCalibrated() && !filter.calibrated());
    calibration.matrix[0][0]=0;
    CHECK(!filter.setMagneticCalibration(calibration));
    filter.init(true);
    for (uint16_t i=0; i<=400; ++i) {
        sample=pose(0,0,0,static_cast<uint32_t>(i)*5000,magnetic);
        magnetic.fieldMicrotesla.x+=5-0.2f*magnetic.fieldMicrotesla.y;
        magnetic.fieldMicrotesla.y-=3;
        magnetic.fieldMicrotesla.z+=2;
        if (i%8==0) CHECK(filter.updateMagneticField(magnetic));
        filter.update(sample);
    }
    CHECK(filter.calibrated() && near(filter.orientation().yawRad,0));

    timestamp=sample.timestampUs;
    for (uint16_t i=1; i<=2000; ++i) {
        sample=pose(20*DEG,-15*DEG,40*DEG,timestamp+static_cast<uint32_t>(i)*5000,magnetic);
        magnetic.fieldMicrotesla.x+=5-0.2f*magnetic.fieldMicrotesla.y;
        magnetic.fieldMicrotesla.y-=3;
        magnetic.fieldMicrotesla.z+=2;
        if (i%8==0) CHECK(filter.updateMagneticField(magnetic));
        CHECK(filter.update(sample));
    }
    CHECK(near(filter.orientation().yawDeg(),40,0.1f));

    zero(filter,false,0,0,0,{0,0,0});
    sample={{0,0,G},{0,0,0},filter.orientation().timestampUs+100000,0};
    CHECK(!filter.update(sample) && !filter.orientation().valid);
    // Gyro-only recovery needs an explicit new zero; missing yaw is unknowable.
    sample.timestampUs+=5000;
    CHECK(!filter.update(sample));
}

/// Check that close invalidates tracking, rejects updates and permits explicit
/// reinitialization.
void testCloseAndReinitialize() {
    ImuFilter filter;
    zero(filter, true);
    filter.close();
    filter.close();
    CHECK(!filter.calibrated() && !filter.orientation().valid);
    MagneticSample magnetic;
    ImuSample sample = pose(0, 0, 0, 3000000UL, magnetic);
    CHECK(!filter.updateMagneticField(magnetic));
    CHECK(!filter.update(sample));
    filter.reset(); // Reset cannot reopen a closed filter.
    CHECK(!filter.update(sample));
    MagneticCalibration calibration;
    CHECK(filter.setMagneticCalibration(calibration));
    CHECK(!filter.update(sample));
    zero(filter, false);
    CHECK(filter.calibrated() && filter.orientation().valid);
}

/// Run this file's simulator checks, then stop at the debugger completion breakpoint.
int main() {
    testZeroAndMotionRejection();
    testRelativeRotationAndWrap();
    testCompassDriftAndDropout();
    testTiltCompensationCalibrationAndGaps();
    testCloseAndReinitialize();
    test_done();
    for (;;) {}
}
