BRAVOTEAM135/Quadcopter/Original Project/Software/Quadcopter Ver3.0/Radio_Test_Harness/New_Radio.h

/*
 * New_Radio.h
 *
 *  Created on: 12 Feb 2017
 *      Author: Kevin
 */

#ifndef NEW_RADIO_H_
#define NEW_RADIO_H_
#include <Arduino.h>
void init_channels();

// Global Variables





#endif /* NEW_RADIO_H_ */
