BRAVOTEAM135/Quadcopter/(commit log)

2017-01-04 Added Version 3.0 of Quadcopter Code. Developed in Eclipse and is a good version. TODO: - Tune PID
2017-02-11 Kr: Fixed timing issue with PWM read. Added the schemeatic and circuit design to the repo
2017-03-19 Upgraded the Radio and timer module. Tested in test harness commit beofre pushing into full projct
2017-03-19 New Radio module written an tested Sensor module working Saftey module Written Good place and ready for garage testing
2017-05-05 Roll and Pitch roughly tuned trying to tune yaw
2019-05-25 havent commit in a while Working on improving the sensor readouts
2019-05-25 - Worked on the IMU sensor portion, happy with these readings - Worked on the Radio part now readining in throttle 1000-2000 and everything else +/-1
2019-05-26 - Scaled the Radio values - replaced if debug with #ifdef statements - Ready for PID tuning - Sensor values look good and correct - Radio values look good - PID looks good
2026-10-30 before simplyfying + IMU + imu filter
2026-10-31 Simplify task loop and IMU driver interfaces
2026-10-31 Add four-channel ESC PWM driver with individual motor control
